yamaha252/Cricket/firmware/README.md

# Прошивка

Свой механизм поиска (шаг 1 из D-32) в `app/`: собирается под свою плату `cricket_tag` и под nRF54L15 DK, на железе не проверен. Поведение описано в [docs/concept.md](../docs/concept.md#режимы-работы), протокол рекламы и GATT — в [docs/protocol.md](../docs/protocol.md).

Прошивка своя, под MIT (D-32). Everytag (GPLv3) — только справочник: его код не копируется, форматы пакетов берутся из открытых описаний.

Порядок работ (D-32):

1. Свой механизм поиска на nRF54L15 DK: наборы рекламы Cricket Coded и Cricket 1M, режимы, драйверы, команда «пищи» из приложения.
2. Позже — наборы Apple Find My и Google Find Hub; координаты из сетей опрашивает приложение (D-33, [docs/app.md](../docs/app.md#краудсорсинговые-сети)).

План:

- Zephyr / nRF Connect SDK v3.4.2 (см. раздел «Версия SDK»), модуль Insight SiP ISP2454-LX (nRF54L15, 1,5 МБ RRAM, 256 КБ ОЗУ; D-29). Две цели сборки: своя плата `cricket_tag/nrf54l15/cpuapp` (описание в `boards/cricket/cricket_tag/`) и отладочная nRF54L15 DK `nrf54l15dk/nrf54l15/cpuapp`.
- Выводы модуля: карта в [hardware/cricket-tag/README.md](../hardware/cricket-tag/README.md#схема) (D-29). На NFC-выводах P1.02/P1.03 — I2C: на nRF54L их освобождает регистр NFCT.PADCONFIG (после сброса 1 — режим NFC), а Zephyr сбрасывает его только на nRF54H, поэтому это делает `board.c` платы. На P2 нет прерываний: CHRG_N читать опросом. Пищалка — PWM20 на P1.04; GRTC PWM (128 Гц) не годится.
- Свои наборы рекламы: Cricket Coded (Coded PHY S8, +8 dBm, подключаемый) и Cricket 1M для телефонов без Coded PHY.
- Наборы рекламы одновременно, через extended advertising: у каждого набора свой identity-адрес (`bt_id_create`, `CONFIG_BT_ID_MAX`, `CONFIG_BT_EXT_ADV_MAX_ADV_SET`), адрес Apple меняется через `bt_id_reset` при остановленном наборе. У Everytag одна реклама за раз и смена публичного адреса всего контроллера — так делать не нужно.
- Apple Find My (позже): формат OpenHaystack — шаблон рекламы 31 байт, адрес из первых 6 байт публичного ключа P-224 (старшие биты 11, статический случайный адрес), до N ключей со сменой по таймеру. Ключи генерирует приложение при привязке и записывает в маячок по своему GATT-сервису.
- Google Find Hub (позже): формат FHN с ключом, полученным приложением; сначала постоянный EID, сменный EID по спецификации FHN (AES, secp160r1, micro-ecc) — доработка, для неё нужны непрерывные часы (SHIP как System ON с GRTC).
- Режимы ON_DRONE, ESCALATE, ALARM, BEACON, STANDBY, LOW_BAT, SHIP.
- Признаки падения: MSP_STATUS (armed) по UART, удар по LIS2DH12, нарастание тревоги как запасной вариант.
- LIS2DH12 на I2C по адресу 0x19 (SA0 на VDD_IO), прерывание по удару на INT1 (ACC_INT1).
- Пищалка: ШИМ на BUZ_DIN, режим PAM8904E выводом BUZ_EN1 (0 — 1x, 1 — 3x; EN2 на VBAT, D-28). У CPT-1117-83 (D-27) громкость высокая широкой полосой 3–8 кГц: частоту или качание частоты подобрать замером.
- Без 5 В от полётника вывод UART_TX перевести во вход, чтобы не питать полётник через его защитные диоды, и выключить UART целиком: включённый приёмник UARTE держит HFCLK (сотни мкА), а UART_RX через 1 кОм висит на обесточенном полётнике.
- Режим 3x PAM8904E (BUZ_EN1 = 1) на полном аккумуляторе даёт размах до 25 В — ровно предел CPT-1117-83. Пока идёт заряд (VBAT до 4,24 В), использовать 1x или не пищать.
- Радио выключено, пока дрон armed: не мешать ELRS 2,4 ГГц.
- Чтение GPS с полётника по MSP, последние координаты в рекламе Cricket.
- Кнопка: выключение тревоги, привязка, режим хранения, загрузчик.
- Обновление прошивки по BLE (MCUboot + SMP) только в окне DFU: кнопка зажата 3 с с подачи питания (см. «Обновление прошивки»).
- Источник LFCLK: кварц 32,768 кГц внутри модуля (LFXO, нагрузочные ёмкости внутренние). Datasheet ISP2454 R7, разд. 2.5, рекомендует 19 пФ и предлагает дописать 19000 в binding `nordic,nrf54l-lfxo.yaml`. В SDK v3.4.2 этого мало: `soc/nordic/nrf54l/soc.c` проверяет `BUILD_ASSERT`, что значение не больше 18 000 фФ (предел внутренних конденсаторов nRF54L). Поэтому в плате стоит 18 пФ — ближайшее допустимое; уход частоты проверить на первых платах. HFXO 32 МГц: в datasheet значения нет, стоит 15 пФ, как у DK. DC/DC включён: токи в datasheet даны с ним.
- Сканирование в приложении на Pixel: режим PHY_LE_ALL_SUPPORTED, не только Coded. Подробности в [docs/app.md](../docs/app.md).

## Заготовка `app/`

Сборка (SDK v3.4.2, sysbuild, результат в `firmware/build/`, он в `.gitignore`):

```bash
firmware/build.sh
```

Аргументы: плата (по умолчанию `nrf54l15dk/nrf54l15/cpuapp`), аргументы `west build` и после `--` аргументы CMake, например `firmware/build.sh cricket_tag/nrf54l15/cpuapp -p always`. Скрипт передаёт `BOARD_ROOT=firmware`, чтобы находилась своя плата. Прошивка по SWD: `west flash -d firmware/build` внутри toolchain-окружения — sysbuild заливает и MCUboot, и подписанное приложение.

Проверено 2026-11-11: обе платы собираются с MCUboot без предупреждений в нашем коде. Предупреждения SDK: `Deprecated symbol NRF_PLATFORM_LUMOS` и `BOOT_MAX_IMG_SECTORS` из конфигурации MCUboot; без закрытого ключа — ещё об отладочном ключе подписи (см. «Обновление прошивки»). Объём — в разделе «Объём флеш-памяти»; DK с `msp-dk.overlay` тоже собирается.

### Плата `cricket_tag`

`boards/cricket/cricket_tag/` — описание платы по карте выводов из [README платы](../hardware/cricket-tag/README.md#схема):

| Узел | Выводы | Что в описании |
|---|---|---|
| MSP | UARTE30: TX P0.02, RX P0.00 | 115200; в состоянии sleep выводы отключены, чтобы не питать обесточенный полётник |
| LIS2DH12 | TWIM21: SDA P1.02, SCL P1.03; INT1 P1.11 | `st,lis2dh12` на 0x19, 400 кГц, подтяжки на плате |
| Пищалка | PWM20 канал 0 на P1.04; EN1 P2.05 | `buzzer-pwm`, `buz-en1-gpios` в `zephyr,user` |
| Вспышка | P2.02 (затвор 2N7002) | `flash-led`, `led0` |
| Кнопка | P1.05 на GND, подтяжка внутри | `user-button`, `sw0`, `mcuboot-button0` |
| VIN_SENSE | P0.03 | `vin-sense-gpios`: прерывание, пробуждение из System OFF |
| CHRG_N | P2.04, подтяжка внутри | `chrg-gpios`, опросом (на P2 нет прерываний) |
| VBAT | AIN3 (P1.07), делитель 1 МОм / 1 МОм | `io-channels`, усиление 1/4, выборка 40 мкс (максимум) из-за делителя 500 кОм с C3 100 нФ |

Лога по UART на плате нет: UARTE30 занят полётником. В отладочной сборке лог идёт по SWD через RTT (включается по умолчанию для этой платы в `app/Kconfig`); RTT держит ток высоким до передёргивания питания, ток мерить только в release-сборке (см. «Низкое потребление»).

На плате приложение берёт 5 В с VIN_SENSE (прерывание, после SHIP появление 5 В будит маячок), заряд — опросом CHRG_N с флагом в рекламе; пока идёт заряд, пищалка работает только в 1x. Долгое удержание кнопки при наличии 5 В в SHIP не переводит: 5 В разбудили бы маячок сразу.

| Файл | Что делает |
|---|---|
| `src/status.c` | состояние маячка и сборка 22 байт полезной нагрузки; ID — CRC32 от FICR DEVICEID |
| `src/adv.c` | наборы Cricket Coded (extended, Coded S8) и Cricket 1M (legacy, с именем в ответе на сканирование), оба подключаемые, +8 dBm через vendor-команду HCI; интервалы по режимам, перезапуск после соединения |
| `src/gatt.c` | сервис Cricket: состояние (read/notify), управление (FIND, SILENCE, DFU, FORGET, DEFAULTS), настройки |
| `src/config.c` | настройки Bluetooth из приложения: имя, мощность и интервалы наборов по режимам, RSSI на 1 м; хранятся в разделе настроек ([protocol.md](../docs/protocol.md#настройки)) |
| `src/buzzer.c` | ШИМ пищалки и вспышка светодиода по шаблонам; вывод EN1 PAM8904E (1x/3x) — если описан в `zephyr,user` |
| `src/battery.c` | VBAT через делитель (`zephyr,user`: `io-channels`, `vbat-full-ohms`, `vbat-output-ohms`); на DK не измеряется, LOW_BAT не срабатывает |
| `src/inputs.c` | кнопка: короткое, удержание 3 с, 8 с (решение по отпусканию); на DK кнопки 1–3 имитируют 5 В, armed и удар |
| `src/msp.c` | MSP v1 к полётнику по `msp-uart`: MSP_BOXIDS (какой бит флагов — ARM; пока disarmed, перечитывается раз в 10 с — полётник могли перенастроить), MSP_STATUS каждые 250 мс, MSP_RAW_GPS каждую секунду; только при 5 В, без них UART приостановлен (`CONFIG_CRICKET_MSP`) |
| `src/impact.c` | удар по LIS2DH12 (`accel0`): «любое движение» на INT1 с фильтром высоких частот, порог `CONFIG_CRICKET_IMPACT_MG` (8 g); датчик работает только при 5 В, иначе приостановлен (`CONFIG_CRICKET_IMPACT`) |
| `src/dfu.c` | обновление по BLE: подтверждение нового образа для MCUboot при старте, фильтр команд SMP вне окна DFU |
| `src/wdog.c` | сторожевой таймер WDT31: 30 с, кормится тиком режимов, останавливается перед System OFF |
| `src/pair.c` | привязка телефона: окно привязки 60 с, отказ в привязке вне окна, ключи в разделе настроек (ZMS), команда FORGET ([protocol.md](../docs/protocol.md#привязка-и-защита)) |
| `src/modes.c` | режимы ON_DRONE…SHIP по [concept.md](../docs/concept.md#режимы-работы), всё в системной очереди работ |

Время режимов (`modes.c`): ESCALATE 45 с с тихим чириканьем раз в 5 с, затем ALARM; ALARM — серия писков раз в 5 с, через 45 мин BEACON; BEACON — писк раз в минуту; удар считается, если был за 10 с до пропажи 5 В; аварийный конец полёта при 5 В (failsafe, дизарм в воздухе, перезагрузка полётника, 30 с без связи с пультом после полёта) — ESCALATE; 5 В, вернувшееся за 10 с после пропажи в полёте, тревогу не гасит; armed без связи — реклама с координатами каждые 2 с; предполётный писк через 5 с после 5 В; правила в [concept.md](../docs/concept.md#признаки-падения); данные MSP считаются свежими 5 с (MSP повторяет состояние armed раз в секунду); при появлении 5 В прошлое состояние armed и удар забываются, до ответа MSP дрон считается disarmed; LOW_BAT ниже 3,4 В, SHIP ниже 3,2 В — только без 5 В, и батарея не измеряется, пока пищит бипер (просадка под нагрузкой).

### MSP: настройка полётника

На полётнике UART, к которому припаян маячок, включить MSP на 115200: в Betaflight — вкладка Ports, колонка Configuration/MSP; в INAV — то же. Маячок спрашивает:

| Команда | Код | Что берёт |
|---|---|---|
| MSP_BOXIDS | 119 | номера битов режимов ARM (постоянный ID 0), BEEPER (13), FAILSAFE (27) в флагах |
| MSP_STATUS | 101 | флаги режимов: `uint32` со смещения 6, остальные байты после счётчика на смещении 15 → armed, BEEPER, FAILSAFE; за ними флаги запрета arm Betaflight: FAILSAFE (бит 1), RX_FAILSAFE (бит 2, нет связи), CRASH_DETECTED (бит 6) |
| MSP_RAW_GPS | 106 | fix, число спутников, широта и долгота (1e-7°), скорость (см/с, смещение 12); координаты берутся при fix ≥ 2 и не меньше 4 спутников |

Номера режимов и раскладка MSP_STATUS сверены с исходниками Betaflight 4.5 (`msp_box.c`, `msp.c`, `runtime_config.h`, `failsafe.c`) 2026-11-11. INAV в MSP_STATUS флаги запрета arm не отдаёт: потеря связи там не видна, остальное то же (не сверено с исходниками INAV).

Чтобы включать писк с пульта, в Betaflight на вкладке Modes назначить режим BEEPER на AUX-тумблер ([concept.md](../docs/concept.md#тумблер-beeper-на-пульте)).

Без ответов MSP маячок полагается на удар и нарастание тревоги (ESCALATE). На полётнике формат не проверен.

### Удар: порог

Вибрация моторов (для полёта без MSP): сумма дисперсий по осям за 1 с выше (0,3 g)², включается после 2 таких секунд, выключается после 3 спокойных. Опрос 50 Гц ниже частот моторов, но разброс остаётся; порог проверить на дроне.

Свободное падение: модуль ускорения ниже 0,4 g дольше 250 мс, опрос 50 Гц, пока есть 5 В (выходные регистры без фильтра, тяжесть видна). В режиме low-power 16 g шаг датчика ~190 мг, так что порог — около двух шагов; проверить на броске.

Порог 8 g по изменению ускорения (фильтр высоких частот убирает тяжесть), датчик 16 g, 400 Гц, режим low-power. Вибрации в полёте и жёсткая посадка не должны его превышать, удар при падении — должен; подобрать на дроне (`CONFIG_CRICKET_IMPACT_MG`). Не проверено: срабатывает ли событие «high» LIS2DH12 по модулю ускорения, то есть на удары в обе стороны по оси.

### Проверка на nRF54L15 DK

| Элемент DK | Роль |
|---|---|
| LED1 (P1.10, PWM20) | пищалка: светится в такт; пьезоизлучатель можно подключить к P1.10 |
| LED0 | вспышка |
| Button 0 | кнопка маячка |
| Button 1 | имитация 5 В: вкл/выкл |
| Button 2 | имитация armed по MSP: вкл/выкл (повторяется раз в секунду, как настоящий MSP) |
| Button 3 | имитация удара |
| VCOM (UART) | лог, 115200 |

Сценарии: при включении — STANDBY. Button 1 → ON_DRONE; Button 2 → armed, реклама выключается; Button 1 → 5 В пропало → ALARM. Без Button 2 и Button 3 пропажа 5 В даёт ESCALATE, а через 45 с — ALARM. Короткое нажатие Button 0 гасит тревогу. Рекламу видно в nRF Connect for Mobile: Manufacturer data `0xFFFF`, на Pixel — сканирование 1M и Coded одновременно ([app.md](../docs/app.md)). Команда FIND — запись `01 0A` в характеристику управления (пищать 10 с). Вне тревоги телефон сначала надо привязать: удержать Button 0 3 с, затем записать команду — nRF Connect предложит привязку. В ESCALATE, ALARM и BEACON FIND (до 60 с) принимается и без привязки.

MSP можно проверить на DK с настоящим полётником до прихода плат: `msp-dk.overlay` включает UART30 (TX маячка P0.00 → RX полётника, RX маячка P0.01 ← TX полётника, общая земля). Сначала в Board Configurator поставить VDD DK 3,3 В (по умолчанию 1,8 В, а логика полётника 3,3 В). Сборка:

```bash
firmware/build.sh nrf54l15dk/nrf54l15/cpuapp -p always -- -DEXTRA_DTC_OVERLAY_FILE=msp-dk.overlay
```

5 В по-прежнему имитирует Button 1: MSP опрашивается, только пока «5 В есть». Так проверяются тумблер BEEPER и failsafe: выключить пульт у armed полётника без пропеллеров, полётник уйдёт в failsafe и disarm-ится, маячок через 45 с чириканья перейдёт в ALARM.

Не проверено на железе: работают ли два подключаемых набора на одном адресе одновременно (стек Zephyr это допускает, каждый набор занимает свой объект соединения, `CONFIG_BT_MAX_CONN=2`); фактическая мощность +8 dBm (лог `TX power` при старте); выход из System OFF по Button 0.

### Сторожевой таймер

WDT31 с таймаутом 30 с перезагружает маячок, если встала системная очередь работ: его кормит тик режимов, который идёт не реже раза в 10 с во всех режимах. Таймер считает и во сне, пауза только когда отладчик остановил процессор. Перед System OFF (SHIP) он останавливается — на nRF54L у WDT есть STOP, — иначе будил бы маячок из хранения. После сброса по сторожевому таймеру в логе предупреждение `previous reset by the watchdog`; маячок стартует в STANDBY или ON_DRONE, как при подключении аккумулятора.

### Низкое потребление

Что сделано для тока в покое:

- Радио, пищалка и вспышка работают по событиям; процессор просыпается на тик режимов раз в 10 с (в ESCALATE и ALARM — раз в секунду).
- UART к полётнику и LIS2DH12 приостановлены без 5 В (`msp.c`, `impact.c`).
- ШИМ пищалки при скважности 0 останавливает периферию (драйвер nRF PWM), PAM8904E выключен низким DIN и EN1.
- Кнопка, VIN_SENSE и INT1 акселерометра ждут фронта через механизм SENSE порта (`sense-edge-mask` в описании платы и в overlay DK), а не через каналы GPIOTE.
- LFCLK от кварца модуля, DC/DC включён (описание платы).
- **Release-сборка** без лога, консоли, RTT и баннера: `app/release.conf`.

```bash
firmware/build.sh cricket_tag/nrf54l15/cpuapp -p always -- -DEXTRA_CONF_FILE=release.conf
```

Как мерить: Power Profiler Kit II в режиме источника вместо аккумулятора на площадках J2 (3,7–4,0 В), провода полётника не подключены, SWD отсоединён; после прошивки снять и снова подать питание. На DK — штатные выводы для измерения тока nRF (Current measurement, см. руководство DK), тоже release-сборка. Сравнить с оценкой [concept.md](../docs/concept.md#энергобюджет-оценка-уточнить-замером): STANDBY ~20–26 мкА, ALARM без пищалки ~65–93 мкА, SHIP ~4–5 мкА (из них модуль 0,6 мкА, остальное утечки TP4054, делители и LDO).

Не проверено: ток не измерялся — ни DK, ни платы ещё нет.

### Обновление прошивки

MCUboot (sysbuild, `app/sysbuild.conf`) с двумя слотами и обменом: новый образ пишется во второй слот, при перезагрузке MCUboot меняет слоты и запускает его в пробном режиме. Прошивка подтверждает образ сама, если поднялись Bluetooth и режимы (`dfu.c`); если новый образ упадёт раньше, после сброса MCUboot вернёт старый.

По воздуху обновление идёт через MCUmgr SMP (сервис SMP Bluetooth, группы image и os, MTU 498). Команды SMP принимаются только в **окне DFU**: кнопку зажать при подаче питания (подключение аккумулятора, сброс или пробуждение из SHIP) и держать 3 с — два коротких писка, в рекламе флаг 6. Окно длится 5 мин и продлевается на минуту каждой принятой командой. Вне окна SMP отвечает «доступ запрещён». Кроме того, SMP работает только по шифрованному соединению, то есть с привязанного телефона. Окно DFU, открытое кнопкой при подаче питания, заодно открывает окно привязки, чтобы обновить можно было и с нового телефона; с уже привязанного телефона окно DFU открывает команда `0x03`.

Как обновить:

1. Собрать: `firmware/build.sh cricket_tag/nrf54l15/cpuapp`. Пакет для обновления — `firmware/build/dfu_application.zip` (подписанное приложение `firmware/build/app/zephyr/zephyr.signed.bin`).
2. Открыть окно DFU на маячке.
3. В приложении nRF Connect Device Manager (Android, iOS) выбрать маячок `Cricket`, Image → Upload, пакет `dfu_application.zip`, режим Test and Confirm. Или с компьютера: `mcumgr --conntype ble --connstring peer_name=Cricket image upload zephyr.signed.bin`, затем `image test <хэш>` и `reset`.

**Ключ подписи — свой, ed25519** (2026-11-11). Закрытый ключ лежит вне репозитория: `~/.cricket/keys/mcuboot-ed25519.pem` (права 600) на компьютере владельца; другой путь задаёт переменная `CRICKET_MCUBOOT_KEY`. `build.sh` передаёт его в `SB_CONFIG_BOOT_SIGNATURE_KEY_FILE`; если файла нет, сборка подписывается открытым отладочным ключом SDK и пишет об этом. Открытая часть — в репозитории, `keys/mcuboot-ed25519.pub.pem`: по ней видно, какому ключу доверяют маячки.

- Публичный ключ зашит в MCUboot. Маячок, прошитый с ним по SWD, принимает по воздуху только образы, подписанные этим закрытым ключом. Сменить ключ на выпущенном маячке можно только по SWD.
- **Потеря закрытого ключа** — обновление по воздуху для всех выпущенных маячков пропадает, останется только SWD. Нужна резервная копия вне компьютера (менеджер паролей или зашифрованный носитель).
- Утечка ключа — любой сможет сделать образ, который маячок примет в окне DFU.
- Проверка образа: `imgtool.py verify -k ~/.cricket/keys/mcuboot-ed25519.pem firmware/build/app/zephyr/zephyr.signed.bin` (внутри toolchain, скрипт в `bootloader/mcuboot/scripts/` SDK). Проверено 2026-11-11: образ проходит с нашим ключом и не проходит с ключом SDK, в `autogen-pubkey.c` MCUboot — наш открытый ключ.

Не проверено на железе: загрузка образа, обмен слотов, откат, скорость передачи.

### Шлюз Bluetooth → MSP для Betaflight Configurator (план)

Цель: настраивать полётник с телефона или ноутбука через маячок, без USB и без отдельного Bluetooth-адаптера на свободном UART. Маячок уже подключён к UART полётника с MSP; шлюз пересылает байты между Bluetooth и этим UART.

**Что известно** (код Configurator, ветка `master`, коммит `9c8b310` от 2026-11-09, `src/js/protocols/devices.ts` и `WebBluetooth.ts`):
- Configurator знает Bluetooth-адаптеры по сервису; среди них «Nordic NRF» — Nordic UART Service (NUS), `6e400001-b5a3-f393-e0a9-e50e24dcca9e`. Подключение через Web Bluetooth (Chrome на компьютере и на Android), в нативных сборках — Capacitor и Tauri.
- **Характеристики Configurator берёт наоборот относительно Nordic:** пишет в `…0003` и ждёт уведомлений от `…0002`. У Nordic (`nus.c` в SDK) наоборот: `…0002` (RX) принимает запись, `…0003` (TX) шлёт уведомления. Значит, пример SDK в чистом виде с Configurator, скорее всего, не заработает: запись в характеристику без свойства write отклоняется. В своей реализации обе характеристики делаются write + notify: запись в любую уходит в UART, уведомления идут по той, на которую подписан телефон. Так работают и Configurator, и обычные NUS-терминалы (nRF Connect, nRF Toolbox).

**Готовое в nRF Connect SDK и почему не целиком:**
- Пример `samples/bluetooth/peripheral_uart` — мост NUS ↔ UART, и библиотека `CONFIG_BT_NUS`.
- Защита библиотеки: либо никакой, либо `BT_NUS_AUTHEN` (привязка с защитой от подмены, MITM). Привязка Just Works у маячка (нет экрана и клавиатуры) этот уровень не даёт, поэтому сервис описывается свой, с теми же UUID и требованием шифрования (~40 строк).
- Пример считает UART своим, а у нас по нему же идёт опрос MSP.
- Пример и библиотека под лицензией Nordic 5-Clause: библиотеку из SDK подключать можно, код примера в MIT-репозиторий не копируется.

**Как сделать** (~300–400 строк, +3–5 КБ флеш-памяти, 1–2 КБ ОЗУ):
- Сервис NUS с шифрованием (только привязанный телефон; первый раз — в окне привязки, Chrome вызовет системную привязку).
- Кольцевые буферы в обе стороны, передача в UART по прерываниям (сейчас `msp.c` шлёт байты с ожиданием); ответы полётника склеиваются в уведомления по размеру MTU.
- Пока телефон подписан, маячок сам полётник не опрашивает, но разбирает ответы, которые идут Configurator: так armed, failsafe и BEEPER остаются известны. Добавить разбор MSP_STATUS_EX (150): Configurator, вероятно, спрашивает его. Кадры MSP v2 (`$X`) и текст CLI пересылаются как есть, разбор их пропускает.
- Доступ только при 5 В и на земле; при взлёте соединение рвётся (D-37).

**Чего шлюз не даст:** прошивку полётника (Betaflight прошивается через USB DFU) и быстрое чтение blackbox (порт 115200, ~11 КБ/с: 16 МБ — около 25 мин).

**Порядок:**
1. На DK проверить то, что уже написано: MSP, failsafe, BEEPER (`msp-dk.overlay`).
2. Там же собрать `peripheral_uart` с overlay на UART к полётнику, 115200, и попробовать Configurator (профиль «Nordic NRF») из Chrome на компьютере и на Pixel 7 Pro. Ожидается отказ из-за перевёрнутых характеристик; если так — поменять в копии примера роли характеристик (локально, не в репозитории) и повторить. Проверить привязку, таймауты Configurator и скорость.
3. Шлюз в своей прошивке, проверка на DK, затем на плате.

### Не сделано

- Шлюз Bluetooth → MSP для Betaflight Configurator — план выше.
- Замер тока и подбор интервалов рекламы и мощности по умолчанию по нему (менять их можно уже из приложения, характеристика «Настройки»).
- Обратная связь при удержании кнопки (писк на 3 и 8 с).
- Наборы Apple и Google (D-32, D-33).

## Объём флеш-памяти

Своя прошивка, проверено 2026-11-11 (SDK v3.4.2, MCUboot с двумя слотами, OTA через SMP, MSP и LIS2DH12, привязка с ключами в ZMS, сторожевой таймер, настройки Bluetooth, тревога по failsafe и тумблер BEEPER, D-36):

| Часть | `cricket_tag` | DK | Доступно |
|---|---|---|---|
| MCUboot | 38,4 КБ | 39,5 КБ | 62 КБ |
| Приложение (слот), отладка | 249,9 КБ | 244,4 КБ | 695,9 КБ (712 560 байт) |
| Приложение (слот), release | 214,2 КБ | 210,9 КБ | 695,9 КБ |
| ОЗУ приложения, отладка | 58 КБ | — | 256 КБ |

Ещё 36 КБ RRAM — раздел настроек `storage`: там ключи привязки и настройки Bluetooth. Запас большой.

Для сравнения, Everytag. Проверено 2026-11-10 (D-29): Everytag (`main`, `prj-smpsvr-lowpower.conf`, MCUboot с двумя слотами, OTA через mcumgr) собирается на **SDK v2.8.0** под `nrf54l15dk/nrf54l15/cpuapp`. Overlay `nrf54l15dk.overlay` из Everytag нужно передать явно (`-DEverytag_DTC_OVERLAY_FILE=…/nrf54l15dk.overlay`): по полному имени платы он не подхватывается, и сборка падает на `watchdog.c` (не включён `wdt31`).

| Часть | Занято | Доступно | % |
|---|---|---|---|
| MCUboot | 36,0 КБ | 48 КБ | 73 % |
| Приложение (слот) | 201,0 КБ | 674 КБ | 30 % |
| ОЗУ приложения | 53,9 КБ | 188 КБ | 29 % |

Если запаса не хватит:

- убрать из mcumgr статистику и taskstat (`CONFIG_STATS`, `CONFIG_MCUMGR_GRP_OS_TASKSTAT`, `CONFIG_MCUMGR_GRP_STAT`);
- уменьшить раздел настроек NVS;
- перейти на MCUboot с одним слотом и обновлением по последовательному каналу (теряется OTA по BLE).

## Порт Everytag на SDK 3.4.2 (справочно)

Проверено 2026-11-09: Everytag собирается на SDK 3.4.2 после правки трёх строк — `bt_hci_cmd_create(...)` → `bt_hci_cmd_alloc(K_FOREVER)` в `src/main.c`, `BT_LE_ADV_OPT_CONNECTABLE` → `BT_LE_ADV_OPT_CONN` и `&auth_uuid` → `&auth_uuid.uuid` в `src/settings.c`; из конфигурации убран `CONFIG_RAM_POWER_ADJUST_ON_HEAP_RESIZE`. Под `nrf54l15dk/nrf54l10/cpuapp` с MCUboot: приложение 186 КБ из 444 КБ, MCUboot 40 КБ из 62 КБ, ОЗУ 56 КБ из 192 КБ. Работа на железе не проверена.

## Версия SDK

Прошивка ведётся на nRF Connect SDK **v3.4.2** (D-32), последнем выпуске на 2026-11-11. Раньше выбирался v2.8.0 только потому, что Everytag не собирается на 3.x (D-18); своя прошивка от этого не зависит. v2.8.0 остаётся установленным, но не используется.

```bash
nrfutil sdk-manager toolchain launch --ncs-version v3.4.2 -- west build -b nrf54l15dk/nrf54l15/cpuapp --sysbuild firmware/app -d firmware/build
```

Примеры кода для Bluetooth из интернета часто написаны под старый API: в 3.x, например, `BT_LE_ADV_OPT_CONNECTABLE` заменён на `BT_LE_ADV_OPT_CONN`, а `bt_hci_cmd_create` на `bt_hci_cmd_alloc`.

## Everytag как справочник

Что полезно посмотреть в [Everytag](https://github.com/vasimv/Everytag), не копируя код:

- после работы через J-Link RTT nRF держит ток в миллиамперах до снятия питания, программный сброс не помогает — замерять ток только после передёргивания питания;
- overlay для nRF54L15 DK включает `wdt31` и канал АЦП на VDD;
- настройки и ключи — в отдельном разделе NVS, переживают OTA; при первой прошивке стирать флеш целиком;
- приём настроек по BLE короткими окнами (2 с в минуту), чтобы не тратить ток на подключаемую рекламу.
