yamaha252/Cricket/hardware/cricket-tag/README.md

# cricket-tag

KiCad-проект маячка. Готовы библиотека проекта и схема ревизии A на модуле ISP2454-LX (D-29; ERC: 0 ошибок, 0 предупреждений). Плата 17 × 32 мм разведена полностью, убрана (D-40) и прошла ревью схемы и разводки (D-41): DRC со сверкой со схемой — 0 нарушений, 0 неподключённых, вся земля связна. Как она разведена — раздел «Разводка», картинки текущей платы — `render/`: [схема](render/schematic.png), [верх](render/3d-top.png), [низ](render/3d-bottom.png), [медь](render/copper-top-bottom.png). Картинки платы — `kicad-cli pcb render --side top|bottom` и `kicad-cli pcb export svg` слоёв F.Cu и B.Cu. Картинку схемы после правок пересобирают: `kicad-cli sch export pdf` с `--exclude-drawing-sheet`, затем `pdftoppm -png -r 130 -singlefile`. Минимумы DRC под JLCPCB 2 слоя (дорожка 0,1 мм, зазор 0,127 мм, via от 0,45/0,3 мм с кольцом 0,1 мм, медь до кромки 0,2 мм; классы цепей — в разделе «Разводка»), стек 0,6 мм FR4, ENIG.

## Параметры платы, ревизия A

- 17 × 32 мм (см. «Размер платы» и «Разводка», D-29), 2 слоя, 0,6 мм.
- Все компоненты сверху, плата собирается заводом целиком. Снизу только медные площадки под провода и SWD (D-26): [docs/manufacturing.md](../../docs/manufacturing.md).
- Модуль Insight SiP ISP2454-LX (nRF54L15, D-29) в углу платы на дальнем конце от хвоста, антенной половиной к торцу: в 1 мм от торцевой кромки и в 1,3 мм от боковой (datasheet: 1 мм; +0,3 мм под дорожки VDD и SWD). У торца полоса 14 × 5 мм без меди на обоих слоях. Подробности в [docs/components.md](../../docs/components.md#требования-к-встроенной-антенне).
- Аккумулятор снизу, до 15 мм длиной вместе с платой защиты, провода паяются к J2.

## Порядок работы над схемой

1. ~~Символ и футпринт модуля~~ — готово: ISP2454-LX (D-29), см. раздел «Библиотека».
2. ~~Вход 5 В, VIN_SENSE, TP4054, площадки аккумулятора, делитель VBAT, LDO~~ — готово, см. раздел «Схема». Площадки полётника J1 нарисованы здесь же, резисторы UART — на шаге 6.
3. ~~Модуль, площадки SWD~~ — готово, карта выводов ниже (D-29). Кварц и развязка модуля с D-29 внутри ISP2454-LX. TC2030-NL заменён четырьмя площадками J3 (D-26).
4. ~~PAM8904E и излучатель~~ — готово, излучатель CPT-1117-83 (D-27), см. «Размер платы».
5. ~~Светодиод с ключом от VBAT, кнопка, LIS2DH12~~ — готово, см. «Схема».
6. ~~Резисторы 1 кОм в UART между площадками полётника и модулем~~ — готово.
7. ~~Поле `LCSC Part` в каждом символе~~ — заполнено у всех деталей в BOM: 20 уникальных позиций (после D-29 ушли кварц и конденсаторы 18 пФ). Без него только площадки J1–J3 (`in_bom no`).
8. ~~ERC до нуля ошибок~~ — 0 ошибок, 0 предупреждений.

Плата с ISP2454-LX разведена (см. «Разводка»). Выходные файлы делает `make_fab.sh` (в `fab/`), по ним 2026-11-10 получены расчёты JLCPCB (D-30) и NextPCB (D-31), см. [docs/cost.md](../../docs/cost.md). После уборки меди D-40 (2026-11-12) gerber изменились, BOM и CPL прежние: перед оплатой любого из расчётов загрузить новый `cricket-tag-gerbers.zip`. Завод для первого заказа не выбран, варианты сравниваются ([docs/manufacturing.md](../../docs/manufacturing.md#варианты-заводов)). Медь местами ближе 0,4 мм к краю, поэтому панель только с фрезеровкой и mouse bites, не V-cut; разделяет завод (D-31).

Компоненты: [docs/components.md](../../docs/components.md). Заметки по схеме: [docs/concept.md](../../docs/concept.md#заметки-для-схемы).

## Схема

`cricket-tag.kicad_sch` строит скрипт `gen_schematic.py` по шагам из списка выше. Каждый вывод подключён коротким проводом к метке цепи или к символу питания. Источник схемы — скрипт: ручные правки в KiCad пропадут при следующем запуске. Когда схема будет готова и её начнут править в KiCad, файл схемы станет основным, а скрипт — историей.

```bash
python3 hardware/cricket-tag/gen_schematic.py
kicad-cli sch erc hardware/cricket-tag/cricket-tag.kicad_sch -o /tmp/erc.rpt
```

Если в KiCad не настроены глобальные таблицы библиотек (их создаёт первый запуск KiCad), ERC сообщает «library not included». Тогда ERC запускают с переменной `KICAD_CONFIG_HOME`: она указывает на каталог `10.0/` с копиями `sym-lib-table` и `fp-lib-table` из `/Applications/KiCad/KiCad.app/Contents/SharedSupport/template/`.

Узел питания (шаг 2):

| Цепь | Что на ней |
|---|---|
| +5V | J1.1 (полётник), анод D1 B5819W, верх делителя VIN_SENSE |
| VCHG | катод D1, C1 10 мкФ, TP4054 VCC |
| VBAT | TP4054 BAT, C2 1 мкФ, J2.1 (аккумулятор), делитель VBAT, вход и EN LDO, C4 1 мкФ |
| +3V3 | выход TPS7A0233, C5 1 мкФ |
| VIN_SENSE | R1 1 МОм / R2 1,5 МОм (D-23) → GPIO модуля |
| VBAT_SENSE | R4 / R5 по 1 МОм, C3 100 нФ → АЦП модуля |
| CHRG_N | открытый сток TP4054 → GPIO с внутренней подтяжкой |
| PROG | R3 22 кОм: ток заряда ≈ 45 мА |

Модуль (шаг 3, D-29): U1 ISP2454-LX — кварцы 32 МГц и 32,768 кГц, DC/DC и развязка VDD внутри модуля, поэтому C6–C9 и Y1 из прежней схемы нет (позиционные обозначения не перенумерованы). Площадки SWD J3: 1 VDD, 2 SWDIO, 3 SWCLK, 4 GND (только медь снизу, `in_bom no`, D-26). OUT_MOD соединён с OUT_ANT; ~RESET (подтяжка внутри) и неиспользуемые GPIO помечены «не подключено».

Карта выводов модуля (D-29):

| Площадка | Порт | Цепь | Примечание |
|---|---|---|---|
| 32 | P0.02 | UART_TX | UARTE30 → RX полётника через 1 кОм (шаг 6) |
| 29 | P0.00 | UART_RX | UARTE30 ← TX полётника через 1 кОм. **Внутренняя** площадка: переходное под модулем, закрытое маской |
| 34 | P0.03 | VIN_SENSE | есть ли 5 В (цифровой вход, D-23), пробуждение из System OFF |
| 36 | P1.07/AIN3 | VBAT_SENSE | АЦП |
| 38 | P1.05 | BUTTON | кнопка на GND, внутренняя подтяжка, пробуждение |
| 40 | P1.04 | BUZ_DIN | PWM20, 3–8 кГц на PAM8904E |
| 42 | P2.05 | BUZ_EN1 | режим PAM8904E |
| 44 | P2.04 | CHRG_N | внутренняя подтяжка; читается опросом (на P2 нет прерываний) |
| 48 | P1.11 | ACC_INT1 | прерывание LIS2DH12, пробуждение. Проведён заранее: переходное справа от модуля, нижний слой под модулем, переходное у U5, сверху к INT1 |
| 2 | P1.02/NFC1 | I2C_SDA | NFC-вывод в режиме GPIO |
| 4 | P1.03/NFC2 | I2C_SCL | NFC-вывод в режиме GPIO, «тактовый» (SCL можно только на такой) |
| 46 | P2.02 | LED | затвор 2N7002; по каналу под модулем к R9 и Q1 |
| 6 | P2.01 | — | свободен (сбоку модуля; LED отсюда пересекал I2C) |
| 26, 28, 30 | VDD, SWDIO, SWDCLK | +3V3, SWDIO, SWDCLK | вдоль левой кромки, дальше на J3 |

Между наружными площадками модуля 0,25 мм: дорожка между ними не проходит, сигналы — только с наружного ряда, кроме UART_RX. Порты nRF54L15 (datasheet, Pin assignments): на P2 нет прерываний и пробуждения из System OFF; АЦП, PWM20–22, UARTE20/21 и TWIM20/21 — на P1; UARTE30/TWIM30 — на P0; SCL — только на «тактовом» выводе. На наружном ряду P0 — 2 вывода, P1 — 6, а сигналов, которым нужен P0 или P1, девять: поэтому UART_RX с внутренней площадки. GRTC PWM на P0.03 для пищалки не годится — фиксированные 128 Гц. NFC-выводы в прошивке перевести в GPIO (на nRF54L — отключить NFCT, `CONFIG_NFCT_PINS_AS_GPIOS`).

GND модуля: угловые 1, 7, 25, 31 — каждая на своё переходное; внутренние 8 и 21, 23, 24 — дорожками к угловым 7 и 25; центральные 12, 14, 16, 18 не подключены: на двух слоях их не вывести, производитель для неполного набора выводов рекомендует только наружные площадки (datasheet, разд. 4.2).

Пищалка (шаг 4): U4 PAM8904E питается от VBAT, C10 2,2 мкФ на входе. Летающие конденсаторы C11 (CP1–CN1) и C12 (CP2–CN2) по 1 мкФ 25 В, на VOUT C13 и C14 по 1 мкФ 25 В. Выходы VO1 и VO2 дифференциально подключены к BZ1 CPT-1117-83 (D-27). EN2 постоянно на VBAT (D-28), режим задаёт EN1 с модуля: 0 — 1x, 1 — 3x; режима 2x нет. DIN = 0 выключает драйвер (ток 0,008 мкА). Режим 3x допустим только при VIN ≤ 4,5 В, у нас VBAT ≤ 4,2 В. Центральная площадка PAM8904E (13) — на GND.

Светодиод, кнопка, акселерометр (шаг 5): белый D2 KT-0603W от VBAT через R8 220 Ом (≈6 мА при 4,2 В), ключ Q1 2N7002 на GPIO LED, R9 10 кОм держит затвор на земле, пока GPIO не настроен. Кнопка SW1 TS-1088 замыкает BUTTON на GND, подтяжка внутри nRF. U5 LIS2DH12 по I2C с подтяжками R10, R11 10 кОм к +3V3, развязка C15 100 нФ и C16 1 мкФ. CS на VDD_IO — режим I2C. SA0 тоже на VDD_IO: адрес 0x19 и нет тока через внутреннюю подтяжку SA0, которую иначе пришлось бы отключать в прошивке. Вывод 5 (Res) на GND, INT1 → ACC_INT1, INT2 не подключён. В KiCad нет символа LIS2DH12, взят LIS2DE12 из `Sensor_Motion` — та же разводка LGA-12 2 × 2 мм.

UART (шаг 6): R6 1 кОм между FC_TX и UART_RX, R7 1 кОм между UART_TX и FC_RX.

ERC: 0 ошибок, 0 предупреждений. Одно замечание исключено намеренно — `pin_to_pin` между SA0 LIS2DH12 (двунаправленный вывод) и выходом LDO на +3V3. Исключение с пояснением прописывает в `cricket-tag.kicad_pro` сам `gen_schematic.py`, ключ привязан к положению вывода: при переносе U5 он пересчитывается.

### Размер платы

Излучатель — CPT-1117-83 (D-27), посадочное место с лепестками 15,5 × 9 мм. В D-25 его меняли на CPT-9019A (10 × 9 мм), пока плата была 13–14 мм шириной; после отказа от разъёмов (D-26) площади хватило, и он вернулся ценой 2 мм ширины.

Расстановка (`floorplan/floorplan.py`) ставит все детали ревизии A, включая шаги 5–6, по их курятникам на пробную плату, DRC ищет перекрытия. Разводка добавила к `w16b` 1 мм ширины и 2,8 мм длины (D-28).

| Вариант | Размер | Картинка | Что |
|---|---|---|---|
| `w16b` | 16 × 29,2 мм | `floorplan/floorplan-w16b-cpt1117.png` | модуль с антенной впереди, рядом акселерометр, кнопка, светодиод; под модулем кварц, затем CPT-1117-83 лепестками вдоль платы, справа от него драйвер и питание. Провода и SWD снизу (D-26, D-27) |
| `w17b` | 17 × 30,2 мм | — | w16b, раздвинутый на 1 мм в ширину и длину под разводку |
| `w17c` | 17 × 31 мм | — | расстановка по выводам: кварц под XL1/XL2, делители и UART под нижним рядом модуля, конденсаторы драйвера у его выводов, светодиод у ключа |
| `isp_c` — **текущий** | **17 × 32 мм** | — | ISP2454-LX (D-29): расстановка по выводам модуля, светодиод с ключом в углу у торца, акселерометр справа от модуля, драйвер с конденсаторами у выводов, кнопка в хвосте; канал 1,8 мм между модулем и рядом резисторов; по ней разведена плата |
| `w17d` | 17 × 32 мм | — | ANNA-B402: w17c с зоной под модулем выше на 1 мм; по ней была разведена плата D-28 |
| `w14s` | 14 × 29,3 мм | `floorplan/floorplan-w14s.png` | то же с CPT-9019A, драйвер сбоку, питание в хвосте (D-26) |
| `w14` | 14 × 35,9 мм | `floorplan/floorplan-w14.png` | то же с разъёмами JST SH в хвосте, до D-26 |
| `w18s` | 18 × 22,8 мм | `floorplan/floorplan-w18s.png` | излучатель рядом с модулем. Та же площадь, но металл излучателя в ~5 мм от антенны и аккумулятор не длиннее 12 мм; не выбран |
| `isp_a16` | 16 × 29,4 мм | `floorplan/floorplan-isp2454.png` (в середине; слева `w16b`) | кандидат: ISP2454-LX (nRF54L15) вместо ANNA-B402, плотно, как `w16b`. Без кварца и развязки модуля (внутри). Зона без меди у торца 14 × 5 мм |
| `isp_a` | 17 × 29,2 мм | — | то же на 17 мм ширины |
| `isp_b` | 17 × 30,1 мм, торец 10 мм | `floorplan/floorplan-isp2454.png` (справа) | `isp_a` с узким торцом у антенны (10 × 5 мм) по datasheet ISP2454: минус 35 мм² платы |

- 22 × 13 мм не получается: сумма курятников около 420 мм² с разъёмами и ~330 мм² без них, а у такой платы 286 мм². Крупнее всего модуль с полосой без меди у торца (~105 мм²) и излучатель (102 мм²).
- Длину набирают ряды деталей вдоль платы (`isp_c`): модуль с отступом от торца 9 мм, канал и ряд резисторов под ним ~5 мм, излучатель с лепестками 16 мм, хвост с кнопкой 2 мм. Питание и драйвер стоят в колонке справа от излучателя и длины не добавляют.
- Аккумулятор лежит снизу и не должен заходить под антенну и модуль: металл оболочки расстраивает антенну. На плате 32 мм перед ним стоят площадки проводов, поэтому аккумулятор не длиннее 15 мм вместе с платой защиты: 401012 (~40 мА·ч) или 401015 (~50 мА·ч).
- Акселерометр по длине ничего не занимает: он стоит в полосе рядом с модулем, которая есть в любом случае.

Площадки J1 (полётник: 1 — 5 В, 2 — GND, 3 — TX полётника, 4 — RX полётника) и J2 (аккумулятор: 1 — плюс, 2 — минус) — только медь снизу, `in_bom no` (D-26). Цепи подписаны на нижней шелкографии: RX, TX, G, 5V у J1 (TX и RX — выводы полётника), «+» и «−» у J2, V (3,3 В), IO, CK, G у J3.

## Разводка

Плату строит и разводит `route.sh` (D-28). Он перезаписывает `cricket-tag.kicad_pcb`, ручные правки платы в KiCad при этом пропадут.

```bash
FREEROUTING=/path/to/freerouting-2.5.0.jar sh hardware/cricket-tag/route.sh
```

Шаги:

1. `gen_pcb.py` — детали из списка соединений схемы по расстановке `floorplan/floorplan.py` (вариант `isp_c`, D-29; до этого `w17d`), контур, подписи площадок снизу. Закреплённые заранее: вывод из-под модуля (`module_escape`, см. ниже) и обвязка PAM8904E (`driver_ground`, `driver_routes`, см. ниже).
2. `export_dsn.py` — Specctra DSN. С D-29 без `--planes`: GND разводится как обычная цепь. С `--planes` Freerouting считал нижний слой сплошной землёй, ставил к каждой площадке GND переходное и сам же резал этот слой дорожками — нижняя земля под модулем оказывалась отрезанной от остальной, а DRC показывал это только как «зона — зона».
3. Freerouting 2.5 без интерфейса, 150 проходов. Нужна Java 25+: стоит OpenJDK из Homebrew (`/opt/homebrew/opt/openjdk/bin/java`), системная Java 21 не подходит.
4. `import_ses.py` — разводка обратно в плату, заливки GND на обеих сторонах; `cleanup.py` — висящие обрывки.
5. Доводка по отчёту DRC, до четырёх кругов: `autofix.py` разбирает отчёт, `maze.py` (A* по сетке 0,05 мм на двух слоях) прокладывает оставшиеся пары площадок, а цепь, которая парой не легла, снимает (`ripup.py`) и прокладывает заново целиком; одиночные GND отводит на переходное `fanout.py`. `connect.py repair` сращивает обрывы Freerouting.
6. `widen.py` — сужения Freerouting у площадок до 0,1 мм; `stitch.py` — ~130 переходных GND сшивают заливки; `cleanup.py --gnd-vias` убирает те, что остались без второй стороны.
7. `tidy.py` — уборка (D-40): `gnd` снимает дорожки GND, лежащие внутри заливки, `dust` — пыль из отрезков внутри площадок, `merge` склеивает микросегменты и спрямляет лесенки до 0/45/90°, `widen` расширяет тонкие дорожки до 0,15 мм, где есть зазор, `vias` ставит второе переходное островкам заливки, которые держатся на одном (D-41).
8. DRC.

Freerouting от запуска к запуску даёт разное (порядок деталей в DSN зависит от их UUID), поэтому доводка выбирается по DRC, а не списком. В одном проходе `route.sh` обычно остаётся 1–3 замечания, каждый раз разных; автоматически они до нуля не сходятся.

Плата в репозитории (D-29, ISP2454-LX) — лучший из ~25 проходов `route.sh`, в котором остались неразведёнными две связи драйвера, BUZ_CP2 (U4.11 → C12.1) и BUZ_P (U4.7 → BZ1.1); их довёл `finish_driver.py` (ниже), затем `stitch.py` и `cleanup.py --gnd-vias`. Итог: DRC со сверкой со схемой — 0 нарушений, 0 неподключённых, все 35 площадок GND в одной земле.

Уборка D-40 (2026-11-12) сделана на этой же плате, без повторной трассировки: `tidy.py` снял 119 из 126 незакреплённых дорожек GND, отрезков стало 329 вместо 657. DRC после неё — 0 нарушений и 0 предупреждений при `--severity-all`.

Ревью D-41 добавило два переходных GND: второе в островок земли акселерометра и C10 и второе внутри J2.2 — минус батареи снизу зажат дорожками и раньше выходил на землю через одно отверстие в центральной площадке драйвера.

Площадки под ручную пайку J1 и J2 (D-40): чужая медь не ближе 0,3 мм. Заливку держат зоны без заливки `wire-pads-J1`, `wire-pads-J2` на нижнем слое (`gen_pcb.wire_pad_keepouts`), дорожки и переходные — правило `wire_pad_clearance` в `cricket-tag.kicad_dru`; `maze.py`, `stitch.py` и `tidy.py` учитывают тот же зазор (`gen_pcb.WIRE_PAD_GAP`). Между площадками 0,8 мм: дорожка 0,15 мм проходит только по середине. `export_dsn.py` этот зазор Freerouting не передаёт, после `route.sh` его нарушения покажет DRC, править их вручную.

Обвязка драйвера (`gen_pcb.py`, `DRIVER_TRACKS`, `DRIVER_VIAS`) закреплена заранее, потому что Freerouting её не находит. По кругу выводы PAM8904E идут 12 VBAT, 11 CP2, 10 VOUT, 9 CP1, 8 CN2, 7 OUTP: CP2 к C12 и CP1 к C11 в один слой не развести, а снизу под драйвером лежат площадки батареи J2, так что переходные встают только вокруг них:

- CP2 с вывода 11 идёт дорожкой 0,12 мм по диагонали между углом C10.2 и выводом 10 (щель 0,41 мм) к переходному между C10 и C13, по низу — к переходному над C12;
- C13 и C14 ради этого переходного сдвинуты на 0,15 мм вправо (`floorplan.py`, `isp_c`);
- VOUT идёт по диагонали к C13 и C14;
- CP1 уходит переходным над правым верхним углом J2.1 (место одно: между дорожкой VOUT, площадкой C12.1, переходным CP2 и зазором 0,3 мм до J2.1) и по низу справа от J2 к переходному у C11;
- переходное центральной площадки (GND) стоит у её левого края и снизу соединено дорожкой с J2.2: между площадками батареи меди нет (D-40);
- VBAT вывода 12 через переходное у вывода 1 выходит прямо на J2.1; прежняя связь J2.1 с верхним VBAT по низу через x = 114 мм стала лишней и снята, потому что пересекала CP2;
- OUTP идёт к переходному справа от C12, дальше к излучателю её разводит Freerouting или `maze.py`.

`finish_driver.py` ставит эту обвязку на уже разведённую плату, не трогая остальное:

1. Сдвигает C13 и C14 вместе с концами их дорожек.
2. Снимает старую разводку цепей обвязки и пересекавшие её незакреплённые дорожки.
3. Ведёт OUTP от переходного к BZ1.1 через `maze.py`. Дорожки GND лабиринт может пересечь за штраф (`SOFT_COST`), а те, что пересёк, снимаются: землю держат заливки.
4. Снимает висящие обрывки, в том числе два лишних переходных SWDIO и SWDCLK у левой кромки.

После него нужны `stitch.py` и `cleanup.py --gnd-vias`: заливка в одном кармане над J1 (R2.2) теряла связь, пока не встало сшивающее переходное. `maze.py` с D-29 спрямляет путь по прямой видимости, без ступенек сетки.

Вывод из-под модуля (`gen_pcb.py`, `ESCAPE_TRACKS`) закреплён заранее: VDD, SWDIO, SWDCLK по полосе 1,3 мм у левой кромки на переходные; UART_RX с внутренней площадки 29 на переходное под модулем; ACC_INT1 с площадки 48 через два переходных и нижний слой под модулем к INT1 акселерометра; угловые GND 25, 7, 31 на свои переходные; внутренние GND 8 и 21–24 к угловым; OUT_MOD ↔ OUT_ANT.

Ход перебора D-29 и что не сработало: закреплённая разводка драйвера, скопированная со старой платы (ломает соседние цепи и требует переноса J2; сработала обвязка, нарисованная заново под J2, см. выше), смена порядка в `maze.py`, `stitch.py`-подобная сшивка островков. Повторный `route.sh` даёт каждый раз другое, обычно 3–10 неразведённых. С закреплённой обвязкой драйвера пять проверочных проходов с нуля (2026-11-10) дали 4–8 неподключённых площадок, обвязка и OUTP легли во всех; оставались VBAT (питание R8, U2, R4), SWDIO/SWDCLK к J3, I2C — их доводят вручную или `maze.py`.

Повторно запускать `route.sh` стоит только при изменении схемы или расстановки: он перезапишет плату, и доводку придётся проверить заново. Мелкие правки удобнее делать прямо в KiCad.

Правила (D-28, JLCPCB, 2 слоя): сигналы 0,15 мм с зазором 0,13 мм, питание 0,25 мм, переходные 0,5/0,3 и 0,6/0,3 мм, зазор отверстие — медь 0,2 мм, отверстие — отверстие 0,25 мм, медь до края 0,2 мм.

## Библиотека

Библиотека `cricket` подключена к проекту через `sym-lib-table` и `fp-lib-table` с путём `${KIPRJMOD}/lib/`. Пользовательские символы, футпринты и 3D-модели кладутся туда же.

| Элемент | Что это |
|---|---|
| `cricket:ISP2454-LX` | символ модуля (D-29). Выводы названы по портам nRF54L15 (`P1.04/AIN0`), номер вывода — номер площадки модуля. Справа все GPIO по портам, слева питание, ~RESET, SWD, OUT_MOD/OUT_ANT, внизу 12 GND отдельными выводами (центральные 12–18 на схеме «не подключено»), механические 49–62 скрыты. Поле `LCSC Part` = C44975104 |
| `cricket:ISP2454-LX_CornerAntenna`, `cricket:ISP2454-LX_NarrowEnd` | футпринты модуля: площадки по библиотеке Eagle производителя, зона без меди и курятник до кромки по datasheet разд. 4.3 — в углу платы (боковая кромка в 1,3 мм) и для торца 10 мм |
| `cricket:ANNA-B402` (до D-29) | символ модуля. Выводы названы по портам nRF52833 (`P0.20`), номер вывода — номер площадки модуля. Справа все GPIO, слева питание, SWD, кварц, антенна и USB, внизу GND (11 выводов в одной точке). Поле `LCSC Part` = C6124130 |
| `cricket:TP4054`, `cricket:TPS7A0233`, `cricket:PAM8904E`, `cricket:VBAT` | зарядка, LDO, драйвер пищалки и символ питания VBAT; их генерирует `lib/gen_symbols.py` |
| `cricket:Diodes_W-QFN2020-12_2x2mm_P0.4mm_EP1.0x1.0mm`, `cricket:SameSky_CPT-9019A-SMT`, `cricket:SameSky_CPT-1117-83-SMT` | футпринты PAM8904E и излучателей (стоит CPT-1117-83, CPT-9019A — запасной, D-27) по рекомендованным рисункам площадок производителей; их генерирует `lib/gen_footprints.py` |
| `cricket:WirePads_1x04_P2.0mm`, `cricket:WirePads_1x02_P2.0mm`, `cricket:SWD_Pads_1x04_P2.54mm` | площадки под провода (1,2 × 2,0 мм, шаг 2 мм) и SWD (круглые 1,2 мм, шаг 2,54 мм) для нижней стороны: без пасты, исключены из BOM и CPL (D-26); тоже из `lib/gen_footprints.py` |
| `cricket:ANNA-B402_CornerAntenna` (до D-29) | футпринт: 56 площадок по рис. 5 datasheet, противовес на выводе 1 (медь под маской), зона запрета дорожек, via и заливки на F.Cu и B.Cu по рис. 33–34 руководства u-blox. Положение кромок, как у u-blox, отмечено на Cmts.User |

Символ и футпринты ISP2454-LX генерирует `lib/gen_isp2454.py`, там же источники размеров. Правки нужно вносить в скрипт: ручные правки в редакторе KiCad пропадут при следующем запуске. Дорожка или via в антенной зоне дают ошибку DRC `items_not_allowed`.

Сверка с datasheet isp_ble_DS2454 R7 (2026-11-10): назначение всех 62 площадок и их положение совпадают с таблицей раздела 3 и чертежом раздела 4.1. Размеры площадок взяты из библиотеки Eagle производителя и отличаются от чертежа R7 не больше чем на 0,05 мм: в футпринте сигнальные 0,4 × 0,4 мм и угловые 0,8 × 0,8 мм, на чертеже наружные 0,4 × 0,35 мм, угловые 0,75 × 0,75 и 0,8 × 0,75 мм, центры угловых и нижних механических смещены на 0,025 мм. Допуск чертежа ±0,03 мм, зазор 0,25 мм между площадками сохраняется, плата не менялась.

На схеме с ISP2454-LX:

- OUT_MOD (22) соединить с OUT_ANT (20);
- ~RESET (13) и свободные GPIO — «не подключено»;
- механические площадки 49–62 остаются без цепей, но паяются (datasheet, разд. 3).

Символ и футпринт ANNA-B402 (до D-29) генерирует `lib/gen_anna_b402.py`; они оставлены в библиотеке для старых вариантов расстановки и на плате не используются.
