yamaha252/Cricket/app/README.md

# Приложение Cricket

Flutter, Android первым (D-38), iOS из того же кода (D-39). Функции и ограничения — в [docs/app.md](../docs/app.md), протокол — в [docs/protocol.md](../docs/protocol.md).

Оформление пока черновое: сначала функции.

## Сборка

```bash
cd app
flutter pub get
flutter test
flutter build apk --debug
```

Нужны Flutter 3.44+, Android SDK 36 и JDK 17+. Минимальный Android — 8.0 (API 26: `ScanSettings.setPhy`). Запуск на телефоне: `flutter run` с подключённым по USB телефоном.

### iOS

```bash
cd app
flutter run -d <симулятор или iPhone>
flutter build ios --release --no-codesign
```

Нужен Xcode (проверено с 27.2); плагины подключаются через Swift Package Manager, CocoaPods не нужен. Минимальная iOS — 15.0. Для установки на iPhone в Xcode нужно выбрать команду подписи (Runner → Signing & Capabilities); в репозитории её нет.

`flutter build ios --simulator` с Flutter 3.44.6 и Xcode 27 падает: `lipo -verify_arch` в Xcode 27 не принимает две архитектуры, а Flutter передаёт `arm64 x86_64`. `flutter run -d <симулятор>` собирает одну архитектуру и работает. В симуляторе нет Bluetooth: приложение показывает «Bluetooth недоступен», карта работает.

## Что сделано

| Функция (docs/app.md) | Состояние |
|---|---|
| 1. Сканер Coded + 1M | есть: `PHY_LE_ALL_SUPPORTED`, legacy выключен, фильтр по Company ID `0xFFFF` и версии 2; видно, на каком PHY пришли пакеты |
| 2. Тепло-холодно | есть: RSSI со сглаживанием, оценка расстояния, тренд «теплее/холоднее», звук как у металлоискателя, экран не гаснет |
| 3. Карта и пеленг | есть: запись пар «GPS + RSSI», область вероятного положения (перебор по сетке, взвешенный МНК) |
| 4. Команда «пищи» | есть: FIND 10/30/60 с, стоп |
| 5. Координаты GPS полётника | есть: маркер на карте с возрастом координат |
| 6. Привязка, настройки, DFU | привязка, настройки (TLV), SILENCE, окно DFU, FORGET, DEFAULTS — есть; само обновление прошивки — нет (план: `mcumgr_flutter`) |
| 7. Find My / Find Hub | нет (D-33, позже) |
| 8. Чужой потерянный маячок | есть: чтение контакта владельца, FIND |

Своими маячки становятся после привязки (или вручную); список хранится в телефоне.

## Офлайн

Без сети работает всё: Bluetooth, GPS (на Android через `LocationManager`, без Play-сервисов; на iOS Core Location работает без сети сам), пеленг, карта из памяти.

- **OpenTopoMap** — подложка по умолчанию: горизонтали, отмывка рельефа, лес, тропы. Просмотренные тайлы сохраняются; на вкладке «Офлайн-карты» видимая область скачивается для масштабов на выбор (до 30 000 тайлов за раз).
- **OpenStreetMap** — только кэш просмотренного: массовая загрузка запрещена правилами tile.openstreetmap.org.
- **MBTiles** — любая растровая карта (спутник, топо), подготовленная на компьютере (например, в MOBAC или QGIS), добавляется файлом.

Тайлы лежат в `tiles/<источник>/z/x/y.png` в каталоге поддержки приложения (`files/` на Android, `Library/Application Support/` на iOS).

## Устройство

- `android/app/src/main/kotlin/dev/cricket/cricket/CricketBle.kt` — свой BLE-слой: сканирование, GATT (одна операция за раз), привязка, разрешения, писк `ToneGenerator`, экран без сна. Сторонних BLE-плагинов нет: у `flutter_blue_plus` 2.x платная лицензия для коммерции.
- `ios/Runner/CricketBle.swift` — тот же слой на CoreBluetooth с теми же каналами (D-39): только 1M, вместо адреса UUID периферии, привязка чтением зашифрованной характеристики настроек, писк через `AVAudioEngine`.
- `lib/ble/ble.dart` — Dart-обёртка каналов `cricket/ble`, `cricket/scan`, `cricket/conn`.
- `lib/protocol/cricket.dart` — реклама v2, UUID, команды, настройки TLV с проверкой как в прошивке.
- `lib/state/` — список маячков, GPS, пеленг.
- `lib/map/tiles.dart` — источники тайлов, кэш, загрузка областей, MBTiles.
- `lib/ui/` — экраны.

## Проверено

- Юнит-тесты: разбор рекламы, настройки TLV, пеленг на синтетическом обходе (ошибка < 25 м), тайловая математика.
- Эмулятор Pixel 7 Pro (API 35): запуск, сканирование стартует, карта OpenTopoMap грузится и показывается без сети из кэша, загрузка области.
- Симулятор iPhone 17 Pro (iOS 26.4): сборка, запуск, «Bluetooth недоступен» (в симуляторе его нет), тайлы OpenTopoMap скачиваются и сохраняются. Релизная сборка под iPhone без подписи собирается.
- С настоящим маячком и на Pixel 7 Pro / iPhone **не проверено**: приём Coded, GATT, привязка.

## Не сделано

- Фоновое сканирование (foreground service): сейчас скан останавливается в фоне, если не идёт запись пеленга, и Android может его прервать.
- Обновление прошивки по BLE (MCUmgr SMP).
- Сети Apple Find My и Google Find Hub (D-33).
- iOS: фоновое сканирование, подпись и проверка на настоящем iPhone.
- Подпись релизной сборки, иконка, оформление.
