yamaha252/Cricket/hardware/cricket-seeker/README.md

# cricket-seeker

Приёмник для поискового дрона. Не начат. Состав и варианты радиомодулей — в `docs/components.md`, метод пеленга — в `docs/concept.md`.
