yamaha252/Cricket/docs/concept.md

# Концепция Cricket

Требования: [requirements.md](requirements.md). Почему выбрано именно так: [decisions.md](decisions.md). Компоненты: [components.md](components.md).

## Архитектура cricket-tag

```
 Провода полётника (площадки J1)                 Провода аккумулятора (площадки J2)
 5V  GND  TX  RX                                  Li-Po 1S с PCM
  │         │   │                                      │ VBAT
  │         │   └─ 1 кОм ─► GPIO UART RX               │
  │         └───── 1 кОм ◄─ GPIO UART TX               │
  ├─► делитель ─► GPIO VIN_SENSE (есть ли 5 В)         │
  └─► Шоттки ─► TP4054 ── заряд 45 мА ──────────────────┤
                  └─ CHRG ─► GPIO                       │
                                                        ├─► TPS7A0233 ─► 3,3 В ─► ISP2454-LX (nRF54L15), LIS2DH12
                                                        ├─► PAM8904E ─► пьезо CPT-1117-83 11×9  
                                                        ├─► белый LED + резистор ─► N-MOSFET ◄─ GPIO
                                                        └─► делитель ─► АЦП (напряжение батареи)

 ISP2454-LX: кварцы внутри, GPIO ─► PAM8904E (DIN, EN1; EN2 на VBAT), LIS2DH12 по I2C + INT ─► GPIO, кнопка ─► GPIO,
           SWD ─► четыре площадки J3 снизу
```

### Форма и размещение

- Плата 17 × 32 мм после разводки (D-29), 2 слоя, все компоненты сверху. Снизу только медные площадки под провода и SWD (D-26). Аккумулятор до 15 мм длиной (401012 или 401015) лежит снизу за площадками и не заходит под модуль.
- ISP2454-LX (D-29) в углу платы на дальнем конце от хвоста, антенной половиной к торцу: в 1 мм от торцевой кромки и в 1,3 мм от боковой (+0,3 мм к datasheet под дорожки VDD и SWD), у торца полоса 14 × 5 мм без меди. OUT_MOD соединён с OUT_ANT. См. [components.md](components.md#требования-к-встроенной-антенне).
- Монтаж универсальный. Конец с антенной должен выступать за карбон рамы и не лежать на полётнике.
- Маячок крепится к раме надёжнее аккумулятора (стяжка или термоусадка, не только липучка): оторвавшийся маячок пищит отдельно от дрона. Программно это не отличить от падения с отлетевшим аккумулятором; помогают только последние координаты с GPS в рекламе — они от дрона.

### Заметки для схемы

Выявлены при проработке, учесть при рисовании схемы:

- **Белый светодиод** KT-0603W питается от VBAT через 2N7002 и резистор. Его прямое напряжение 2,6–3,1 В, от 3,3 В LDO запаса по току почти нет.
- **Присутствие 5 В** определяется отдельным делителем на GPIO. Вывод CHRG у TP4054 не отличает «заряд окончен» от «нет питания».
- **Напряжение батареи** измеряется делителем 1 МОм / 1 МОм с конденсатором 100 нФ: ток ~2 мкА, на АЦП не больше 2,1 В. Эти 2 мкА — почти половина тока в режиме SHIP; при разводке оставить место под отключаемый делитель (ключ со стороны VBAT), если замер покажет, что ток SHIP важен.
- **UART к полётнику**: последовательные резисторы около 1 кОм на TX и RX для защиты. Уровни совпадают: и полётник, и модуль работают от 3,3 В. Без 5 В от полётника вывод TX маячка переводится в высокоимпедансное состояние, чтобы не запитывать полётник через его защитные диоды.
- **PAM8904E** питается напрямую от VBAT (1,5–5,5 В), управляется GPIO, режим 3x, дифференциальное включение. В выключенном состоянии ток меньше 1 мкА. Размах на излучателе зависит от заряда: около 19 В при 3,7 В и до 25 В при 4,2 В (по datasheet в режиме 3x под нагрузкой выход ниже идеальных 3 × VIN).
- **LDO 3,3 В** (решение D-14). При разряде аккумулятора ниже ~3,4 В выход LDO следует за батареей, модуль работает до 1,7 В.
- **Утечка TP4054** из аккумулятора без 5 В — 1–2 мкА по datasheet, входит в ток сна. Ток заряда 45 мА (PROG 22 кОм), не больше 1C для аккумулятора 40–60 мА·ч.
- **Тактирование:** оба кварца, 32 МГц и 32,768 кГц, внутри ISP2454-LX (D-29; внешний кварц D-16 больше не нужен).
- **Порты nRF54L15:** на P2 нет прерываний и пробуждения, АЦП и PWM только на P1, SCL I2C только на «тактовом» выводе. Карта выводов — в README платы.
- **Вход 5 В**: Шоттки и конденсатор 10 мкФ, при необходимости TVS-диод от выбросов BEC.

## Режимы работы

```
          5 В есть                        5 В пропало
 ┌──────────────────┐   ───────────────►  решение по признакам падения
 │ ON_DRONE         │                          │
 │ заряд, радио     │     armed, failsafe или удар ───────────────► ALARM
 │ почти молчит     │     disarmed по MSP и удара не было ────────► STANDBY
 └──────────────────┘     нет данных ни от MSP, ни от удара ──────► ESCALATE
          │
          │ 5 В есть, но полёт кончился аварийно (failsafe, дизарм в воздухе,
          │ нет связи с пультом после полёта) ──────────────────► ESCALATE
```

| Режим | Когда | Что делает |
|---|---|---|
| ON_DRONE | есть 5 В | Заряд. Читает статус и GPS полётника по MSP, если UART настроен. В полёте (armed по MSP, без MSP — вибрация моторов) радио выключено, подключённые телефоны отключаются: не мешает приёмнику ELRS на 2,4 ГГц; armed без связи с пультом — реклама с координатами каждые 2 с. На земле редкая реклама для связи с приложением |
| ESCALATE | 5 В пропало, признаков нет; или полёт кончился аварийно, а 5 В осталось | 30–60 с тихие короткие сигналы, затем ALARM. Успеваешь заменить аккумулятор или погасить ложную тревогу |
| ALARM | падение | Все рекламы часто, громкий бипер и вспышки. Через 30–60 мин переход в BEACON |
| BEACON | долго после падения | Рекламы реже, бипер редко или по команде из приложения |
| STANDBY | замена аккумулятора или хранение | Тихо. Только редкая реклама Find My и Find Hub: дрон можно найти, если его украли или забыли |
| LOW_BAT | батарея ниже ~3,4 В | Бипер выключен, только редкая реклама |
| SHIP | долгое нажатие кнопки, или батарея ниже ~3,2 В | Глубокий сон около 4–5 мкА: на 60 мА·ч больше года. Пробуждение по появлению 5 В или кнопкой |

Выход из ALARM, BEACON и ESCALATE: короткое нажатие кнопки, команда из приложения, возврат 5 В; если 5 В есть — ещё arm дрона или выключение тумблера BEEPER на пульте. Кнопка и команда переводят в STANDBY, а при 5 В — в ON_DRONE: дрон остаётся под питанием, и следующий полёт должен отслеживаться как обычно.

### Признаки падения

1. **Статус armed по MSP.** Маячок опрашивает полётник по UART (MSP_STATUS). Требует, чтобы порт был включён на MSP в Betaflight или INAV.
2. **Удар по акселерометру.** LIS2DH12 в режиме низкого потребления с прерыванием по порогу ускорения. Удар выше порога за несколько секунд до пропажи 5 В означает падение.
3. **Нарастание громкости.** Запасной вариант, если нет ни MSP, ни удара.

Пропажи 5 В может и не быть: после failsafe (посадка, сброс или GPS Rescue), дизарма в воздухе или падения с неотлетевшим аккумулятором дрон лежит под питанием, а полётник его уже disarm-ил. Тогда маячок поднимает тревогу (ESCALATE), не дожидаясь, пока сядет аккумулятор дрона (D-35):

4. **Failsafe по MSP.** Режим FAILSAFE в флагах MSP_STATUS или флаги запрета arm FAILSAFE и CRASH_DETECTED у Betaflight (держатся, пока связь не вернулась). Был в полёте или есть в момент дизарма — тревога. Пропало 5 В после такого полёта — ALARM.
5. **Дизарм в воздухе.** В пределах ~1,5 с до и 5 с после дизарма: свободное падение по акселерометру (|a| < 0,4 g дольше 250 мс), удар выше порога (или за 10 с до дизарма), либо скорость по GPS больше 5 м/с в момент дизарма.
6. **Нет связи с пультом после полёта.** Дрон после полёта disarmed, а у Betaflight флаг RXLOSS дольше 30 с. Если пилот выключает пульт раньше, чем отключает аккумулятор, через 30 с начнётся тихое чириканье — гасится кнопкой.

7. **Полётник перезагрузился в воздухе.** MSP молчит дольше 2 с у armed дрона, а потом отвечает disarmed — тревога.
8. **5 В пропало в полёте и вернулось** (просадка питания, аккумулятор дёрнулся на разъёме). Если 5 В вернулось в течение 10 с, тревога не гаснет и память о полёте не стирается. Если полётник снова отвечает armed (или без MSP снова вибрация), значит, он не перезагружался и летит дальше — маячок возвращается в ON_DRONE.

Каждый полёт даёт не больше одной такой тревоги. Свободное падение у armed дрона (нырки) само по себе тревогой не считается.

**Без MSP** маячок определяет полёт по вибрации моторов: разброс ускорения за секунду выше 0,3 g. Это глушит радио в полёте и считается как armed при пропаже 5 В. Остальные правила (failsafe, BEEPER, связь) без MSP не работают.

### Предполётная проверка

Через 5 с после появления 5 В маячок тихо пищит (D-36):

| Сигнал | Значение |
|---|---|
| один короткий | всё в порядке |
| три длинных | аккумулятор маячка ниже 3,7 В: на долгую тревогу не хватит, а за полёт от полётника он почти не зарядится (45 мА, ~4 мА·ч за 5 мин) |
| два длинных | полётник не отвечает по MSP: не тот UART или MSP не включён |

При обеих проблемах звучат оба сигнала по очереди. Напряжение берётся последнее, измеренное без 5 В (под зарядом оно завышено). Выключается настройкой `0x06` из приложения ([protocol.md](protocol.md#настройки)).

### Тумблер BEEPER на пульте

Режим BEEPER в Betaflight (вкладка Modes) назначается на AUX-тумблер. Пока тумблер включён и дрон disarmed, маячок пищит громко и мигает, как по команде FIND. Связь пульта бьёт дальше Bluetooth, так что писк включается издалека. Выключение тумблера гасит и писк, и тревогу, поднятую при 5 В. Работает, пока полётник под питанием и связь с пультом есть.

### Кнопка

| Действие | Функция |
|---|---|
| Короткое нажатие | выключить тревогу; в остальных режимах тестовый писк и вспышка |
| Удержание 3 с | окно привязки нового телефона на 60 с ([protocol.md](protocol.md#привязка-и-защита)) |
| Удержание 8 с | режим хранения SHIP |
| Удержание 3 с с подачи питания | окно обновления прошивки по BLE на 5 мин (MCUboot + SMP) |

Раскладка предварительная, уточняется при написании прошивки.

## Радио

Наборы рекламы в режимах ALARM и BEACON (Zephyr поддерживает несколько advertising sets):

| Набор | PHY | Назначение |
|---|---|---|
| Apple Find My | legacy 1M | краудсорсинг через iPhone |
| Google Find Hub | legacy 1M | краудсорсинг через Android |
| Cricket Coded | extended, Coded PHY S8, +8 dBm, подключаемый | дальний поиск своим приложением, команда «пищи», телеметрия |
| Cricket 1M | legacy 1M, подключаемый | для телефонов без приёма Coded PHY |

Полезная нагрузка Cricket: идентификатор, калибровочная мощность на 1 м, напряжение батареи, режим, счётчик, последние координаты GPS с полётника (если были).

Прошивка своя (D-32), Everytag — только справочник. Первыми делаются наборы Cricket; Apple и Google добавляются позже. Пакеты Apple в формате OpenHaystack, ключи генерирует приложение при привязке и меняет маячок по таймеру. Google: формат Find Hub Network, сначала постоянный EID, сменный — доработка. Координаты из обеих сетей опрашивает своё приложение (D-33, [app.md](app.md#краудсорсинговые-сети)). Интервалы подбираются по замеру тока.

Мощность ISP2454-LX +8 dBm, чувствительность Coded 125 кбит/с −104 дБм, бюджет линии около 112 дБ без учёта антенн.

Ожидаемая дальность при прямой видимости (решение D-17): 150–250 м на 1M и 300–500 м на Coded PHY. Основание — примеры u-blox для маленьких плат: встроенная антенна излучает тем хуже, чем меньше плата. Nordic в поле получал удвоение дальности на Coded PHY по сравнению с 1M. В лесу и траве заметно меньше. Insight SiP для ISP2454 указывает 60 м в открытом поле на 1M при высоте 1 м (datasheet, разд. 2.6) — заметно ниже этого ориентира. Уточняется замером на первых платах.

## Энергобюджет (оценка, уточнить замером)

Расчёт по токам nRF54L15 из datasheet (D-29): TX +8 dBm 9,1 мА, TX 0 dBm 3,7 мА, System ON с ОЗУ и LFXO 1,5 мкА. Coded-реклама на +8 dBm — самая дорогая часть.

| Режим | Потребитель | Средний ток |
|---|---|---|
| ALARM | Apple, Google, Cricket 1M каждые 2 с | ~15–27 мкА |
| | Cricket Coded каждую 1 с, +8 dBm | ~43–55 мкА |
| | сон модуля 1,5 мкА, утечка TP4054 1–2 мкА, делитель VBAT ~2 мкА, акселерометр, LDO | ~7–11 мкА |
| | **итого радио** | **~65–93 мкА** |
| | бипер 100 мс каждые 5 с, ~15 мА | +~300 мкА |
| BEACON | те же наборы, Cricket Coded каждые 2 с | ~45–65 мкА |
| STANDBY | Apple и Google каждые 5 с, Cricket Coded каждые 5 с | ~20–26 мкА |
| SHIP | System OFF 0,6 мкА, утечка TP4054 1–2 мкА, делитель VBAT ~2 мкА, LDO, акселерометр выключен | ~4–5 мкА |

| Аккумулятор | BEACON без бипера | STANDBY |
|---|---|---|
| 401012, ~40 мА·ч | ~3,5–5 недель | ~9–12 недель |
| 401015, ~50 мА·ч | ~4,5–6,5 недели | ~11–15 недель |

Интервалы и мощность — основные рычаги: Coded каждые 2 с вместо 1 с снижает ток почти вдвое. Громкий бипер работает первые десятки минут, потом редко или по команде.

## cricket-seeker (следующий этап)

- Радио с внешней направленной антенной: Ebyte E73-2G4M08S1CX (nRF52840, IPEX, есть на LCSC), Fanstel BT840X (усилитель +20 dBm и LNA) или тот же ISP2454-LX с внешней антенной через OUT_MOD и U.FL.
- Антенна: патч 2,4 ГГц 25×25 мм 5–6 dBi или PCB-Yagi.
- Связь с полётником по UART: MSP или MAVLink. Получает координаты и курс, отдаёт в OSD уровень сигнала и пеленг.
- Пеленг вращением: дрон зависает и делает оборот по рысканью, максимум сигнала даёт направление. Два-три пеленга дают пересечение.

## Резерв по дальности

Если BLE-дальности не хватит, вторая ревизия может быть двухрадийной: ISP2454-LX плюс LoRa 868 МГц (LLCC68 или SX1262, +0,5–0,8 г). Find My и Find Hub это не заменяет.
