yamaha252/Cricket/docs/requirements.md

# Требования к cricket-tag

Зафиксировано 2026-11-09 по итогам обсуждения с владельцем проекта. Источник мотивации: дрон с пищалкой Flywoo Finder V1.0 был потерян, пищалки не хватило, чтобы его найти.

## Назначение

Маячок на дрон, который после падения помогает найти дрон:

1. своим приложением на телефоне: уровень сигнала, «тепло-холодно», карта, команда «пищи»;
2. через краудсорсинговые сети Apple Find My и Google Find Hub, если рядом проходит чужой телефон;
3. звуком и светом на последних метрах.

## Целевые дроны и монтаж

| Требование | Значение |
|---|---|
| Самый маленький целевой дрон | BetaFPV Pavo Pico II: рама 80 мм, полётник 25,5×25,5 мм, масса без аккумулятора 39–54 г |
| Не целевые | тинивупы 65–75 мм: на них маячок не имеет смысла по массе |
| Монтаж | универсальный: стяжка, двусторонний скотч, термоусадка. Типичное место под полётным контроллером |
| Ограничение монтажа | конец платы с антенной должен выступать за карбон и не лежать на меди полётника, иначе дальность BLE падает в разы |

## Масса и размер

| Требование | Значение |
|---|---|
| Ориентир | Flywoo Finder V1.0: 21×11×9,5 мм, 2,7 г |
| Цель для cricket-tag | около 22×13 мм (после разводки 17 × 32 мм, D-26…D-28), высота с аккумулятором 7–8 мм, 2,7–3,5 г вместе с аккумулятором и кабелем |
| Приоритет | масса и размер важнее остального, затем энергопотребление, затем дальность |

## Изготовление

- Плата заказывается на заводе (JLCPCB) **полностью собранной**. Ручной пайки на плате нет.
- Руками допускается только: припаять провода аккумулятора и полётника к площадкам, залить прошивку, надеть термоусадку. Сначала требовались разъёмы; владелец разрешил пайку ради размера (D-26).
- Каждый компонент на плате должен ставиться заводом: со склада LCSC или через JLCPCB Global Sourcing. Подробности в [manufacturing.md](manufacturing.md).

## Подключение к полётнику

- Четыре провода: 5 В, GND, TX, RX. Паяются к площадкам на нижней стороне платы (D-26). Сначала требовался разъём JST SH 1,0 мм на 4 контакта, как у портов GPS/UART полётников Betaflight и INAV.
- Со стороны полётника провода паяются к его площадкам или заканчиваются JST SH под его порт.
- Питание и зарядка от 5 В полётника (BEC).

## Звук и свет

| Требование | Значение |
|---|---|
| Громкость | сопоставимо с Flywoo Finder V1.0 (заявлено 100 дБ, вероятно на 10 см). В первой версии допустимо немного тише, если есть ограничения |
| Для сравнения | VIFLY Finder Mini 90 дБ на 20 см, VIFLY Finder 2 106 дБ на 20 см, обычный FPV-буззер 89 дБ на 20 см (замеры Oscar Liang) |
| Свет | яркий белый светодиод, как у готовых пищалок |
| Длительность | бипер часами после падения, BLE 2–4 недели в зависимости от аккумулятора и интервалов. Готовые пищалки работают от 30 секунд до нескольких часов |

## Поведение

- Автовключение тревоги при пропаже питания от полётника, как у готовых маячков.
- Замена аккумулятора дрона и хранение дрона без аккумулятора **не должны** вызывать громкую тревогу.
- Кнопка обязательна: выключить тревогу, привязать к приложению, режим хранения, тестовый писк, вход в загрузчик.
- Тревогу можно выключить кнопкой, из приложения или повторной подачей питания.

## Телефоны и приложение

- У владельца Android. Устройство должно работать и с Android, и с iPhone без лишней мороки.
- Поддержка обеих сетей: Apple Find My и Google Find Hub.
- Своё приложение под Android для точного поиска. Описание в [app.md](app.md).

## Не требуется в первой версии

- Сертификация FCC/CE.
- Поисковый дрон cricket-seeker: отдельный этап.
- LoRa: только если BLE-дальности не хватит.
