yamaha252/Cricket/docs/decisions.md

# Журнал решений

Новые решения добавляются сверху. Отменённое решение не удаляется, а помечается ссылкой на то, что его заменило.

## 2026-11-12

### D-41. Ревью схемы и разводки: схема без правок, два переходных GND

Полное ревью после уборки D-40.

**Схема** сверена с datasheet, правок нет:

- PAM8904E (Diodes DS41667 Rev. 4-2): распиновка W-QFN2020-12 совпадает; при EN2 = 1 вывод EN1 выбирает 1x и 3x, выключение — DIN = 0 через 42 мс, ток до 1 мкА (подтверждает D-28); CIN 2,2 мкФ, летающие 1 мкФ между CP1–CN1 и CP2–CN2, COUT 2,2 мкФ (у нас 2 × 1 мкФ); в режиме 3x вход не выше 4,5 В и выход не выше 13,5 В — 4,2 В × 3 = 12,6 В проходит. В datasheet «плюсовым» выходом назван VO2, а у нас он BUZ_N: для пьезоизлучателя полярность не важна.
- ISP2454-LX (isp_ble_DS2454 R7, разд. 3 и 4.3): все используемые площадки совпадают; OUT_ANT с OUT_MOD соединены, как требует datasheet; механические 49–62 стоят на изолированных площадках; требования соединять все VSS нет (12, 14, 16, 18 не подключены). Зона антенны — без металла, дорожек и деталей; боковой отступ у нас 1,3 мм вместо 1,0 мм (D-29), зона 14,3 × 5 мм.
- nRF54L15 (Nordic, Pin assignments): SCL обязан быть на «тактовом» выводе — P1.03 такой; на P2 нет прерываний и пробуждения — там только LED, EN1 и CHRG_N; периферия не может смешивать выводы разных портов — I2C целиком на P1, UART целиком на P0 (UARTE30); AIN3 = P1.07.
- TP4054, TPS7A0233, LIS2DH12, 2N7002, B5819W — распиновка по списку цепей совпадает; делители VIN_SENSE (3,0 В при 5 В) и VBAT_SENSE, ток заряда 45 мА, подтяжки I2C — в норме.

Что схема сознательно не закрывает (не ошибки, цена — масса и место): нет защиты от переполюсовки батареи при пайке, нет TVS на проводах полётника (только 1 кОм в UART), нет вывода сброса на SWD.

**Разводка**, исправлено:

- **Минус батареи держался на одном отверстии.** J2.2 снизу зажат дорожками VBAT, BUZ_DIN и площадкой J2.1, и весь ток батареи шёл через единственное переходное 0,3 мм в центральной площадке PAM8904E и дальше дорожками 0,25 мм (так было и до D-40). Добавлено второе переходное внутри J2.2 на верхнюю заливку под U4.3–U4.4 (`gen_pcb.driver_ground`).
- **Островки верхней земли на одном переходном.** Островок с GND акселерометра, C15 и входного конденсатора драйвера C10 получил второе переходное (`tidy.py vias`). Остальным семи одиночным островкам (R2.2; C3.2 с R5.2; C2.2; угловые GND модуля 1, 25, 31 и 21–23) второе не поставить: под ними нет нижней заливки или нет места. Ток там — микроамперы делителей и земля модуля, у которого свои угловые площадки.

Замечания без правок: C4 и C5 стоят в 3–4,5 мм от U3 (TPS7A02 это допускает, но ближе лучше — при следующей перестановке); VDD модуля идёт от LDO дорожкой 24 мм, развязка внутри модуля; дорожки VCHG 0,112–0,15 мм при токе 45 мА.

Gerber изменились ещё раз (два отверстия), BOM и CPL прежние.

### D-40. Уборка разводки: зазор 0,3 мм у площадок под пайку, лишние дорожки GND сняты

Специалист, посмотрев медь, отметил «джунгли в мелочах» и непонятные площадки снизу. Разбор по данным платы показал три вещи; электрических ошибок среди них не было (DRC и до правок давал 0), но плата поправлена.

- **Площадки под ручную пайку (J1 — полётник, J2 — батарея).** Между площадками батареи J2.1 (VBAT) и J2.2 (GND) лежала полоска заливки GND с переходным центральной площадки PAM8904E, в 0,2–0,25 мм от VBAT; чужие дорожки и переходные (BUZ_CP1, BUZ_DIN, VBAT, SWDCLK, FC_TX) подходили к площадкам на 0,13–0,25 мм. Под маской это законно, но перемычка припоя или прожжённая маска при пайке провода батареи замыкает батарею. Теперь: заливки между площадками и ближе 0,3 мм нет (зоны без заливки `wire-pads-J1/J2`, `gen_pcb.wire_pad_keepouts`), чужая медь не ближе 0,3 мм — правило `wire_pad_clearance` в `cricket-tag.kicad_dru`, его проверяет DRC. 0,3 мм, а не больше, потому что между площадками 0,8 мм и дорожка 0,15 мм по середине проходит с 0,325 мм (так идут SWDCLK и BUTTON между площадками J1). Переходное центральной площадки U4 сдвинуто к её краю, к J2.2; обвязка драйвера (`DRIVER_TRACKS`) перерисована под новый зазор; переходные FC_RX и GND стоят внутри своих площадок. Площадки SWD (J3) правило не покрывает: к ним +3V3 и сшивающие переходные подходят на 0,15–0,17 мм, паять туда провода надо аккуратно.
- **Дорожки GND поверх заливки.** С D-29 земля разводится Freerouting как обычная цепь, а заливка ложится сверху. 119 из 126 незакреплённых дорожек GND оказались внутри сплошной земли: зигзаги поперёк площадок, обрезанные термобарьеры, щели. Их снимает `tidy.py gnd`: дорожка лишняя, если после её снятия и перезаливки плата остаётся связной.
- **Пыль и лесенки.** Freerouting подводит дорожку к площадке гребёнкой из отрезков по 0,003 мм, `maze.py` до D-29 оставлял ступеньки сетки 0,05 мм, BUZ_P шла под произвольными углами. `tidy.py dust` и `tidy.py merge` это убирают, `tidy.py widen` расширяет дорожки 0,112 мм до 0,15 мм там, где есть зазор. Отрезков дорожек стало 329 вместо 657, короче 0,1 мм — 18 вместо 198.

Что осталось и почему: дорожки 0,112 мм LED_K и VCHG и 0,12 мм BUZ_CP2 (расширить некуда, минимум завода 0,1 мм); закреплённые отрезки вывода из-под модуля под произвольным углом (нарисованы так намеренно, D-29); островки заливки сверху 0,10 и 0,14 мм² между выводами U4.

Расстановка, схема, BOM и CPL не менялись, изменилась только медь. Расчёты заводов (D-30, D-31, SCSPCBA) сделаны по прежним gerber: перед оплатой заказа нужно загрузить новый `cricket-tag-gerbers.zip`. `route.sh` с нуля после этих правок не запускался.

### D-39. iOS: свой BLE-слой на Swift с теми же каналами, только 1M

Под iOS BLE-слой написан на Swift поверх CoreBluetooth (`app/ios/Runner/CricketBle.swift`). Он отдаёт Dart те же каналы, методы и события, что и Kotlin-слой (D-38), поэтому экраны, протокол, пеленг и карта общие без веток по платформе. Отличия iOS, которые приходится принимать:

- **Только 1M:** iPhone не принимает Coded PHY (app.md), каждый пакет помечается как 1M, баннер сканера пишет «iPhone принимает только 1M».
- **Нет MAC-адреса:** вместо адреса используется идентификатор `CBPeripheral` (UUID), он постоянен только на этом телефоне. Подключение возможно только к маячку, которого сканер уже видел.
- **Нет явной привязки:** iOS начинает привязку сама, когда защищённая характеристика отвечает «недостаточное шифрование». Поэтому «привязать» на iOS — это чтение характеристики настроек (`READ_ENCRYPT` в прошивке) на открытом соединении. Узнать, привязан ли маячок, приложение не может, и чтение делается каждый раз: при существующей привязке оно просто проходит.
- **Bluetooth не включить из приложения:** кнопка открывает настройки приложения.
- Писк «тепло-холодно» — синус 2 кГц через `AVAudioEngine`, смешивается с другим звуком и слышен в беззвучном режиме.
- **Ошибки CoreBluetooth вне ATT** (маячок стёр привязку, а iOS ключи помнит; шифрование не установилось) передаются в Dart как статус `0x200` + код `CBError` и показываются текстом. Стереть привязку из приложения iOS не даёт: пользователю пишется «Забыть это устройство» в настройках Bluetooth.
- Минимальная iOS — 15.0 (`CBManager.authorization` требует 13.1).

Проверено только в симуляторе, где Bluetooth нет: сборка, запуск, состояние «Bluetooth недоступен», загрузка и кэш тайлов. Сканирование, GATT и привязка на iPhone с настоящим маячком не проверены.

### D-38. Приложение на Flutter, свой BLE-слой на Kotlin, офлайн-карты OpenTopoMap

Приложение пишется на Flutter (Dart): Android первым, iOS потом из того же кода — экраны, протокол, пеленгация и карта общие. Нативный код только там, где без него нельзя.

- **BLE — свой слой на Kotlin** (`app/android/.../CricketBle.kt`) через platform channel, без сторонних BLE-плагинов. `flutter_blue_plus` с версии 2 под своей лицензией, коммерческое использование платное. Свой слой заодно гарантирует сканирование `PHY_LE_ALL_SUPPORTED` с выключенным legacy (обход ошибки Pixel, D-17/app.md) и отдаёт PHY каждого пакета: приложение показывает, принимается ли Coded на деле. Разрешения запрашивает он же (`permission_handler` требовал Android SDK 37, который AGP 9.0 не находит).
- **Карты** — `flutter_map` (BSD) с подложкой **OpenTopoMap**: горизонтали, отмывка рельефа, лес, тропы — для поиска в поле информативнее обычной OSM. Тайлы берутся из памяти, сеть только догружает и сохраняет. Область скачивается заранее (до 30 000 тайлов за раз, 2 потока). У OpenStreetMap массовая загрузка запрещена правилами tile.openstreetmap.org, поэтому OSM офлайн — только просмотренные места. Любую растровую карту (спутник, топо) можно добавить файлом MBTiles. Векторные карты не взяты: стиль с рельефом пришлось бы собирать самим.
- **Без сети работает всё:** сканер, «тепло-холодно», пеленг (GPS телефона без Play-сервисов, `forceLocationManager`), команды, настройки, карта из памяти.
- Пеленг: перебор по сетке, взвешенный МНК модели затухания, RSSI на 1 м подбирается в каждой клетке с априорной оценкой из рекламы (±10 дБ).

Не сделано в первой версии: фоновое сканирование (foreground service), обновление прошивки (`mcumgr_flutter`), сети Apple и Google, iOS-часть BLE-слоя (сделана позже, D-39).

## 2026-11-11

### D-37. В полёте маячок разрывает соединения с телефонами

Выключение рекламы в полёте (D-32) не трогало уже установленные соединения: телефон, подключённый на столе, держал бы связь рядом с приёмником ELRS весь полёт. Теперь при переходе в полёт (armed по MSP или вибрация без MSP) маячок отключает все соединения. Исключение то же, что для рекламы: armed без связи с пультом (D-36) — радио включено. Найдено при обсуждении шлюза Bluetooth → MSP для Betaflight Configurator (Nordic UART Service есть в списке адаптеров Configurator); шлюз — в плане, после проверки на DK ([firmware/README.md](../firmware/README.md#шлюз-bluetooth--msp-для-betaflight-configurator-план)).

### D-36. Перезагрузка полётника, улёт, предполётная проверка, полёт без MSP, возраст координат, контакт владельца

Дополняет D-35 ситуациями, в которых маячок терял дрон молча или не мог предупредить заранее. Подробности в [concept.md](concept.md#признаки-падения) и [protocol.md](protocol.md).
- **Перезагрузка полётника в воздухе:** MSP молчит дольше 2 с у armed дрона и возвращается disarmed — тревога. 5 В, вернувшееся в течение 10 с после пропажи в полёте, не гасит тревогу и не стирает память о полёте; armed по MSP (или вибрация без MSP) возвращает в ON_DRONE.
- **Улёт:** armed без связи с пультом (failsafe или RXLOSS) — радио включается, координаты в рекламе обновляются каждые 2 с. Приёмнику ELRS в этот момент нечего ловить.
- **Предполётная проверка:** через 5 с после появления 5 В тихий писк: всё в порядке, низкий заряд маячка (< 3,7 В) или нет ответа MSP. Отключается из приложения.
- **Полёт без MSP:** вибрация моторов по акселерометру заменяет armed — для выключения радио в полёте и решения при пропаже 5 В. Порог 0,3 g не проверен.
- **Возраст координат:** 2 байта в рекламе (протокол версии 2, данных 24 байта, legacy-реклама занята на 29 из 31 байта).
- **Контакт владельца** (до 64 байт): характеристика открыта всем, пока маячок потерян (ESCALATE, ALARM, BEACON), иначе только привязанному телефону. Задаётся из приложения, хранится отдельно от настроек и не сбрасывается командой DEFAULTS (решение владельца 2026-11-11: контакт полезен).

Не делается: маячок, оторвавшийся от дрона, программно не отличить — требование к креплению в concept.md; вода и черепаха не рассматриваются.

### D-35. Тревога при аварийном конце полёта без пропажи 5 В; писк с тумблера BEEPER

После failsafe (посадка, сброс, GPS Rescue), дизарма в воздухе или падения, при котором аккумулятор не отлетел, дрон лежит под питанием и disarmed. Раньше маячок молчал, а когда аккумулятор дрона садился, принимал это за штатное отключение и уходил в STANDBY. Теперь при 5 В маячок поднимает тревогу (ESCALATE → ALARM), если:
- в полёте или в момент дизарма был failsafe (режим FAILSAFE в MSP_STATUS, флаги запрета arm FAILSAFE и CRASH_DETECTED у Betaflight);
- дрон disarm-ен в воздухе: свободное падение или удар рядом с дизармом, скорость по GPS больше 5 м/с;
- после полёта дрон disarmed без связи с пультом дольше 30 с.

Пропажа 5 В после полёта с failsafe — сразу ALARM. Режим BEEPER, назначенный в Betaflight на тумблер, включает громкий писк маячка (пока тумблер включён и дрон disarmed), выключение тумблера гасит тревогу. Всё по MSP, без новых проводов: вывод бипера полётника не подключается (rev A без пятой площадки, и маячок пищал бы на каждый arm). MSP и акселерометр теперь работают, пока есть 5 В, а не только в ON_DRONE.

Цена: ложная тревога, если пилот проверяет failsafe на столе или выключает пульт раньше, чем отключает аккумулятор; гасится кнопкой, тумблером BEEPER или arm. Пороги (0,4 g, 250 мс, 5 м/с, 30 с) не проверены на дроне. Подробности в [concept.md](concept.md#признаки-падения).

### D-34. Базовые настройки Bluetooth меняются из приложения

Привязанный телефон читает и меняет через характеристику «Настройки» сервиса Cricket: имя устройства, мощность каждого набора (Coded и 1M, −40…+8 дБм), интервалы каждого набора по режимам (ON_DRONE без armed, ESCALATE, ALARM, BEACON, STANDBY, LOW_BAT) и RSSI на 1 м в рекламе. Формат — список «ключ, длина, значение», чтобы позже добавить настройки наборов Apple и Google без смены версии. Настройки хранятся в разделе настроек и применяются сразу; команда DEFAULTS возвращает значения по умолчанию. Подробности в [protocol.md](protocol.md#настройки).

Ограничения: в ON_DRONE с armed и в SHIP радио выключено всегда (D-32, ELRS); в каждом режиме должен оставаться включённым хотя бы один набор, иначе маячок не найти и настройку не вернуть. Интервалы и мощность по умолчанию прежние, до замера тока.

### D-33. Сети Apple и Google опрашивает своё приложение, без своего сервера; делается после своего механизма поиска

Координаты из Find My и Find Hub показывает приложение Cricket на своей карте, под аккаунтами самого пользователя. Компьютер у пользователя не нужен, свой сервер и служебные аккаунты не используются. Подробности в [app.md](app.md#краудсорсинговые-сети).

- **Google Find Hub.** Приложение входит в Google-аккаунт пользователя (как GoogleFindMyTools), регистрирует в нём маячок, при привязке записывает ключ в маячок, затем само опрашивает отчёты и расшифровывает их. Приложение Find Hub не нужно: смотреть в своём приложении удобнее.
- **Apple Find My.** Приложение генерирует пары ключей при привязке, публичные записывает в маячок, приватные хранит в телефоне (нужна резервная копия, иначе со сменой телефона сеть Apple для маячка пропадёт). Вход в Apple ID пользователя (SRP, 2FA по SMS), запрос отчётов по хэшам ключей, расшифровка в телефоне. Образец протокола — FindMy.py (MIT).
- **Anisette** (заголовки, без которых Apple не отдаёт отчёты) на Android генерируется в телефоне библиотеками Apple из Apple Music для Android: скачиваются при первом запуске или берутся из APK установленной Apple Music (APK других приложений читаются через `PackageManager`, пакет объявляется в `<queries>`). Встраивать библиотеки в приложение нельзя: это распространение кода Apple. Работа библиотек в нашем процессе не проверена, нужен прототип. Запасные пути: публичные anisette-серверы SideStore (SideStore предупреждает о блокировках Apple ID на перегруженных серверах) или anisette-сервер дома у пользователя.
- **Ограничения Apple:** Apple ID должен хотя бы раз быть привязан к Apple-устройству (по документации FindMy.py), ключи входа (passkey) выключены. Это нарушает условия Apple, как и любой проект на основе OpenHaystack; обновление Apple может сломать вход. Блокировка затрагивает только аккаунт этого пользователя.
- **iOS:** генерировать anisette в iOS-приложении нельзя (чужой код не загрузить, приватный AuthKit App Store отклоняет; SideStore по этой причине ходит на удалённые серверы). Google на iOS работает так же, как на Android; для Apple нужен удалённый anisette — решается вместе с iOS-приложением.

Почему не сервер Cricket со служебным Apple ID: владелец не хочет держать сервер, а блокировка служебного аккаунта отключила бы сеть Apple у всех пользователей сразу.

Порядок: сначала свой механизм поиска (D-32), интеграции с сетями позже. Владелец проверит FindMy.py со своим Apple ID.

Уточняет: D-10 (вместо веб-интерфейса macless-haystack с сервером и Python-скрипта GoogleFindMyTools).

### D-32. Своя прошивка под MIT, без кода Everytag, на SDK v3.4.2; сначала свой механизм поиска

Прошивка пишется с нуля. Everytag остаётся справочником: форматы пакетов берутся из открытых описаний (OpenHaystack для Apple, спецификация Find Hub Network для Google), код не копируется.

Почему не Everytag:
- Лицензия GPLv3, а репозиторий под MIT: перенос кода сделал бы `firmware/` GPLv3.
- Архитектура не подходит: один `main.c` на ~1000 строк с последовательным циклом, в каждый момент одна реклама, Apple и Google чередуются по времени, адрес Apple задаётся сменой публичного адреса всего контроллера. Нужны четыре набора рекламы одновременно (у каждого свой identity-адрес, адрес Apple — из ключа), режимы, MSP по UART, LIS2DH12, PAM8904E.
- Ценные части маленькие: формат Apple — шаблон 31 байт и адрес из первых 6 байт ключа, ключи считаются заранее вне маячка.

Не рассматриваются: официальный Apple Find My (нужна программа MFi) и официальный Find Hub Network через Google Fast Pair (пример `locator_tag` в SDK). Несертифицированная модель Fast Pair проходит привязку к Find Hub только для Google-аккаунтов из белого списка Google, куда попадают через партнёрскую заявку; изделие для чужих телефонов требует сертификации в лаборатории, назначенной Google. Для проекта это недостижимо.

Порядок работ:
1. Свой механизм поиска на nRF54L15 DK: наборы Cricket Coded (Coded PHY S8, +8 dBm, подключаемый) и Cricket 1M, режимы, драйверы, команда «пищи».
2. Позже — наборы Apple и Google (D-33). Google: формат FHN с ключом, полученным приложением, сначала постоянный EID. Сменный EID по открытой спецификации FHN (AES и secp160r1, библиотека micro-ecc под BSD) — доработка на потом; ему нужны непрерывные часы, тогда режим SHIP — System ON с GRTC (~1,5 мкА) вместо System OFF.

Версия SDK: v2.8.0 выбиралась только из-за Everytag (D-18), эта причина отпала. **Прошивка ведётся на nRF Connect SDK v3.4.2** — последний выпуск на 2026-11-11, уже установлен, сборка примеров под `nrf54l15dk/nrf54l15/cpuapp` проверена 2026-11-09.

Уточняет: D-10 (кто формирует пакеты Apple и Google). Заменяет: D-18 в части версии SDK (v3.4.2 вместо v2.8.0).

## 2026-11-10

### D-31. Панель с фрезеровкой и mouse bites, не V-cut; панели разделяет завод. Завод для первого заказа не выбран

Проверка DRC с правилом 0,4 мм (2026-11-10) показала медь в 0,20–0,39 мм от края в 52 местах: заливка GND, переходные GND, SW1, D2, +3V3, BUZ_N, LED_A. V-cut этой плате не подходит. **Панель — фрезеровка контура с перемычками и отверстиями (mouse bites), перемычки не у SW1, D2 и торца с модулем; панели разделяет завод** — владелец не хочет резать текстолит сам. Чтобы в серии можно было V-cut, медь надо отодвинуть от края до 0,4 мм (ревизия B).

**Завод для первого заказа пока не выбран, варианты рассматриваются** ([manufacturing.md](manufacturing.md#варианты-заводов)). Что известно на 2026-11-10 (проверка с IP из Казахстана):
- **JLCPCB** — расчёт D-30, ~250–285 $ за 8 плат; сборка для Казахстана скрыта по IP, «Panel by JLCPCB» только с V-cut, модуль и излучатель — отдельно через Global Sourcing.
- **NextPCB** — расчёт в [cost.md](cost.md#тестовая-партия-расчёт-nextpcb-2026-11-10): 322,45 $ с акцией −200 $ (522,45 $ без неё), без доставки; закупает все 20 позиций сам, панель 44 × 74 мм с полями 5 мм, фрезеровка и разделение заводом указаны в примечаниях. Расчёт лежит в корзине на проверке у инженеров, не оплачен. В условиях (май 2026) Казахстан не запрещён.
- **PCBWay, PCBGoGo** — сайт для Казахстана закрыт; условия PCBWay называют Казахстан запрещённым направлением и запрещают переправку туда.
- **Seeed Fusion** — Казахстана нет в списке запрещённых стран; расчёт в [cost.md](cost.md#сколько-плат-собирать-минимум-и-оптимум-2026-11-10): 8 плат ~450 $ с модулем (модуль на ручной проверке), доставка бесплатная.
- Открываются и не запрещают Казахстан: WellPCB, Makerfabs, Smart Prototyping — не считались.

По количеству для нулевой ревизии рекомендация — 3–4 платы (там же); решение не принято.

Файлы: `make_fab.sh` дополнительно пишет `bom-mpn.csv` (номера производителя по номеру LCSC) и `cpl-kicad.csv`/`.zip` (повороты KiCad без поправок JLCPCB) для заводов кроме JLCPCB.

Уточняет: D-30 (панель JLCPCB с V-cut не подходит), D-21 (способ разделения панели).

### D-30. Расчёт JLCPCB; доставка в Китай через форвардера — **панель уточнена D-31, завод не выбран**

Выходные файлы загружены в калькулятор JLCPCB, получен живой расчёт ([cost.md](cost.md#тестовая-партия-расчёт-jlcpcb-2026-11-10)). Выяснилось:

- Сборку JLCPCB не отправляет в Казахстан и ряд соседних стран, а блок сборки прячет по IP посетителя ([manufacturing.md](manufacturing.md#ограничение-по-стране)). **Владелец решил отправлять заказ на склад форвардера в Гуандуне.** Доставка по Гуандуну 1–3 $. Адрес в репозитории не хранится.
- Панель 2 × 2 (D-21) с полями 5 мм — 44 × 74 мм, меньше минимума 70 × 70 мм для сборки. Для расчёта поля расширены до 18 мм: 70 × 100 мм, «Panel by JLCPCB», V-cut, реперные знаки от JLCPCB (V-cut этой плате не подходит, D-31). Цена плат та же, 24,80 $ за 5 панелей.
- Модуля на складе JLCPCB нет, предзаказ C44975104 стоит 20,62 $ — вдвое дороже, чем у дистрибьюторов через Global Sourcing (ISP2454-LX-JT у Mouser 9,82 $, -RS отрезком у DigiKey 11,36–13,49 $). При заказе на JLCPCB модуль и излучатель покупаются заранее через Global Sourcing и выбираются в BOM со своего склада. Лоток (-JT) или лента (-RS) — решить после ответа поддержки JLCPCB, ставят ли они модули из лотка.
- Только Standard PCBA; к нему добавляются оснастка 16,54 $ и рентген 13,20 $, которых не было в оценке. Тестовая партия 8 плат — ~250 $ с -JT, ~285 $ с -RS, до купонов и пошлины.
- `make_fab.sh` исправлен по предпросмотру JLCPCB: поправки поворота по номеру LCSC (U2, U3, Q1, U5), Comment в BOM только ASCII.

Уточняет: D-21 (размер и цена тестовой партии), D-29 (закупка модуля).

### D-29. Модуль Insight SiP ISP2454-LX (nRF54L15) вместо ANNA-B402

Владелец спросил про чип нового поколения. Перепроверка 2026-11-10 ([module-options.md](module-options.md#перепроверка-2026-11-10-маленькие-модули-на-nrf54l)): из маленьких модулей на nRF54L в наличии два — ISP2454-LX (8 × 8 × 1 мм, Mouser ~2 200 шт.) и KAGA FEI ES4L15BA1 (3,25 × 8,55 мм, мало наружных выводов, нужен дроссель и кварц). Ezurio BL54L15µ на складах нет. Владелец выбрал ISP2454-LX.

Почему:
- Ток: TX +8 dBm 9,1 мА против 15,5 мА, TX 0 dBm 3,7 против 6,0 мА, сон с ОЗУ 1,5 против 2,6 мкА. Маячок в режиме BEACON работает примерно в полтора раза дольше (энергобюджет в [concept.md](concept.md#энергобюджет-оценка-уточнить-замером)).
- Память: 1,5 МБ / 256 КБ против 512 / 128 КБ; у прошивки большой запас.
- Кварцы 32 МГц и 32,768 кГц, DC/DC и развязка внутри: минус Y1, C6–C9 (внешний кварц D-16 больше не нужен).
- Размер платы не меняется: плотная расстановка 16 × 29,4 мм против 16 × 29,2 у ANNA-B402 (`floorplan.py`, варианты `isp_*`); масса в пределах точности оценки.
- Дальность та же: +8 dBm, Coded −104 дБм, антенна 0,6 dBi.

Как устроено:
- Модуль в левом углу у торца, антенной половиной к торцу; в 1 мм от торцевой кромки и в 1,3 мм от боковой: datasheet требует 1 мм, ещё 0,3 мм — под три дорожки VDD, SWDIO, SWDCLK вдоль кромки. Полоса 14 × 5 мм у торца без меди на обоих слоях (datasheet, разд. 4.3).
- Между площадками модуля 0,25 мм: сигналы только с наружного ряда. Порты nRF54L15 ограничивают выбор: P2 без прерываний и пробуждения, АЦП и PWM на P1, SCL только на «тактовом» выводе. Сигналов для P0/P1 девять, наружных выводов P0/P1 восемь — UART_RX (P0.00) берётся с внутренней площадки через закрытое маской переходное под модулем, как SWD в D-28. Центральные GND 12–18 не подключены (производитель для неполного набора выводов рекомендует наружные). Карта выводов — в README платы.
- GRTC PWM (P0.03) для пищалки не годится, у него фиксированные 128 Гц: BUZ_DIN на P1.04 (PWM20).
- Выход TPS7A0233: 11,2 мкФ в модуле плюс C5 1 мкФ — в пределах 1–22 мкФ по datasheet LDO.
- Закупка как раньше: на складе JLCPCB 0, предзаказ C44975104, JLCPCB берёт через Global Sourcing у Mouser. Раз модуль всё равно идёт через Global Sourcing, излучатель CPT-1117-83 (D-27) остаётся.
- Прошивка: под nRF54L15. Everytag поддерживает nRF54L15; на SDK 3.4.2 его сборка под nRF54L проверена 2026-11-09 ([firmware/README.md](../firmware/README.md)), на v2.8.0 под `nrf54l15dk/nrf54l15/cpuapp` проверена 2026-11-10: приложение 201 КБ из 674 КБ слота, ОЗУ 54 КБ из 188 КБ. Отладочная плата — nRF54L15 DK вместо nRF52833 DK.

Заменяет: D-15 (модуль), D-16 (внешний кварц). Уточняет: D-24 и D-28 (вывод из-под модуля), D-28 (размер платы).

### D-28. Разводка: EN2 драйвера на VBAT, вывод из-под модуля, плата 17 × 32 мм

При разводке выяснилось, что D-24 ошибался. Из верхнего внутреннего ряда модуля (площадки 40–42) наружу на двух слоях проходит одна дорожка, а не три: широкий зазор в правом столбце один — между площадками 33 и 34. Над рядом зона антенны. Центральные GND 53–56 окружены площадками с зазорами 0,3 мм и дорожкой не подключаются вовсе. Поэтому:

- **EN2 PAM8904E постоянно на VBAT.** Режимы выбирает один EN1: 0 — 1x, 1 — 3x; режима 2x нет. Выключение по-прежнему DIN = 0. Вывод 40 (P0.15) модуля свободен. Ток входа EN2 при DIN = 0 по datasheet не больше 1 мкА, типично меньше; это входит в ток SHIP с запасом, проверяется замером.
- **SWDIO и SWDCLK** уходят на переходные под модулем справа сверху, вне зоны антенны, и дальше нижним слоем к J3. Переходные закрыты маской.
- **GND модуля:** 43–46 соединены дорожкой между собой и с GND 4; центральные 53–56 сходятся на переходное 0,5/0,3 мм в середине между ними (зазор до площадок ~0,14 мм, до отверстия ~0,24 мм). Полоска верхней земли слева от модуля сшита одним переходным между GND 7 и 8.
- **Центральная площадка PAM8904E** — переходное прямо в площадке на нижнюю землю, вывод 5 к ней дорожкой. Сверху заливка к площадке не подходит.

Правила под JLCPCB, 2 слоя (таблица возможностей, 2026-11-10): отверстие 0,3 мм с площадкой от 0,45 мм — без доплаты; зазор отверстие — медь 0,2 мм; дорожка и зазор от 0,1 мм. Классы цепей: сигналы 0,15 мм с зазором 0,13 мм, питание (GND, VBAT, +5V, VCHG, +3V3) 0,25 мм; +3V3 к VCC модуля местами 0,15 мм — ток там небольшой.

Размер. На 16 × 29,2 мм (D-27) автотрассировщик оставлял 13 неразведённых соединений, на 17 × 30,2 — 9. Расстановка переделана по выводам: кварц с C8/C9 под XL1/XL2, резисторы UART и делители VBAT/VIN под нижним рядом модуля, конденсаторы драйвера вокруг его выводов, светодиод рядом с ключом. Зона под модулем поднята на 1 мм. Итог — **17 × 32 мм** (вариант `w17d`), плата тяжелее примерно на 0,15 г. Аккумулятор, как и раньше, до 15 мм длиной.

Разводка — Freerouting 2.5 (нужна Java 25+; поставлена OpenJDK 27 из Homebrew, системная Java 21 не тронута). Нижняя заливка GND отдаётся ему как слой земли, и каждая площадка GND получает переходное. Что Freerouting не развёл, доводят скрипты по отчёту DRC (`maze.py`, `fanout.py`), затем ~130 переходных сшивают заливки. Проход — `hardware/cricket-tag/route.sh`; Freerouting недетерминирован, и последние 1–3 замечания в плате из репозитория доведены вручную теми же скриптами. Итог: DRC со всеми уровнями и сверкой со схемой — 0 нарушений, 0 неподключённых.

Уточняет: D-24, D-27 (размер).

### D-27. Излучатель снова CPT-1117-83-SMT-TR; плата 16 × 29,2 мм — **размер уточнён D-28**

Без разъёмов (D-26) площади хватает, и владелец разрешил менять пропорции платы, если это лучше для устройства. Повторная сверка datasheet показала, что разница между излучателями больше, чем считалось в D-25: у CPT-1117-83 83 дБ при 5 В размаха — минимум, а не типичное значение. По частотным кривым, приведённым к 5 В размаха, на 4 кГц CPT-1117-83 громче CPT-9019A примерно на 9 дБ, а если каждый гонять на своей лучшей частоте (CPT-9019A — узкий пик на ~6 кГц), примерно на 2–4 дБ. CPT-1117-83 громкий широкой полосой 3–8 кГц, поэтому разброс экземпляров ему не страшен. Масса та же, 0,2 г.

Цена: плата шире на 2 мм. По расстановке (вариант `w16b`) — 16 × 29,2 мм: излучатель с лепестками вдоль платы под модулем, питание и драйвер в колонке справа. Площадь +57 мм², около +0,06 г. Аккумулятор, как и в D-26, до 15 мм длиной.

Закупка: на складе LCSC 1 шт. (C22359733), JLCPCB берёт его через Global Sourcing (Arrow 2026-11-09: 1 383 шт., ~1,20 $). Модуль идёт тем же путём, поэтому срок заказа не растёт. Сбор ~20 $ за проверку к излучателям, по справке JLCPCB, не относится; станет ясно при заказе. Футпринт CPT-9019A остаётся в библиотеке как запасной.

Заменяет: D-25.

### D-26. Провода паяются к площадкам снизу вместо разъёмов JST SH; SWD — четыре площадки

Владелец разрешил отказаться от разъёмов ради размера. Провода полётника (5 В, GND, TX, RX) и аккумулятора паяются руками к площадкам 1,2 × 2,0 мм с шагом 2 мм на нижней стороне платы, сразу перед аккумулятором (J1, J2). SWD вместо Tag-Connect TC2030-NL — четыре круглые площадки 1,2 мм с шагом 2,54 мм снизу под аккумулятором (J3: VDD, SWDIO, SWCLK, GND). Прошивка — до пайки аккумулятора, подпружиненными контактами или временными проводами.

Причины. Разъёмы JST SH занимали 89 мм² сверху и ~6,6 мм длины: по расстановке плата 14 × 35,9 мм, без них 14 × 29,3 мм (`hardware/cricket-tag/floorplan`, вариант `w14s`). Нижняя сторона свободна, а площадки — только медь: завод их не собирает, полная заводская сборка (D-5) не нарушается. BOM короче на две позиции Extended (~3 $ на заказ и ~0,35 $ на плату), маячок легче ~на 0,15 г. TC2030-NL требовал пустого места сверху над отверстиями под штыри.

Минусы: замена аккумулятора и перекидка проводов под другой полётник требуют паяльника; провода у площадок закрепляются термоусадкой или каплей клея. Аккумулятор подходит любой с выводами и платой защиты, разъём на нём не нужен. Длина аккумулятора вместе с платой защиты — не больше 15 мм (401012 ~40 мА·ч, 401015 ~50 мА·ч): длиннее он заходит под площадки и модуль. Акселерометр остаётся (D-11): по длине он ничего не освобождает.

Ширина 18 мм (18 × 22,8 мм, излучатель рядом с модулем) рассмотрена и не выбрана: та же площадь и масса, металл излучателя в ~5 мм от антенны, аккумулятор не длиннее 12 мм, широкий конец платы хуже выносится за карбон (D-9).

Заменяет: D-6.

## 2026-11-09, третья сессия

### D-25. Излучатель Same Sky CPT-9019A-SMT-TR вместо CPT-1117-83 — **заменено D-27**

При рисовании футпринта выяснилось: у CPT-1117-83 с торцов выступают лепестки выводов по 2 мм. Вместе с ними излучатель 15 × 9 мм, рекомендованные площадки — 15,5 × 9 мм, а не 11 × 9. У запасного CPT-12123-81 площадки тоже выходят за корпус: посадочное место 15 × 12 мм, к тому же 0,5 г и 3 мм высоты. Рядом с углом модуля (7,2 × 10,5 мм) ни тот, ни другой на плату 13 мм шириной не встают.

CPT-9019A: корпус 9 × 9 × 1,9 мм, площадки 1,3 × 3,4 мм, посадочное место 10 × 9 мм, 0,2 г. Громкость 75 дБ тип. (72 мин.) на 10 см при 3 В размаха, около 79 дБ при 5 В — примерно на 4 дБ тише CPT-1117-83. Предел 25 В размаха, как у PAM8904E на полном аккумуляторе. Склад LCSC C20181991: 243 шт., 2,02 $ за штуку, 1,34 $ от 100 шт. на 2026-11-09 — Global Sourcing для излучателя больше не нужен, через него идёт только модуль.

Владелец выбрал CPT-9019A: меньше площадь важнее 4 дБ. Громкость проверяется замером на первых платах. Футпринты CPT-1117-83 и драйвер PAM8904E остаются в библиотеке. Размер платы определяется расстановкой компонентов: с CPT-9019A ожидается около 13 × 24 мм.

Заменяет: D-20.

### D-24. Сигналы только с наружного ряда площадок ANNA-B402; ~RESET на SWD не выводится — **уточнено D-28**

На двухслойной плате 0,6 мм внутренние ряды площадок модуля (шаг 0,65 мм, площадка 0,35 мм) без via не вывести. Между наружными площадками 0,3 мм, а дорожке 0,127 мм с двумя зазорами нужно 0,38 мм. Via внутри посадочного места не помещаются рядом с центральными площадками GND.

Поэтому все 13 сигналов взяты с наружного ряда и с верхнего ряда 40–42: SWD и P0.15 выходят вверх между площадками 33 и 34. Медленные сигналы (кнопка, светодиод, CHRG, прерывание акселерометра, АЦП) стоят на выводах «low-frequency only». UART, ШИМ пищалки, I2C и выбор режима PAM8904E — на обычных выводах. Карта выводов — в README платы.

~RESET (P0.18) на площадки TC2030 не выведен: он во внутреннем ряду. nRF52833 программируется и восстанавливается по SWD без вывода сброса (`nrfjprog --recover`). SWO (P1.00) занят под ШИМ пищалки.

### D-23. Делитель VIN_SENSE 1 МОм / 1,5 МОм вместо 2 × 1 МОм

Делитель 1:1 давал на GPIO 2,4–2,6 В при 5 В ±5 % от полётника. Порог высокого уровня nRF52833 — 0,7 · VDD = 2,31 В, запас всего 65 мВ. Этот же вывод будит модуль из SHIP (System OFF) по появлению 5 В, поэтому уровень должен читаться надёжно.

Новое отношение 0,6 даёт 2,85–3,15 В: запас над порогом больше 0,5 В, и напряжение не выше VDD + 0,3 В. Резистор 1,5 МОм — LCSC C22276, Extended. В Standard PCBA каждая позиция BOM стоит одинаково, это +1,53 $ на заказ. Подобрать отношение 0,55–0,63 только из уже взятых номиналов нельзя.

Заменяет: строку «VIN_SENSE 2 × 1 МОм» в таблице номиналов components.md.

### D-22. Футпринт ANNA-B402 вместе с антенной зоной; противовес строго по референсу

Футпринт `cricket:ANNA-B402_CornerAntenna` содержит:

- 56 площадок по рисунку 5 datasheet;
- противовес — медь вывода 1 под маской;
- зону запрета дорожек, переходных отверстий и заливки на обоих слоях по рисункам 33–34 руководства u-blox.

Символ и футпринт генерирует скрипт `hardware/cricket-tag/lib/gen_anna_b402.py`. Положение площадок сверено с чертежом datasheet и с референс-дизайном.

Рисунки u-blox теперь прочитаны точнее:

- 0,16 мм — отступ противовеса от корпуса модуля, а не от кромки платы. Полоска лежит на оси столбца выводов 1–9.
- Кромки платы на рисунке не образмерены. Торцевая кромка — в 4 мм от корпуса (рисунок 34), боковая — примерно в 0,7 мм (оценка по рисунку).
- Зона без земли одинакова на всех слоях. Числа 3,6 и 4 мм, записанные раньше для внутренних слоёв, — это ширина выреза под модулем и расстояние до кромки.

Модуль ставится так же, как у u-blox. Тогда противовес оказывается примерно в 0,86 мм от боковой кромки и в 0,5 мм от торцевой. Правила JLCPCB (0,2 мм при фрезеровке, 0,4 мм при V-cut) выполняются без отступлений от референса. Модуль с антенной занимает угол 7,2 × 10,5 мм.

Заменяет: запись «противовес в 0,2 мм от кромки вместо 0,16 мм» в components.md и manufacturing.md. Отдельным решением она не была.

## 2026-11-09, вторая сессия

Решения D-13…D-21 приняты после проверки наличия компонентов.

### D-21. Первый заказ — тестовая партия 8 плат — **уточнено D-30, D-31**

Панель 2 × 2 размером около 70 × 70 мм с технологическими полями, собираются 2 панели: 8 плат примерно за 230 $ (~29 $ за плату). Минимум сборки JLCPCB — 2 панели, для Standard PCBA панель не меньше 70 × 70 мм. Сбор 20 $ за проверку к модулю и излучателю не применяется (он для разъёмов, переключателей, предохранителей, аккумуляторов), на модуль возможна пошлина 3–30 %. Серийная панель 4 × 3 — после тестов. Расчёт в [cost.md](cost.md#тестовая-партия-расчёт-jlcpcb-2026-11-10). **Уточнено D-30 и D-31:** живые расчёты ~250–285 $ (JLCPCB) и 322 $ с акцией (NextPCB), панель с фрезеровкой, завод не выбран.

### D-20. Излучатель Same Sky CPT-1117-83-SMT-TR — **заменено D-25, возвращено D-27**

11 × 9 × 1,7 мм, 0,2 г, 83 дБ тип. на 10 см при 5 В размаха, предел 25 В, 4,1 кГц, −40…+85 °C. По datasheet громче, легче и ниже CPT-12123-81 (сравнение в [components.md](components.md#излучатели-сравнение-по-datasheet)).
Закупка: на LCSC нет, JLCPCB закупает через Global Sourcing. Наличие 2026-11-09: Arrow 1 383 шт. по 1,20 $ от 10 шт., Online Components и Master Electronics по 1 480 шт. от 500. JLCPCB берёт через Verical — площадку Arrow. Если при заказе позиция не найдётся, запасной вариант — CPT-12123-81 (LCSC C3812179), но это другое посадочное место.
Следствие: плату можно сузить с 13 до 11 мм, как у Flywoo. Решается при разводке, документы пока описывают 22 × 13 мм.
Заменяет: D-13.

### D-19. Радио со склада JLCPCB для тарифа Economic — **отклонено владельцем**

Предлагался Ebyte E73-2G4M08S1F (nRF54L15, 12 × 17,2 мм, склад JLCPCB): тариф Economic, примерно на 2 $ за плату дешевле и на ~2 недели быстрее. Владелец оставил ANNA-B402: масса и размер важнее цены (маячок с Ebyte тяжелее на ~0,9 г, плата ~33 × 13 мм вместо 22 × 13). Сравнение в [module-options.md](module-options.md).

### D-18. Прошивка ревизии A на nRF Connect SDK v2.8.0, ток заряда 45 мА — **SDK заменён на v3.4.2, D-32**

Everytag не собирается на SDK 3.x из-за изменений Bluetooth-API; на v2.8.0 он с MCUboot и OTA помещается в nRF52833 с запасом ~34 КБ. Ток заряда снижен с 100 до 45 мА (PROG 22 кОм): 100 мА больше 1C для аккумулятора 40–60 мА·ч.

### D-17. Ожидаемая дальность пересмотрена

На маленькой плате встроенная антенна ANNA-B4 излучает заметно хуже, чем на большой. По примерам u-blox: плата 46 × 8 мм даёт около 250 м на 1M у модуля с +4 dBm, плата 7,5 × 12 мм — около 100 м; с +8 dBm у ANNA-B402 примерно в 1,5 раза больше. Для платы 22 × 13 мм ориентир 150–250 м на 1M и 300–500 м на Coded PHY при прямой видимости. Прежняя оценка 500 м – 1 км относилась к большой плате и снимается.

### D-16. Внешний кварц 32,768 кГц — **не нужен после D-29**

Seiko Epson X1A0000610002, корпус 2012, LCSC C55208, конденсаторы нагрузки 2 × 18 пФ. u-blox указывает, что минимальный ток в режимах сна достигается только с внешним кварцем.

### D-15. Радиомодуль u-blox ANNA-B402-00B — **заменено D-29**

nRF52833, 6,5 × 6,5 × 1,2 мм, встроенная чип-антенна, +8 dBm, Coded −103 дБм. JLCPCB закупает его сам через Global Sourcing у Mouser (1 642 шт.) или Future (1 500 шт.). Отправка деталей на завод исключена владельцем.
Почему не другие:
- Ezurio BL54L15µ 453-00223: 0 штук у всех авторизованных дистрибьюторов.
- Raytac AN54LV-15: только маркетплейс и брокеры, потребовалась бы отправка на завод.
- Fanstel BM15C (nRF54L15): 10 × 15,8 мм, плата выросла бы до 13 × 30 мм.
- Голый nRF54L10 со склада JLCPCB: 4 слоя и настройка антенны, риск по дальности.

Цена решения: средний ток в режиме маяка выше, чем у nRF54L15. По расчёту в [concept.md](concept.md#энергобюджет-оценка-уточнить-замером) режим маяка на аккумуляторе 40–60 мА·ч держится 2–4 недели.
Заменяет: выбор модуля в D-3 и D-2 (nRF54L15). Подход «модуль, а не голый чип» сохраняется.

### D-14. LDO на 3,3 В (TPS7A0233) вместо 3,0 В

Номинальное напряжение ANNA-B402 по datasheet — 3,3 В (диапазон 1,7–3,6 В). Встроенный DC/DC модуля эффективнее при более высоком входном напряжении. 3,3 В совпадает с логикой UART полётника. Запас до максимума 3,6 В — 0,3 В.
Первоначальное обоснование опиралось на токи BL54L15µ; после перехода на ANNA-B402 (D-15) решение сохраняется по причинам выше.

### D-13. Бипер Same Sky (CUI) CPT-12123-81-SMT-TR, без Murata и без второго посадочного места — **заменено D-20**

12 × 12 × 3 мм, 81 дБ при 5 В размаха, предел 25 В, LCSC C3812179. Драйвер PAM8904E остаётся. Первая партия с одним излучателем, проверка в деле, замена во второй ревизии при необходимости. Кандидат на замену: CPT-1117-83-SMT-TR (11 × 9 × 1,7 мм, 83 дБ).
Причина: Murata снят с производства, владелец решил не сравнивать два варианта в первой партии.
Заменяет: D-7.

## 2026-11-09

### D-12. Кнопка и защита от ложной тревоги

Тревога при пропаже 5 В включается не всегда. Признаки падения сочетаются: статус armed с полётника по MSP, удар по акселерометру, нарастающая громкость как запасной вариант. Кнопка нужна в любом случае: выключение тревоги, привязка, режим хранения, тест, загрузчик.
Причина: у готовых маячков тревога срабатывает при каждой замене аккумулятора.

### D-11. Акселерометр LIS2DH12 на плате

Добавлен для распознавания удара при падении и движения. Корпус 2×2 мм, единицы мкА, ставится заводом.
Причина: отличает падение от замены аккумулятора, даже если UART к полётнику не подключён.

### D-10. Обе сети и своё приложение — **уточнено D-32, D-33**

Прошивка рекламирует пакеты Apple Find My и Google Find Hub (Everytag поддерживает обе) плюс свой протокол Cricket. Основной инструмент поиска: своё Android-приложение.
Причина: владелец на Android, но устройство должно быть универсальным. Краудсорсинговые сети помогают только там, где ходят люди, в поле и лесу это редкость.

### D-9. Размещение и форма платы — **размер уточнён D-28**

Плата вытянутая, около 22×13 мм (после разводки 17 × 32 мм, D-28), модуль с антенной на дальнем конце от разъёма. Конец с антенной должен выступать за карбон.
Причина: универсальный монтаж, в том числе под полётником, без потери дальности. Ширина 13 мм, а не 11 как у Flywoo, потому что излучатель был 12×12 мм. С CPT-1117-83 (D-20) ширину можно уменьшить до 11 мм при разводке.

### D-8. Целевые дроны

Pavo Pico II (80 мм) и крупнее. Тинивупы не целевые.

### D-7. Бипер: Murata PKLCS1212E40A1-R1 + драйвер PAM8904E, плюс запасное место — **заменено D-13**

Основной излучатель SMD-пьезо 12×12×3 мм, драйвер PAM8904E раскачивает его до 27 В размаха. Расчётно 90–95 дБ на 10 см. На плате второе, перекрывающееся посадочное место под излучатель другого типа. Первая партия заказывается в двух вариантах BOM.
Причина: громкость сопоставима с Flywoo Finder V1.0 при полной заводской сборке. Расчёт не проверен, выбор окончательно делается замером.
Заменяет: пьезодиск с мостом на транзисторах (не ставится заводом).

### D-6. Разъёмы вместо пайки проводов — **заменено D-26**

JST SH 1,0 мм: 2 контакта под аккумулятор, 4 контакта под полётник (5 В, GND, TX, RX).
Причина: завод не паяет провода и аккумуляторы. 4-й контакт TX даёт обратный канал в полётник (OSD, MSP).

### D-5. Полная заводская сборка на JLCPCB

Все компоненты на одной стороне, панелизация. Тип сборки уточнён при расчёте стоимости: Standard PCBA, см. [cost.md](cost.md). Радиомодуль закупается через JLCPCB Global Sourcing (модуль сменён на ANNA-B402 в D-15, отправка деталей на завод исключена).
Причина: владелец хочет заказывать готовые платы без ручной сборки.

### D-4. Двухслойная плата FR4 0,6 мм

Модуль со встроенной антенной не требует 4 слоёв.

### D-3. Модуль Ezurio BL54L15µ, а не голый чип — **модуль заменён в D-15**

nRF54L15 в модуле 6,3×7,9 мм со встроенной настроенной антенной.
Причина: голый nRF54L15 есть на LCSC, но требует 4-слойной платы и настройки антенны на анализаторе, занимает больше места, а ненастроенная антенна съедает дальность. Голый чип можно рассмотреть во второй ревизии ради цены.

### D-2. nRF54L15 вместо nRF52840 и ESP32 — **заменено D-15: nRF52833 в ANNA-B402 из-за наличия**

Вдвое меньше средний ток BLE-рекламы, чем у nRF52840, и на порядок меньше, чем у ESP32-C3. +8 dBm, Coded PHY.

### D-1. Не дорабатывать Epi_C3, проектировать с нуля

В Epi_C3 нет зарядки, защиты, бипера. Антенная цепь не задокументирована (TBD), ESP32 слишком прожорлив для маячка.
