yamaha252/Cricket/docs/protocol.md

# Протокол Cricket: реклама и GATT

Свой механизм поиска (D-32): что маячок рекламирует и какие команды принимает. Версия протокола 2 (в версии 1 не было возраста координат). Числа многобайтовые — little-endian. Реализация в [firmware/app](../firmware/app), сканер в приложении ([app.md](app.md)).

## Наборы рекламы

| Набор | PDU | PHY | Подключаемый | Мощность |
|---|---|---|---|---|
| Cricket Coded | extended | Coded S8 (первичный и вторичный канал) | да | +8 dBm |
| Cricket 1M | legacy | 1M | да, с ответом на сканирование (имя, по умолчанию `Cricket`) | +8 dBm |

Оба набора работают одновременно и несут одинаковые данные. Интервалы зависят от режима; ниже значения по умолчанию, приложение меняет их (см. «Настройки»):

| Режим | Coded | 1M |
|---|---|---|
| ON_DRONE, не armed | 1 с | 1 с |
| ON_DRONE, в полёте | выкл. | выкл. |
| ON_DRONE, armed без связи с пультом (failsafe, улёт) | 1 с | 1 с, данные каждые 2 с |
| ESCALATE, ALARM | 1 с | 2 с |
| BEACON | 2 с | 4 с |
| STANDBY | 5 с | 5 с |
| LOW_BAT | 10 с | 10 с |
| SHIP | выкл. | выкл. |

В полёте и в SHIP реклама выключена всегда, это не настраивается. При переходе в полёт маячок ещё и разрывает соединения с телефонами (D-37): иначе телефон, оставленный подключённым на столе, держал бы связь весь полёт; переподключиться он не сможет, пока реклама выключена. «В полёте» — armed по MSP, а без ответов MSP — вибрация моторов по акселерометру. Исключение — armed без связи с пультом (failsafe или флаг RXLOSS): приёмнику уже нечего ловить, и маячок рекламирует последние координаты, пока дрон летит (D-36).

Интервалы и мощность по умолчанию — предварительные, уточняются замером тока (см. [concept.md](concept.md#энергобюджет-оценка-уточнить-замером)).

## Данные рекламы

AD-структура Manufacturer Specific Data (тип `0xFF`), 26 байт вместе с длиной и типом; вместе с Flags — 29 байт из 31, влезает в legacy-рекламу.

| Смещение | Размер | Поле | Значение |
|---|---|---|---|
| 0 | 2 | Company ID | `0xFFFF` — значение SIG для тестов; свой ID не получен |
| 2 | 1 | Версия | `0x02` |
| 3 | 4 | ID маячка | CRC32 от FICR DEVICEID, постоянный |
| 7 | 1 | Режим | 0 ON_DRONE, 1 ESCALATE, 2 ALARM, 3 BEACON, 4 STANDBY, 5 LOW_BAT, 6 SHIP |
| 8 | 1 | Флаги | бит 0 — есть 5 В, 1 — идёт заряд, 2 — координаты действительны, 3 — пищит, 4 — был armed перед пропажей 5 В, 5 — был удар, 6 — открыто окно DFU, 7 — открыто окно привязки |
| 9 | 2 | Батарея | мВ, `uint16` |
| 11 | 1 | Мощность на 1 м | дБм, `int8`, калибровка RSSI на 1 м (по умолчанию −59, задаётся настройкой `0x04`) |
| 12 | 2 | Время в режиме | минуты с начала текущего режима, `uint16`, насыщается на 65535 |
| 14 | 4 | Широта | 1e-7 градуса, `int32` |
| 18 | 4 | Долгота | 1e-7 градуса, `int32` |
| 22 | 2 | Возраст координат | секунды с получения, `uint16`; `0xFFFF` — координат нет или они старше 18 ч |

Приложение отбирает рекламу по Company ID и версии, маячки различает по ID. Координаты — последние полученные от полётника по MSP; если их не было, флаг 2 снят, поля нулевые.

Данные обновляются при смене режима и раз в 10 с.

## GATT-сервис Cricket

Сервис `2083eb8d-7651-438b-b7fb-75aff5da9c00`.

| Характеристика | UUID | Свойства | Содержимое |
|---|---|---|---|
| Состояние | `2083eb8d-7651-438b-b7fb-75aff5da9c01` | read, notify | 22 байта рекламы после Company ID (со смещения 2) |
| Управление | `2083eb8d-7651-438b-b7fb-75aff5da9c02` | write; шифрованное соединение, кроме FIND в тревоге | команда: код и параметры |
| Настройки | `2083eb8d-7651-438b-b7fb-75aff5da9c03` | read, write; только шифрованное соединение | настройки, см. ниже |
| Владелец | `2083eb8d-7651-438b-b7fb-75aff5da9c04` | read; открыто в ESCALATE, ALARM, BEACON, иначе только шифрованное соединение | контакт владельца, UTF-8; пусто, если не задан или закрыт |

Команды:

| Код | Параметры | Действие |
|---|---|---|
| `0x01` FIND | `uint8` секунд (0 — стоп) | пищать и мигать заданное время, в любом режиме кроме SHIP |
| `0x02` SILENCE | — | выключить тревогу: из ESCALATE, ALARM, BEACON в STANDBY, а если 5 В есть — в ON_DRONE (маячок продолжает следить за следующим полётом) |
| `0x03` DFU | — | открыть окно обновления прошивки на 5 мин |
| `0x04` FORGET | — | забыть все привязанные телефоны, кроме этого |
| `0x05` DEFAULTS | — | вернуть настройки по умолчанию; привязки и контакт владельца не трогает |

Кроме сервиса Cricket есть стандартный сервис MCUmgr SMP (`8d53dc1d-1db7-4cd3-868b-8a527460aa84`) для обновления прошивки; он тоже требует шифрованного соединения, а его команды принимаются только в окне DFU (флаг 6), см. [firmware/README.md](../firmware/README.md#обновление-прошивки).

## Настройки

Характеристика «Настройки» — список записей `{ключ uint8, длина uint8, значение}`. Чтение возвращает все записи. Запись принимает одну или несколько записей в любом порядке; остальные настройки не меняются. Если хоть одна запись неверна, не применяется ничего.

| Ключ | Длина | Значение | Допустимо | По умолчанию |
|---|---|---|---|---|
| `0x01` | 1–20 | имя устройства, UTF-8 без нуля в конце: ответ на сканирование набора 1M и имя GAP | — | `Cricket` |
| `0x02` | 1 | мощность набора Coded, дБм, `int8` | −40…+8 | +8 |
| `0x03` | 1 | мощность набора 1M, дБм, `int8` | −40…+8 | +8 |
| `0x04` | 1 | RSSI на 1 м для рекламы, дБм, `int8` | ≤ 0 | −59 |
| `0x05` | 0–64 | контакт владельца для нашедшего (телефон, ник), UTF-8 без нуля; длина 0 — стереть | — | пусто |
| `0x06` | 1 | предполётный писк при появлении 5 В: 1 — да, 0 — нет | 0, 1 | 1 |
| `0x10` + режим | 4 | интервалы в режиме: `uint16` Coded, `uint16` 1M, мс; 0 — набор выключен | 0 или 100…10 240 | таблица в «Наборах рекламы» |

Режимы для ключей `0x10`…`0x15`: 0 ON_DRONE (не armed), 1 ESCALATE, 2 ALARM, 3 BEACON, 4 STANDBY, 5 LOW_BAT.

- В каждом режиме должен остаться включённым хотя бы один набор: иначе маячок нельзя было бы найти и подключиться к нему, чтобы вернуть настройку.
- Мощность: контроллер выбирает ближайшую поддерживаемую ступень, фактическая видна в логе; чтение возвращает заданное значение. После смены мощности стоит поменять и RSSI на 1 м: приложение пересчитывает по нему расстояние.
- Верхний предел 10,24 с — максимум для legacy-рекламы.
- Ошибки записи: `0x0D` — неверная длина записи, `0x06` — неизвестный ключ, `0xFF` — значение вне допустимого.
- Настройки применяются сразу (наборы перезапускаются, соединение не рвётся) и хранятся в разделе настроек: переживают сброс и обновление прошивки. Команда DEFAULTS возвращает значения по умолчанию.

### Контакт владельца

Нашедший дрон (с приложением Cricket или nRF Connect) подключается к маячку и читает характеристику «Владелец». Открыта она, только пока маячок потерян (ESCALATE, ALARM, BEACON): в остальное время контакт видит лишь привязанный телефон, чтобы маячок на дроне не раздавал номер всем вокруг. Что указать — решает владелец; это публичные данные, пока дрон потерян.

## Привязка и защита

- Реклама и характеристика состояния открыты всем: это то же, что маячок и так рассылает.
- Команды, настройки и обновление прошивки — только с привязанного телефона: характеристика управления проверяет шифрование соединения для каждой команды, SMP требует его всегда; зашифровать соединение может только телефон с ключами привязки.
- Исключение — FIND, пока маячок в ESCALATE, ALARM или BEACON: её примет любой телефон, чтобы упавший дрон мог искать и помощник. Без привязки пищать можно не дольше 60 с за команду; SILENCE, DFU и FORGET без привязки не принимаются (решение владельца 2026-11-11).
- Привязка — LE Secure Connections, без ввода кода (Just Works: у маячка нет экрана и клавиатуры). Новый телефон принимается только в **окне привязки** на 60 с, флаг 7 в рекламе. Окно открывает удержание кнопки 3 с (два коротких писка) или удержание при подаче питания для DFU; после успешной привязки окно закрывается, маячок пищит один раз.
- Вне окна запрос привязки отклоняется. Android сам предлагает привязку, когда запись в защищённую характеристику получает ошибку «недостаточное шифрование»: приложению достаточно записать команду, пока окно открыто.
- Хранится до 4 телефонов; пятый вытесняет самый старый. Ключи лежат в разделе настроек и переживают сброс и обновление прошивки; стирает их только полное стирание по SWD.
- Потерянный телефон: открыть окно кнопкой, привязать новый и отправить с него FORGET.
- Ограничения: в окне привязки нет защиты от подмены (MITM) — злоумышленник рядом в эти 60 с мог бы привязаться вместо владельца. В тревоге любой прохожий с приложением может заставить маячок пищать; выключить тревогу может только владелец.
