yamaha252/Cricket/docs/module-options.md

# Радио без Global Sourcing: варианты

Цель владельца: дешёвый тариф JLCPCB Economic без доплат и задержек. Для этого все детали, включая радио, должны быть на складе JLCPCB/LCSC. Модуль ANNA-B402 (текущий на 2026-11-09; с D-29 — ISP2454-LX, тоже через Global Sourcing) на складе отсутствует и идёт через Global Sourcing (решение D-15), что переводит заказ в Standard: постоянные расходы ~69 $ против ~34 $ и плюс 9–15 дней на закупку.

Проверено 2026-11-09 по каталогу JLCPCB и LCSC.

## Кандидаты со склада JLCPCB

| Вариант | Чип | Размер | Мощность | Coded 125 кбит/с | Склад JLCPCB | Цена | Прошивка |
|---|---|---|---|---|---|---|---|
| **Ebyte E73-2G4M08S1F** (C54337734) | nRF54L15, 1,5 МБ / 256 КБ | 12,0 × 17,2 мм, PCB-антенна | +8 dBm | ~−103 дБм (по чипу) | 123 | 5,69 $ | Everytag поддерживает nRF54L15, путь проверен |
| Голый **nRF54L10-QFAA-R7** (C44800139) | nRF54L10, 1 МБ / 192 КБ | QFN48 6 × 6 + обвязка и антенна | +8 dBm | −103 дБм | 247 | 3,83 $ | Everytag портирован на SDK 3.4.2 и собран (см. ниже) |
| RF-star RF-BM-BG22C3 (C5369196) | Silicon Labs EFR32BG22, 512 КБ / **32 КБ ОЗУ** | 8 × 8 × 1,82 мм | +6 dBm | −106,7 дБм | 128 | 4,21 $ | Zephyr поддерживает BG22 через блобы Silicon Labs; Everytag на BG22 не проверен, ОЗУ мало |
| RF-star RF-BM-2340C2 (C22358994) | TI CC2340R5, 512 КБ / 36 КБ | 8 × 8 мм | +8 dBm | −102 дБм | 128 | 4,11 $ | TI SimpleLink; Find My и Find Hub писать с нуля |
| Silicon Labs BGM220PC22 (C1512691) | EFR32BG22 | 12,9 × 15 мм | +8 dBm | −106 дБм | 81 | 6,28 $ | как BG22C3, крупнее |
| u-blox ANNA-B402 (текущий, D-15) | nRF52833 | 6,5 × 6,5 мм | +8 dBm | −103 дБм | **0**, только Global Sourcing | ~7 $ | проверен на SDK 2.8.0 |

Других модулей Nordic с наличием на складе JLCPCB нет: Raytac, Holyiot, Minew и мелкие Ebyte на nRF54 — 0–1 шт.

## Оценка вариантов

### Ebyte E73-2G4M08S1F — минимальный риск

- Всё со склада, тариф Economic, без Global Sourcing.
- Готовая настроенная антенна, тот же чип nRF54L15, на который изначально рассчитывали: ток в режиме маяка ниже, чем у nRF52833.
- Прошивка: Everytag официально поддерживает nRF54L15 (SDK 2.8.0), есть порт на 3.4.2.
- Минус: модуль 12 × 17,2 мм. Плата вырастет примерно до 13 × 33 мм, маячок потяжелеет примерно на 0,9 г (расчёт ниже). Антенна модуля — на его торце, этот торец должен быть на краю платы.
- Склад 123 шт. — хватает на прототипы и первую партию.

### Голый nRF54L10 — самый лёгкий и дешёвый, но с радиоразработкой

- **Прошивка — не проблема.** SDK 2.8.0 nRF54L10 не знает, а SDK 3.4.2 знает. Everytag переносится на 3.4.2 правкой трёх строк (`bt_hci_cmd_create` → `bt_hci_cmd_alloc`, `BT_LE_ADV_OPT_CONNECTABLE` → `BT_LE_ADV_OPT_CONN`, `&auth_uuid` → `&auth_uuid.uuid`). Сборка под `nrf54l15dk/nrf54l10/cpuapp` с MCUboot прошла: приложение 186 КБ из 444 КБ слота (42 %), MCUboot 40 КБ из 62 КБ, ОЗУ 56 КБ из 192 КБ. Запас втрое больше, чем на nRF52833.
- **Радиочасть — главный риск.** Нужны кварц 32 МГц, согласующая цепь, индуктивность DC/DC и антенна (чип-антенна или печатная). Nordic рекомендует 4 слоя. Без векторного анализатора согласование антенны не подстроить, ошибка легко съедает 3–6 дБ, то есть до половины дальности.
- **4 слоя дороже и толще**: у JLCPCB 0,6 мм доступно только для 2 слоёв, 4 слоя — от 0,8 мм.
- Склад 247 шт., у nRF54L05 (500 КБ) — 1 116 шт.
- Разумный путь: ревизия B, когда будет работающая плата-эталон для сравнения дальности.

### RF-star RF-BM-BG22C3 — маленький и дешёвый, но рискованный по прошивке

- 8 × 8 мм, лучшая чувствительность на Coded PHY (−106,7 дБм), очень экономичный чип.
- **32 КБ ОЗУ.** Everytag на nRF52833 занимал 52 КБ ОЗУ, на nRF54L10 — 56 КБ. Без обновления по воздуху и с урезанной конфигурацией может поместиться, но это не проверено.
- Другая экосистема: Zephyr с закрытыми блобами Silicon Labs; поддержка Coded PHY в контроллере Zephyr для BG22 не подтверждена.

### RF-star RF-BM-2340C2 — не рекомендуется

Прошивку для Find My и Find Hub пришлось бы писать с нуля на TI SimpleLink.

## Ограничения тарифа Economic

- Только детали со склада LCSC/JLCPCB, только одна сторона, только панели на перемычках (mouse bites), не V-cut.
- Количество: 2–50 шт. на заказ (из справки неясно, плат или панелей).
- Излучатель: CPT-12123-81 есть на складе (226 шт.), CPT-1117-83 — нет, поэтому в Economic только первый или KLJ-1230. Выбранный в D-20 CPT-1117-83 идёт через Global Sourcing, что совместимо только с Standard.

## Решение

**Владелец оставил ANNA-B402** (D-19 отклонено): масса и размер важнее цены и сроков. Рекомендация ниже сохранена для истории. 2026-11-10 ANNA-B402 заменён на ISP2454-LX (D-29), см. перепроверку ниже.

## Рекомендация (не принята)

Для ревизии A — **Ebyte E73-2G4M08S1F**: Economic без доплат, всё со склада, прошивка и антенна готовы, экономичный nRF54L15. Цена — плата длиннее и маячок тяжелее примерно на 0,9 г. Голый nRF54L10 — для ревизии B, когда будет эталон для сравнения дальности.

## ANNA-B402 и Ebyte E73-2G4M08S1F: цена, габариты, масса

Расчёт 2026-11-09, до расстановки и разводки: плата ANNA-B402 тогда оценивалась в 22 × 13 мм. После D-26…D-28 она 17 × 32 мм и ~0,65 г с излучателем CPT-1117-83; плата с Ebyte при том же излучателе выросла бы так же, поэтому разница в массе (~0,9 г, в основном сам модуль) остаётся. Габариты и массы в таблице ниже не пересчитаны. Платы — по калькулятору JLCPCB, сборка — по тарифам JLCPCB, компоненты — LCSC и Mouser. Масса Ebyte — по руководству производителя (0,8 г ± 0,1 г), масса ANNA-B402 в datasheet не указана, оценка ~0,1 г.

### Габариты и масса

| | ANNA-B402 (текущий) | Ebyte E73-2G4M08S1F |
|---|---|---|
| Модуль | 6,5 × 6,5 × 1,2 мм | 12,0 × 17,2 мм, PCB-антенна на торце |
| Масса модуля | ~0,1 г | 0,8 г |
| Кварц 32,768 кГц | внешний (C55208 + 2 конденсатора) | встроен в модуль |
| Плата | 22 × 13 мм | ~33 × 13 мм: модуль занимает почти всю ширину на 17 мм длины |
| Масса платы | ~0,3 г | ~0,45 г |
| Высота | ~7–8 мм, определяется излучателем и аккумулятором | та же |
| **Масса маячка с аккумулятором и кабелем** | **~2,8–3,2 г** (с CPT-12123-81; с CPT-1117-83 ~2,5–2,9 г) | **~3,7–4,1 г** |
| Для сравнения | Flywoo Finder V1.0 2,7 г, VIFLY Finder Mini 2,8 г | VIFLY Finder 2 4,9 г |

### Радио и питание

| | ANNA-B402 | Ebyte E73-2G4M08S1F |
|---|---|---|
| Чип | nRF52833 | nRF54L15 |
| Чувствительность 1M / Coded | −94 / −103 дБм | −96 / −104 дБм |
| Мощность | +8 dBm | +8 dBm |
| Сон | 0,6 мкА (System OFF) | ~1 мкА по Ebyte |
| Средний ток маяка | база расчёта | ниже: nRF54L тратит на рекламу заметно меньше, чем nRF52 |
| Прошивка | SDK 2.8.0, Everytag проверен | SDK 2.8.0 или 3.4.2, Everytag поддерживает nRF54L15 |

### Стоимость партии

| | ANNA-B402, Standard + Global Sourcing | Ebyte, Economic, всё со склада |
|---|---|---|
| Плат на панели | 12 | 10 |
| Постоянные расходы на заказ | ~69 $ | ~34 $ |
| Компоненты на плату, 10–99 шт. | 11,97 $ | 10,42 $ |
| Пайка на плату | ~0,45 $ (с ручной обработкой модуля) | ~0,23 $ |
| Партия ~20–24 шт. | 24 шт. — ~426 $, **~17,8 $/шт.** | 20 шт. — ~306 $, **~15,3 $/шт.** |
| Партия ~50–60 шт. | 60 шт. — ~887 $, **~14,8 $/шт.** | 50 шт. — ~637 $, **~12,7 $/шт.** |
| Партия 120 шт. | ~1 509 $, **~12,6 $/шт.** | ~1 305 $, **~10,9 $/шт.** |
| Срок | сборка от 4 дней + закупка модуля 9–15 дней | сборка 1–3 дня |

Цифры для ANNA-B402 посчитаны с прежним излучателем CPT-12123-81. С выбранным CPT-1117-83 (D-20): ~17,0 / ~14,0 / ~11,8 $ за плату.

Доставка заложена одинаково: 30–45 $ в зависимости от веса. Если в Economic ограничение 50 шт. считается по платам, партия 120 шт. пойдёт по Standard: ~11,2 $/шт.

### Итог

Ebyte дешевле примерно на 2 $ за плату (~15 %), быстрее на ~2 недели, экономичнее по батарее и чуть чувствительнее. ANNA-B402 легче примерно на 0,9 г и даёт плату 22 × 13 мм вместо ~33 × 13 мм. Выбор — между массой и размером (первый приоритет проекта) и ценой со сроками.

## Перепроверка 2026-11-10: маленькие модули на nRF54L

Владелец спросил, нельзя ли взять чип нового поколения. Искались модули на nRF54L размером примерно как ANNA-B402 и мельче, с наличием на складе JLCPCB или у дистрибьюторов, у которых JLCPCB закупает через Global Sourcing. Склад JLCPCB и Mouser — на 2026-11-10. Digi-Key проверить не удалось: сайт блокирует автоматический доступ.

| Модуль | Размер, мм | Антенна | Склад JLCPCB | Mouser | Цена Mouser | Что ещё нужно на плате |
|---|---|---|---|---|---|---|
| **Insight SiP ISP2454-LX** (nRF54L15) | 8,0 × 8,0 × 1,0, LGA-62, шаг 0,65 | чип-антенна внутри | 0, предзаказ C44975104 (оценка JLCPCB ~19,9 $) | -JT 838 шт., -RS 1 397 шт. | 4,59 € (-JT), 9,54 € (-RS) | ничего: оба кварца и DC/DC внутри |
| KAGA FEI ES4L15BA1 (nRF54L15 CSP) | 3,25 × 8,55 × 1,0, LGA-28, шаг 0,6 | печатная, на торце модуля (3,4 мм) | только «consign» | 199 шт. | 14,10 €, 11,63 € от 25 шт. | дроссель 4,7 мкГн 1608, кварц 32,768 кГц (или LFRC) |
| Ezurio BL54L15µ (453-00223 / -00224) | — | чип / вывод под антенну | — | 0, в заказе; -00224 ожидается 07/2027 | ~4,1 € | — |
| Raytac AN54LV-15 | 6,4 × 8,4 × 1,5 (по таблице Nordic) | чип-антенна | 0, предзаказ C53949891 (~11,5 $) | нет | — | не проверялось |
| Tangshan Hongjia HJ-N54L_SIP | 4,5 × 4,5 × 1,1 | не ясно | только «consign» | нет | — | — |
| Minew ME54BS62 | 6 × 9 × 1,8 | печатная | 0, предзаказ | нет | — | — |

Реально доступны сейчас два: **ISP2454-LX** и **ES4L15BA1**.

### ISP2454-LX — главный кандидат

- Наружный ряд даёт ровно 12 GPIO (P1.11, P2.02, P2.04, P2.05, P1.04, P1.05, P1.07, P0.03, P0.02 сверху; P1.02/NFC1, P1.03/NFC2, P2.01 сбоку) плюс VDD, SWDIO, SWDCLK и GND. У нас 12 сигналов, поэтому внутренние ряды не нужны, как и у ANNA-B402 (D-24). Зазор между наружными площадками тот же — 0,3 мм.
- Распределение по портам — см. «Расстановка и выводы» ниже: все 12 сигналов ложатся, но один (RX UART) берётся с внутренней площадки.
- Антенна: модуль в 1 мм от торцевой кромки; под антенной половиной модуля (4 мм) и до кромки — без меди на всех слоях. В углу платы боковая зона запрета 5 мм внутрь и 1 мм к боковой кромке. На плате 17 мм шириной это ~14 × 5 мм у торца, плюс сам модуль: всего ~106 мм² против ~88 мм² у ANNA-B402 с кварцем (угол 7,2 × 10,5 мм). Плата, вероятно, удлинится на 1–2 мм; точно покажет `floorplan.py`. Симуляция производителя сделана на «земле» 18 × 30 мм — почти наша плата.
- Питание: TX 0 dBm 3,7 мА против 6,0 мА у ANNA-B402, System ON с RAM и LFXO 1,5 мкА против 2,6 мкА. Мощность +8 dBm, Coded −104 дБм (по чипу), усиление антенны 0,6 dBi — дальность та же.
- Память 1,5 МБ / 256 КБ: запас под прошивку большой. Everytag поддерживает nRF54L15 на SDK 2.8.0.
- Масса в datasheet не указана.

### ES4L15BA1 — самый узкий, но сложнее

- Корпус 3,25 × 8,55 мм ставится на торец платы; зона без меди ~13,25 × ~3,9 мм у кромки, длина «земли» желательна от 30 мм.
- На наружных площадках ~8 GPIO, из них два — выводы кварца. Остальные GPIO — внутренние площадки, в том числе круглые в центре: нужны переходные в площадках, на двух слоях 0,6 мм это риск.
- Нужен внешний дроссель 4,7 мкГн рядом с модулем, кварц 32,768 кГц снаружи.
- Дороже (11–14 €), у JLCPCB только как «consign»; закупка через Global Sourcing не проверена.

### ISP2454-LX: расстановка и выводы (2026-11-10)

Футпринты `cricket:ISP2454-LX_CornerAntenna` и `cricket:ISP2454-LX_NarrowEnd` генерирует `hardware/cricket-tag/lib/gen_isp2454.py`: площадки — по библиотеке Eagle производителя, зона без меди и курятник до кромки — по datasheet, разд. 4.3. Между наружными площадками 0,25 мм (у ANNA-B402 0,3 мм): дорожку между ними не провести, сигналы — только с наружного ряда, как в D-24.

Расстановка (`floorplan.py`, DRC без перекрытий курятников; картинка `hardware/cricket-tag/floorplan/floorplan-isp2454.png`). Сравнение плотных вариантов без запаса под разводку:

| Вариант | Модуль | Размер | Площадь |
|---|---|---|---|
| `w16b` | ANNA-B402 | 16 × 29,2 мм | 467 мм² |
| `isp_a16` | ISP2454-LX в углу | 16 × 29,4 мм | 470 мм² |
| `isp_b` | ISP2454-LX, торец 10 мм | 17 × 30,1 мм, торец 10 × 5 | 477 мм² |
| `w17d` (разведена) | ANNA-B402 | 17 × 32 мм | 544 мм² |
| `isp_c` (разведена, D-29) | ISP2454-LX | 17 × 32 мм | 544 мм² |

- Плата **не меньше и не больше**: модуль с зоной антенны короче угла ANNA-B402 на 1,5 мм (9,25 против 10,75 мм) и без ряда кварца, но зона без меди у торца шире (14 × 5 мм против 7,6 мм) и вытесняет кнопку и акселерометр ниже. После разводки ожидается тот же размер, что сейчас, ~17 × 31–32 мм.
- Минус 5 деталей: Y1, C8, C9 (кварц) и C6, C7 (развязка модуля; внутри 11,2 мкФ). В BOM минус две уникальные позиции (кварц C55208, 18 пФ C1549). Проверить устойчивость TPS7A0233 с 11,2 мкФ на выходе плюс C5.
- Масса: модуль 8 × 8 × 1 мм тяжелее ANNA-B402 (6,5 × 6,5 × 1,2) примерно на 0,05 г по объёму, кварц с конденсаторами легче на ~0,01 г. В пределах точности оценки.
- Верхний ряд выводов модуля смотрит на ряд резисторов под ним (UART, делители) — как у ANNA-B402. VDD, SWDIO, SWDCLK — на стороне у боковой кромки, в полосе 1 мм.

Порты nRF54L15 (datasheet, Pin assignments, QFN48; Nordic DevZone «Essential pin planning guidelines»):

- P2: нет прерываний и пробуждения (нет GPIOTE и DETECT); UARTE00/20 — только выделенные выводы (TXD P2.02, RXD P2.00 — внутренняя площадка модуля).
- P0 и P1 будят из System OFF. UARTE20/21, TWIM20/21, PWM20–22 — на P1; UARTE30/TWIM30 — на P0. SCL I2C — только на «тактовом» выводе: на наружном ряду это P1.03, P1.04, P1.11. АЦП — P1.04 (AIN0), P1.05 (AIN1), P1.07 (AIN3), P1.11 (AIN4). P0.03 — выход GRTC PWM.
- На наружном ряду P0 — 2 вывода, P1 — 6, P2 — 4. Сигналов, которым нужен P0/P1 (прерывание, пробуждение, АЦП, I2C, UART, ШИМ), — 9: на один больше.

Карта выводов, принятая в D-29, — в [README платы](../hardware/cricket-tag/README.md#схема). От первоначального варианта она отличается: GRTC PWM на P0.03 даёт только 128 Гц, поэтому BUZ_DIN — на P1.04 (PWM20); на P0.03 — VIN_SENSE (цифровой вход с пробуждением), кнопка — на P1.05, VBAT_SENSE — на P1.07/AIN3. Так сигналы, которые идут к резисторам под модулем, стоят в верхнем ряду слева, а те, что идут вправо (к драйверу, акселерометру, кнопке, зарядке), — справа. В спецификации GPIO nRF54L15 утечка между NFC-выводами не указана; при I2C в покое оба вывода на высоком уровне.

### Вывод

Если переходить на nRF54L, то на ISP2454-LX: модуль есть в наличии, экономичнее ANNA-B402 (TX 0 dBm 3,7 против 6,0 мА, сон 1,5 против 2,6 мкА), памяти втрое больше, на плате на 5 деталей меньше, дальность та же. Плата того же размера и массы. Цена перехода — новая схема и разводка (футпринт уже есть), одно переходное под модулем, прошивка под nRF54L15 (Everytag его поддерживает), отладочная плата nRF54L15 DK вместо nRF52833 DK. **Владелец выбрал ISP2454-LX (D-29, 2026-11-10).**

Источники перепроверки: [JLCPCB nRF54L](https://jlcpcb.com/parts/componentSearch?searchTxt=nRF54L&isSearch=true), [JLCPCB ISP2454](https://jlcpcb.com/parts/componentSearch?searchTxt=ISP2454&isSearch=true), [JLCPCB AN54L](https://jlcpcb.com/parts/componentSearch?searchTxt=AN54L&isSearch=true), [Mouser ISP2454](https://eu.mouser.com/en/c/?q=ISP2454), [Mouser ES4L15BA1](https://eu.mouser.com/en/c/?q=ES4L15BA1), [Mouser BL54L15](https://eu.mouser.com/en/c/?q=BL54L15), [Insight SiP ISP2454](https://insightsip.com/bluetooth-modules/isp2454/), [datasheet ISP2454 R7](https://www.insightsip.com/fichiers_insightsip/pdf/ble/ISP2454/isp_ble_DS2454.pdf), [datasheet ES4L15BA1 V1.0](https://www.mouser.lt/pdfDocs/ES4L15BA1_DataSheet_V1_0_20260624E.pdf), [Acal BFi AN54LV](https://www.acalbfi.com/technologies/communications/wireless-connectivity/bluetooth-modules/an54lv-series-bluetooth-6-0-lga-module-nrf54l15-based/).

## Источники

- Каталог JLCPCB: [nRF54L](https://jlcpcb.com/parts/componentSearch?searchTxt=nRF54L&isSearch=true), [E73-2G4M](https://jlcpcb.com/parts/componentSearch?searchTxt=E73-2G4M&isSearch=true), [RF-BM](https://jlcpcb.com/parts/componentSearch?searchTxt=RF-BM&isSearch=true), [BGM220](https://jlcpcb.com/parts/componentSearch?searchTxt=BGM220&isSearch=true)
- [Калькулятор JLCPCB](https://cart.jlcpcb.com/quote): панель 78 × 83 мм, 2 × 5 плат, 0,6 мм, ENIG — 5 панелей 24,50 $
- [Ebyte E73-2G4M08S1F, обзор серии](https://ebyteiot.com/blogs/ebyte-iot-blog/analysis-of-the-e73-2g4m08s1f-series-high-efficiency-communication-iot-wireless-module), [руководство Ebyte](https://atta.szlcsc.com/upload/public/pdf/source/20260507/996BBAC66F31C57B7A15BAEEE2D73A21.pdf)
- [RF-BM-BG22C3 datasheet](https://www.rfstariot.com/uploadfile/downloads/RF-BM-BG22C3%20Hardware%20Datasheet%20V1.0_20230526.pdf), [LCSC RF-BM-BG22C3](https://www.lcsc.com/product-detail/C5369196.html), [LCSC RF-BM-2340C2](https://www.lcsc.com/product-detail/C22358994.html)
- [EFR32BG22 в Zephyr](https://docs.zephyrproject.org/latest/boards/silabs/explorer_kits/xg22/doc/bg22_ek4108a.html), [EFR32BG22C224F512](https://www.silabs.com/wireless/bluetooth/efr32bg22-series-2-socs/device.efr32bg22c224f512im40)
- [CC2340R5](https://www.ti.com/product/CC2340R5)
- [Nordic nRF54L15 reference layout](https://www.nordicsemi.com/Products/nRF54L15/Reference-layout?lang=en), [DevZone: рекомендация 4 слоёв](https://devzone.nordicsemi.com/f/nordic-q-a/127632/nrf54l15-reference-design-onboarding-questions/564310)
