yamaha252/Cricket/hardware/cricket-tag/floorplan/floorplan-isp2454.png

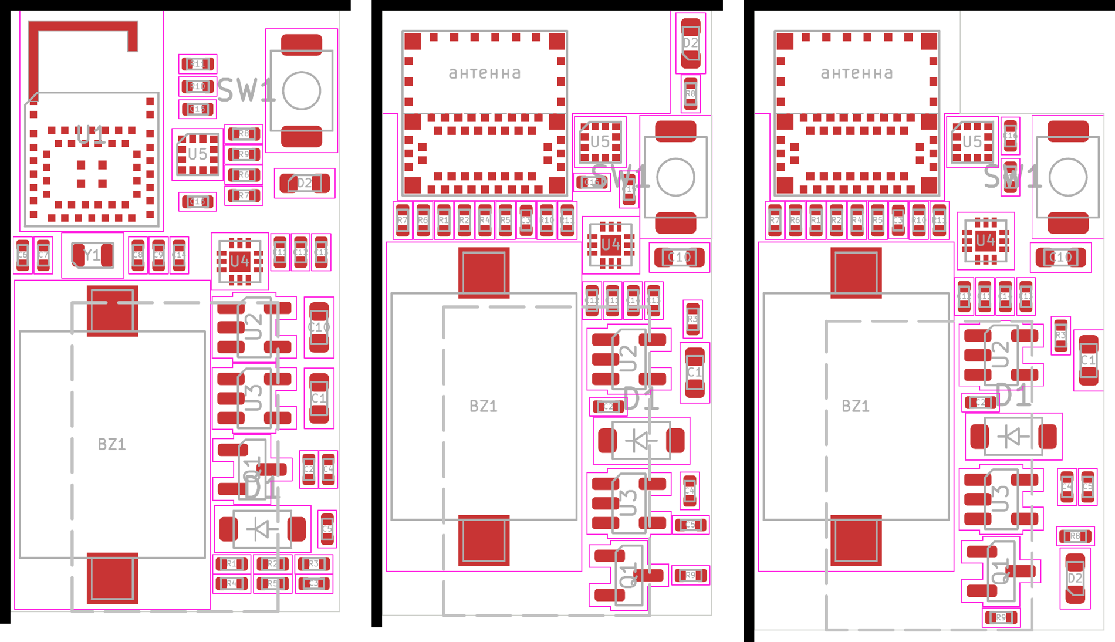
hardware/cricket-tag/floorplan/floorplan-isp2454.png
