yamaha252/Cricket/hardware/cricket-tag/floorplan/floorplan-w14.png

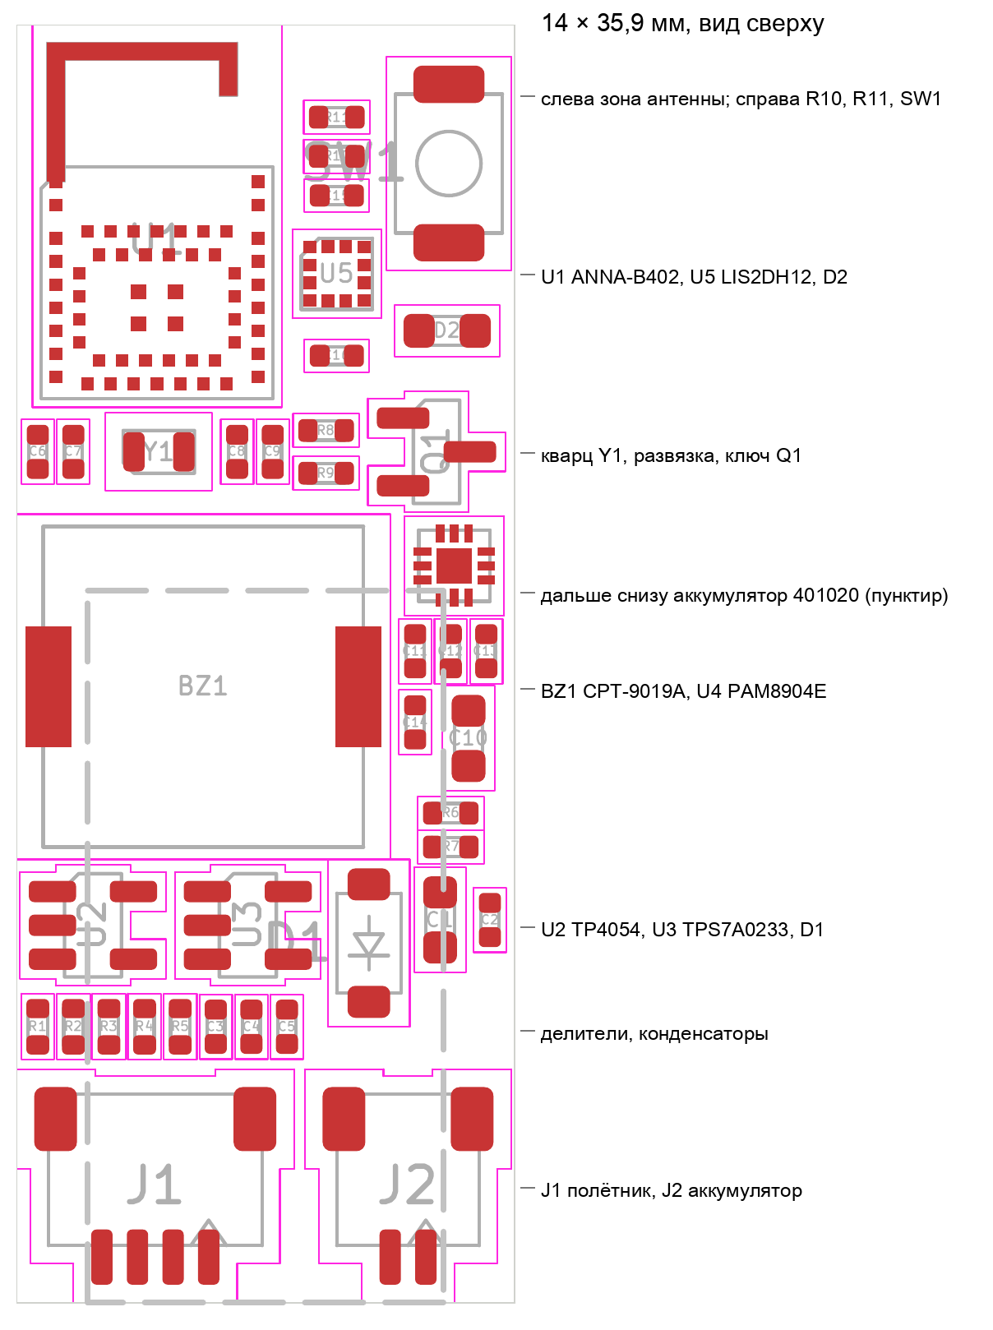
hardware/cricket-tag/floorplan/floorplan-w14.png
