yamaha252/Cricket/hardware/cricket-tag/floorplan/floorplan-w14s.png

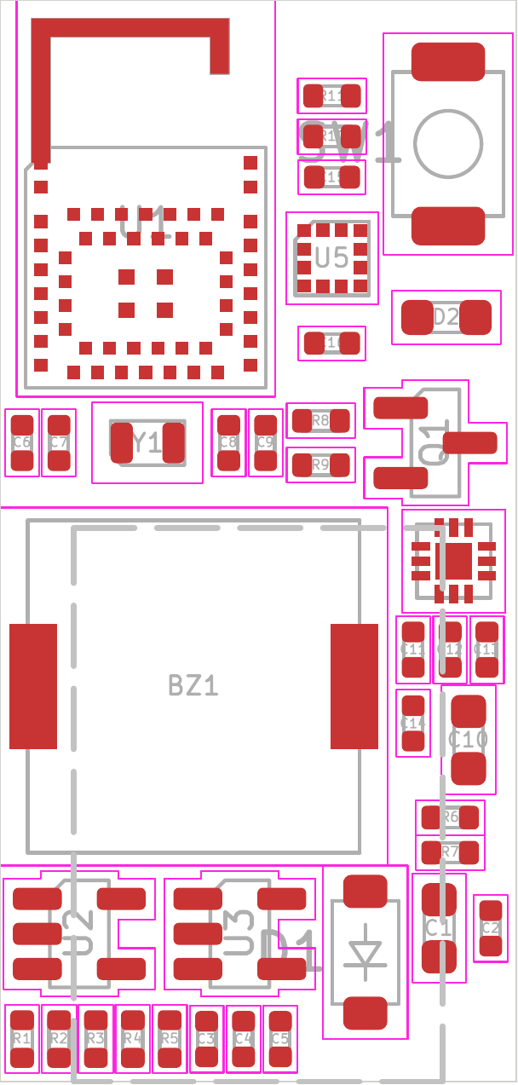
hardware/cricket-tag/floorplan/floorplan-w14s.png
