yamaha252/Cricket/hardware/cricket-tag/floorplan/floorplan-w16b-cpt1117.png

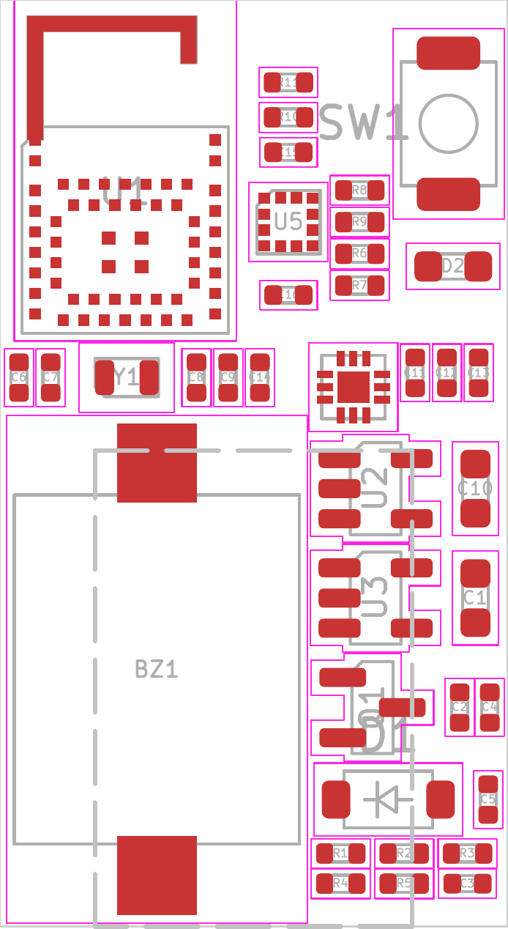
hardware/cricket-tag/floorplan/floorplan-w16b-cpt1117.png
