yamaha252/Cricket/hardware/cricket-tag/floorplan/floorplan-w18s.png

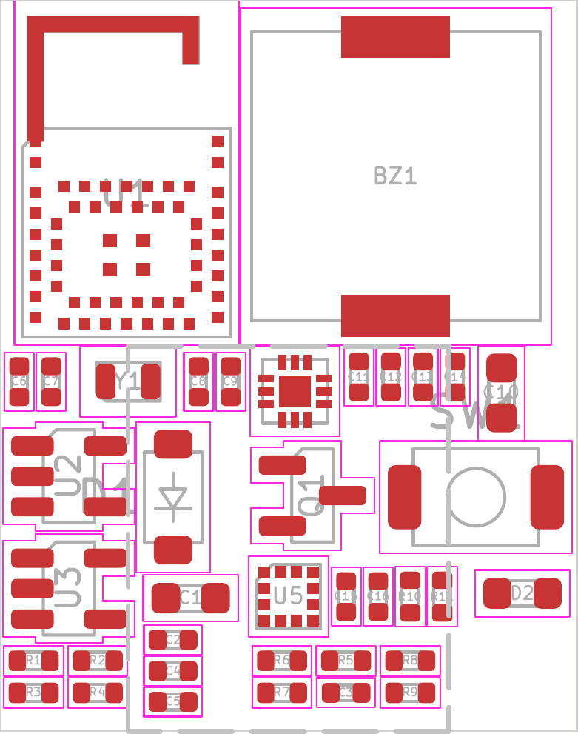
hardware/cricket-tag/floorplan/floorplan-w18s.png
