yamaha252/Cricket/hardware/cricket-tag/fab/bom-mpn.csv

Designator | Quantity | Manufacturer | Manufacturer Part Number | Description | Package | LCSC Part #
BZ1 | 1 | Same Sky | CPT-1117-83-SMT-TR | CPT-1117-83-SMT-TR | SameSky_CPT-1117-83-SMT | C22359733
C1 | 1 | Samsung Electro-Mechanics | CL10A106KP8NNNC | 10uF 10V | C_0603_1608Metric | C19702
C2,C4,C5,C11,C12,C13,C14,C16 | 8 | Samsung Electro-Mechanics | CL05A105KA5NQNC | 1uF 25V | C_0402_1005Metric | C52923
C3,C15 | 2 | Samsung Electro-Mechanics | CL05B104KO5NNNC | 100nF | C_0402_1005Metric | C1525
C10 | 1 | Samsung Electro-Mechanics | CL10A225KO8NNNC | 2,2uF 16V | C_0603_1608Metric | C23630
D1 | 1 | Changjiang Electronics Tech (CJ) | B5819W SL | B5819W | D_SOD-123 | C8598
D2 | 1 | Hubei KENTO Elec | KT-0603W | KT-0603W | LED_0603_1608Metric | C2290
Q1 | 1 | Changjiang Electronics Tech (CJ) | 2N7002 | 2N7002 | SOT-23 | C8545
R1,R4,R5 | 3 | UNI-ROYAL | 0402WGF1004TCE | 1MOhm | R_0402_1005Metric | C26083
R2 | 1 | UNI-ROYAL | 0402WGF1504TCE | 1,5MOhm | R_0402_1005Metric | C22276
R3 | 1 | UNI-ROYAL | 0402WGF2202TCE | 22kOhm | R_0402_1005Metric | C25768
R6,R7 | 2 | UNI-ROYAL | 0402WGF1001TCE | 1kOhm | R_0402_1005Metric | C11702
R8 | 1 | UNI-ROYAL | 0402WGF2200TCE | 220Ohm | R_0402_1005Metric | C25091
R9,R10,R11 | 3 | UNI-ROYAL | 0402WGF1002TCE | 10kOhm | R_0402_1005Metric | C25744
SW1 | 1 | XUNPU | TS-1088-AR02016 | TS-1088-AR02016 | SW_SPST_TS-1088-xR020 | C720477
U1 | 1 | Insight SiP | ISP2454-LX-RS | ISP2454-LX | ISP2454-LX_CornerAntenna | C44975104
U2 | 1 | TOPPOWER | TP4054-42-SOT25R | TP4054-42-SOT25R | SOT-23-5 | C32574
U3 | 1 | Texas Instruments | TPS7A0233PDBVR | TPS7A0233PDBVR | SOT-23-5 | C2887324
U4 | 1 | Diodes Incorporated | PAM8904EGPR | PAM8904EGPR | Diodes_W-QFN2020-12_2x2mm_P0.4mm_EP1.0x1.0mm | C510550
U5 | 1 | STMicroelectronics | LIS2DH12TR | LIS2DH12TR | LGA-12_2x2mm_P0.5mm | C110926
