yamaha252/Cricket/docs/cost.md

# Себестоимость производства cricket-tag

Расчёт от 2026-11-09, пересчитан 2026-11-10 по **живым расчётам JLCPCB и NextPCB** (2026-11-11 добавлены Seeed и SCSPCBA): gerber, BOM и CPL из `make_fab.sh` загружены в калькуляторы сборки. Завод для первого заказа не выбран (D-31), ниже все расчёты; сводка — в [manufacturing.md](manufacturing.md#варианты-заводов).

## Ответы заводов на расчёты 8 плат (2026-11-11)

Оба расчёта прошли проверку, ничего не оплачено.

**NextPCB** — все три позиции «Waiting for Payment», вопросов инженеров (EQ) нет; ответа на вопросы из примечаний (переходное в площадке U4, подтверждение расстановки) в карточке нет, параметры сборки в карточке не заполнены («компонентов 0», «рентген 0»). Страница оформления (открыта без оплаты):

| Статья | Сумма |
|---|---|
| Платы P-E114223ASA3, 5 панелей | 91,39 $ |
| Компоненты B-E114223AA3 (калькулятор давал 165,57 $), закупка 18 дней | 168,24 $ |
| Сборка T-E114223AA3 | 265,49 $ |
| Акция | −200,00 $ |
| Доставка SF Express до форвардера в Фошане, 3–10 дней, 0,04 кг | 3,30 $ |
| **Внутренний НДС Китая** (адрес доставки в Китае) | 42,69 $ |
| **Итого** | **371,11 $** (2472 юаня) |

Для адреса в Китае оплата только через Alipay в юанях. Есть поле для кода купона; купон SMT-Rev0 (−500 $) не применялся — неясно, не привяжется ли одноразовый купон к этому заказу. При переходе к оформлению сайт создал неоплаченный заказ.

**Seeed Fusion** — статус «Confirmed», все 20 позиций подтверждены:

| Статья | Оценка 2026-11-10 | Ответ 2026-11-11 |
|---|---|---|
| Платы, 10 шт., 0,6 мм, ENIG, 4/4 mil | 81,06 $ | 81,06 $ |
| Подготовка | 50,00 $ | 50,00 $ |
| Расходные материалы | 15,00 $ | 15,00 $ |
| Монтаж 8 плат | 108,02 $ | **203,83 $** |
| Проверка DFA | 0 $ (вместо 321 $) | 0 $ (вместо 333 $) |
| Функциональный тест 100 % | — | 0 $ (вместо 484,80 $), нужен план теста до сборки |
| Компоненты | 58,13 $ без 9 позиций | **170,81 $**: модуль U1 8 × 14,33 = 114,67 $, излучатель 27,65 $ (8 + 5 запас), LDO 8,35 $, драйвер 4,62 $, 2N7002 1,62 $, остальное < 1,5 $ |
| **Итого** | 312,21 $ | **520,70 $** (без акции 1338,50 $) |

Доставка бесплатная, срок 23 рабочих дня. С купоном −50 $ на сборку — ~470 $. Будет ли НДС при доставке в Китай, видно только при оформлении с адресом. Почему монтаж почти удвоился, не объяснено (видимо, пересчёт сложности LGA и QFN). Требования к панели и разделению Seeed не переданы.

**Сравнение за 8 плат:** NextPCB 371 $ с доставкой и НДС против ~470 $ у Seeed с купоном (без учёта возможного НДС). Модуль у обоих ~14,3 $; разница почти целиком в монтаже: 65 $ по акции у NextPCB против 204 $ у Seeed. Для 3–4 плат у NextPCB было бы примерно на 90–110 $ меньше — расчёт надо пересоздавать.

## Сколько плат собирать: минимум и оптимум (2026-11-10)

Живые расчёты NextPCB и Seeed Fusion при разном числе собранных плат: акции калькулятора учтены, отдельные купоны и доставка — нет.

| Собрано плат | NextPCB | Seeed, без позиций на проверке* | Seeed с модулем, оценка |
|---|---|---|---|
| 1 | 175,32 $ | 234,13 $ | ~251 $ |
| 2 | 193,65 $ | 239,57 $ | ~274 $ |
| 3 | 213,03 $ | — | — |
| 4 | 232,41 $ | — | — |
| 5 | 251,79 $ | 276,14 $ | ~361 $ |
| 8 | 322,45 $ | 312,21 $ (10 плат изготовлено) | ~450 $ |

\* У Seeed модуль U1 и ещё 8 мелких позиций (D1, D2, R2, R3, R6/R7, R8, R9–R11, SW1) уходят на ручную проверку и в цену не входят; модуль добавлен по оценке ~17 $ за штуку.

Из чего складывается:
- **Платы** изготавливаются минимум партией: NextPCB — 5 панелей (у панели 2 × 2 это 20 плат) за ~91 $, Seeed — 5 плат за 80,35 $ (10 плат — 81,06 $). Цену задают ENIG, класс 4/4 mil и 0,6 мм, а не размер панели: панель 1 × 2 у NextPCB — 90,05 $ против 91,39 $.
- **Постоянные расходы сборки** ~70 $ на заказ при любом количестве: NextPCB — подготовка 50 $ + материалы 20 $; Seeed — подготовка 50 $ + расходники 15 $.
- **Каждая следующая плата** у NextPCB добавляет ~19,4 $, из них модуль 14,30 $.

Минимум сборки: JLCPCB — 2 единицы (платы или панели), NextPCB — от 1 платы, Seeed — от 1 платы (проверено).

**Оптимум для нулевой ревизии — 3–4 платы.** Если ревизия не заработает, деньги за 1 и за 4 платы пропадут почти одинаково (разница ~40 $ между 2 и 4). Одна плата не позволяет отличить ошибку схемы от дефекта пайки (особенно LGA модуля); нужны замеры из [manufacturing.md](manufacturing.md#замеры-на-первых-платах), установка на дрон и запас на разрушающие испытания. Голых плат при этом придёт 20 (NextPCB) или 5–10 (Seeed).

### Купоны и акции для первого заказа

| Завод | Что есть | Условия |
|---|---|---|
| NextPCB | акция в калькуляторе | сборка от 50 $, скидка не больше 200 $; учтена в таблице выше |
| NextPCB | купон **SMT-Rev0 −500 $** | на сборку нулевой ревизии, одноразовый, от 1 $, без доставки, до 30.12.2026, лежит в аккаунте. Суммируется ли с акцией калькулятора или заменяет её — видно только при оформлении. Если обнулит сборку целиком: 1 плата ~125 $, 2 ~144 $, 4 ~182 $, 8 ~257 $ |
| NextPCB | купон −50 % на сборку | от 300 $, только для 100 шт. — не подходит |
| Seeed | −50 $ на сборку для новых клиентов или −40 $ на заказ от 300 $ | один купон на заказ, до 10.12.2026; плюс бесплатные проверка DFA (вместо 321 $), функциональный тест и экспресс-доставка при сборке |
| JLCPCB | −10, −15, −20 $ | в аккаунте |

## Тестовая партия: расчёт NextPCB 2026-11-10

Корзина NextPCB, позиции P-E114223ASA3 (плата), T-E114223AA3 (сборка), B-E114223AA3 (компоненты), статус «Under Review» — цену компонентов и детали сборки инженеры уточнят при проверке.

| Статья | Цена |
|---|---|
| Платы: 5 панелей 2 × 2 (20 плат), панель 44 × 74 мм с полями 5 мм, 2 слоя, 0,6 мм, ENIG, класс 4/4 mil, изготовление 6 дней | 91,39 $ |
| Компоненты «под ключ», все 20 позиций, с запасом на потери | 165,57 $ |
| Сборка 8 плат: подготовка 50,00 $, материалы 20,00 $, монтаж 134,82 $, операционный сбор 60,67 $ | 265,49 $ |
| **Итого без акции** | **522,45 $** |
| Акция для новых клиентов на сборку | −200,00 $ |
| **Итого с акцией** | **322,45 $** (~40 $ на плату) |

Доставка не входит: её покажет оформление после проверки; адрес — форвардер в Гуандуне (D-30). Срок 14–27 рабочих дней, включая закупку. В аккаунте ещё 2 купона («50% OFF», «$500 OFF» на баннерах), как они сочетаются с акцией — видно при оформлении. Разделение панелей заводом («Board Breakout: Yes») входит в сборку.

Цены деталей у NextPCB:

| Позиция | Цена за шт. | Срок закупки |
|---|---|---|
| U1 ISP2454-LX-RS | 14,30 $ | 7–18 рабочих дней |
| BZ1 CPT-1117-83-SMT-TR | 2,60 $ | 7–18 дней |
| U3 TPS7A0233 | 1,03 $ | 4–7 дней |
| U5 LIS2DH12 | 0,58 $ | на складе |
| U4 PAM8904E | 0,37 $ | на складе |
| U2 TP4054 | 0,14 $ | 4–7 дней |
| SW1, Q1, D1, D2, конденсаторы, резисторы | 0,001–0,05 $ | на складе; закупаются партиями 38–104 шт. |

Сравнение с JLCPCB (ниже): у JLCPCB 8 плат ~250–285 $, но сборка для Казахстана закрыта, панель только с V-cut, который этой плате не подходит ([manufacturing.md](manufacturing.md#панелизация)), а модуль надо отдельно покупать через Global Sourcing. NextPCB с акцией дороже на ~40–70 $, без неё — почти вдвое.

## Тестовая партия: расчёт JLCPCB 2026-11-10

Панель «Panel by JLCPCB» 2 × 2 с полями 18 мм (70 × 100 мм, D-30), 5 панелей = 20 плат, собираются 2 панели = 8 плат. Standard PCBA, верхняя сторона. Модуля и излучателя на складе JLCPCB нет, поэтому в этот расчёт они не вошли (их покупают отдельно, см. ниже).

| Статья | Цена |
|---|---|
| Платы: инженерный сбор 4,00 $, ENIG 17,40 $, плата 3,40 $; 2 слоя, 0,6 мм, изготовление 24 ч без доплаты | 24,80 $ |
| Подготовка производства (setup) | 25,75 $ |
| Трафарет | 8,27 $ |
| Компоненты со склада JLCPCB, 18 позиций с запасом на потери | 24,83 $ |
| Загрузка катушек, 18 позиций (≈1,55 $ за позицию) | 27,90 $ |
| Пайка | 1,81 $ |
| Проверка расстановки инженерами (Confirm Parts Placement) | 0,45 $ |
| Оснастка для сборки (PCB assembly fixture) | 16,54 $ |
| Рентген (корпуса LGA и QFN) | 13,20 $ |
| Упаковка | 0,50 $ |
| **Итого без модуля и излучателя** | **144,05 $** |
| Доставка SF Express по Гуандуну (до форвардера, D-30) | 2,07 $ |

Сборка 3–4 дня, за 2–3 дня — плюс 49,63 $. Вес посылки 0,35 кг. В корзине автоматически применился купон −10 $. Оснастку и рентген прежняя оценка не учитывала: это ~30 $ на заказ сверх тарифов.

### Модуль и излучатель

Покупаются заранее через Global Sourcing и выбираются в BOM из своего склада (как это работает — [manufacturing.md](manufacturing.md#global-sourcing)).

| Деталь | Источник | Цена | На 8 плат |
|---|---|---|---|
| ISP2454-LX-JT (лоток) | Mouser через Global Sourcing, MOQ 3, склад 761 | 9,82 $ | 78,57 $ (10 шт. — 98,22 $) |
| ISP2454-LX-JT | CoreStaff | 9,19 $ от 5 шт. | 73,50 $ |
| ISP2454-LX-RS (отрезок ленты) | DigiKey, склад 1 188 | 13,49 $, от 10 шт. 11,36 $ | 10 шт. — 113,64 $ |
| ISP2454-LX-RS | Mouser | 20,40 $ | — |
| ISP2454-LX-RS, C44975104 | предзаказ JLCPCB, склад 0 | 20,62 $, от 200 шт. 8,23 $ | 164,96 $ |
| CPT-1117-83-SMT-TR (отрезок ленты) | DigiKey, склад 18 319 | 2,51 $, от 10 шт. 1,90 $ + сбор 10 % | 10 шт. — 20,91 $ |
| CPT-1117-83-SMT-TR | склад JLCPCB, 1 шт. | 2,87 $ | — |

Цены -JT и -ST в каталоге JLCPCB (0,04 $) — заглушка, склада нет. Ставит ли JLCPCB модули из лотка, перед покупкой уточнить у поддержки; для -JT в BOM поменять номер модуля.

### Итого за 8 собранных плат

| Модуль | Всего | На плату |
|---|---|---|
| -JT у Mouser, 8 шт. | **~250 $** | ~31 $ |
| -RS у DigiKey, 10 шт. | ~285 $ | ~36 $ |
| Предзаказ JLCPCB (и излучатель со склада JLCPCB) | ~340 $ | ~42 $ |

В итог входят 144,05 $ расчёта, модуль, излучатель (20,91 $), загрузка ещё двух катушек и ручная обработка деталей Global Sourcing (~5 $), доставка 2,07 $. Не входят: купоны (в аккаунте −10, −15 и −20 $), пошлина на модуль 3–30 % (до ~24 $ для -JT), услуги форвардера. Сроки: Global Sourcing 8–20 рабочих дней до склада JLCPCB, потом изготовление и сборка ~4–5 дней.

## Тестовая партия: расчёт SCSPCBA 2026-11-11

SCSPCBA (Шэньчжэнь) — единственный из заводов в обзорах 2026 года, кроме уже посчитанных, с онлайн-расчётом сборки и автоподбором деталей по BOM. Загружены `cricket-tag-gerbers.zip` и `bom-mpn.csv`, позже в корзине — `cpl-kicad.csv`. Gerber сайт не разобрал («File parsing failed»), параметры платы введены вручную. Нужен аккаунт: без входа цены деталей и сборки скрыты.

Параметры: «Panel by SCSPCBA» 2 × 2, поля 5 мм со всех сторон, зазор 2 мм, панель 76 × 46 мм; 1 панель = 4 платы (голых запасных нет); 0,6 мм, ENIG 1 µ", 4/4 mil, отверстие 0,3 мм, X-out не принимается; сборка одной стороны, «Depanel the boards to delivery: YES», фото первой платы. В примечаниях к плате и к сборке (англ.): фрезеровка с mouse bites вместо V-cut и разделение заводом, перемычки подальше от SW1, D2 и антенны; закупка 7 неподобранных позиций строго по MPN (U1 -RS или -JT), замены допустимы только у пассивов; рентген U1, U4, U5; переходные в площадке U4 закрыты маской — спросить, нужна ли заливка.

| Статья | Цена |
|---|---|
| Платы, 1 панель (4 шт.) | 48,96 $ |
| Компоненты, подобраны 13 из 20 позиций | 24,14 $ |
| Сборка: 4 × 1,40 $, трафарет 18,46 $, инженерный сбор ~127 $ | 150,98 $ |
| Скидка: инженерный сбор отменяется при закупке деталей заводом (126,92 $), скидка за объём (18,16 $) | −145,08 $ |
| **Итого без 7 позиций и доставки** | **79,00 $** |

Автоподбор не нашёл (цена 0, «оценят после отправки заказа или через поддержку»): U1 ISP2454-LX-RS, U3 TPS7A0233, U4 PAM8904E, C10, D1, D2, Q1. Если модуль будет ~14,3 $, как у NextPCB и Seeed, плюс ~1,5 $ остальных позиций на плату, 4 платы выйдут **~140–145 $** без доставки и НДС — дешевле NextPCB (232 $ за 4 платы по калькулятору). Это оценка, цену даст инженер.

При 4 панелях (16 плат, все собраны) было 121,98 $ без тех же позиций; строки BOM считаются на все платы заказа, отдельно задать число собираемых плат нельзя.

Расчёт SCS261112-1000-A отправлен на проверку 2026-11-11 (статус «Pending Review», срок по сайту 12 дней, менеджер назначен). При отправке нужны адрес доставки и платёжный адрес (указан форвардер в Гуандуне, платёжный — тот же, его можно поменять до оплаты) и код подтверждения почты; доставка только UPS, DHL или FedEx, выбран UPS, стоимость «Labor Required Pricing» — после проверки. Открыт ли завод для Казахстана и будет ли НДС при доставке в Китай — не проверено.

### После проверки инженером (2026-11-12)

Статус «To Be Paid», срок 14 дней. Все 20 позиций BOM подобраны («Effective», закупает SCSPCBA). Детали те же, что в BOM, по MPN, без замен: U1 ISP2454-LX-RS (Insight SiP), U3 TPS7A0233PDBVR (TI), U4 PAM8904EGPR (Diodes), C10 CL10A225KO8NNNC, D2 KT-0603W. Цены 7 позиций, которые не нашёл автоподбор, инженер поставил сам по курсу 6,5 юаня за доллар. Все три файла (BOM, gerber, CPL) приняты.

| Статья | Цена |
|---|---|
| Платы, 1 панель: 4 × 3,94 $, подготовка 28,56 $, тест 4,64 $ | 48,96 $ |
| Сборка: 4 × 1,62 $, трафарет 18,46 $, инженерный сбор 126,92 $ | 151,88 $ |
| Компоненты на 4 платы: детали 80,77 $ + сбор за закупку 21,81 $ (27 %) | 102,58 $ |
| Скидка | −146,67 $ |
| Доставка UPS до форвардера | 3,08 $ |
| **Итого к оплате** | **159,83 $** (~40 $ за плату) |

Самые дорогие детали на 4 платы: модуль 53,40 $ (13,35 $ за штуку), излучатель 12,11 $, U3 4,28 $, U5 3,82 $, U4 1,83 $; остальные 15 строк — 5,33 $. НДС не начислен. Это дешевле NextPCB за 4 платы (232,41 $) и Seeed за 1–2 (~250–275 $).

В расчёте инженер зачеркнул «Bare Board Testing: Flying Probe Fully Test» (выделено красным, теперь «-»), а строка «Test Cost 4,64 $» осталась. В карточке заказа не видно ни способа разделения панели (mouse bites, не V-cut), ни рентгена LGA и QFN: оба требования были только в примечаниях. Примечаний в карточке заказа тоже нет, поэтому неясно, видел ли их инженер. Перед оплатой спросить у менеджера: будет ли электротест голых плат, режут ли панель фрезой с mouse bites, делают ли рентген U1, U4, U5. Попросить чертёж панели на согласование: где перемычки (не у SW1, D2 и антенного конца U1, ведь медь в 0,2–0,4 мм от края) и есть ли реперы на полях (на самих платах реперов нет). Повороты в `cpl-kicad.csv` — как в KiCad, без поправок JLCPCB, проверить по фото первой платы («First Piece Confirmed: Take a picture»). Ничего не оплачено.

## Серия: оценка по тарифам и ценам 2026-11-10

Панель 4 × 3 = 12 плат. Платы — по калькулятору JLCPCB для старой панели 98 × 49 мм (с платой 17 × 32 мм панель около 78 × 106 мм, цена почти та же). Постоянные статьи — из расчёта тестовой партии; оснастка и рентген могут зависеть от тиража, уточнить расчётом.

### Компоненты на одну плату

| Позиция | 10–99 шт | от 100 шт |
|---|---|---|
| Модуль ISP2454-LX: -JT у Mouser / -RS отрезком у DigiKey | 9,82 / 11,36 $ | 9,82 / 11,36 $ |
| Излучатель CPT-1117-83 (DigiKey от 10 / RS от 100, +10 %) | 2,09 $ | 1,83 $ |
| LDO, акселерометр, драйвер, TP4054 | 2,22 $ | 1,79 $ |
| Basic: светодиод, ключ, кнопка, диод, ~23 пассива | 0,16 $ | 0,13 $ |
| **Итого, -JT / -RS** | **14,29 / 15,83 $** | **13,57 / 15,11 $** |

Модуль — две трети стоимости компонентов. Ступени цены у модуля начинаются с 200 шт. (предзаказ JLCPCB 8,23 $) и 500 шт. (катушка -RS у DigiKey 8,76 $).

### Итог по тиражам

| Статья | 24 шт (2 панели) | 60 шт (5 панелей) | 120 шт (10 панелей) |
|---|---|---|---|
| Платы | 23,50 $ | 23,50 $ | 26,40 $ |
| Подготовка и трафарет | 34,02 $ | 34,02 $ | 34,02 $ |
| Оснастка и рентген | 29,74 $ | 29,74 $ | 29,74 $ |
| Загрузка катушек, 20 позиций | 31,00 $ | 31,00 $ | 31,00 $ |
| Пайка | 6,22 $ | 15,55 $ | 31,10 $ |
| Ручная обработка Global Sourcing | 4,80 $ | 12,00 $ | 24,00 $ |
| Компоненты (+2 % на запас), -JT / -RS | 350 / 388 $ | 875 / 969 $ | 1 661 / 1 850 $ |
| Доставка до форвардера | ~3 $ | ~3 $ | ~5 $ |
| **Всего, -JT / -RS** | **~482 / ~520 $** | **~1 023 / ~1 118 $** | **~1 842 / ~2 031 $** |
| **На одну собранную плату, -JT / -RS** | **~20,1 / ~21,7 $** | **~17,1 / ~18,6 $** | **~15,3 / ~16,9 $** |

Минимум для сборки на JLCPCB — 2 единицы (платы или панели), поэтому самая маленькая серийная партия — 2 панели по 12 штук. При 5 заказанных панелях 3 остаются несобранными.

До расчёта JLCPCB (2026-11-09) оценка была ~15,2 / ~20,9 $ за плату при 24 шт. и ~10,6 / ~16,5 $ при 120 шт.: в ней не было оснастки и рентгена, а лоток считался по 5,9 $ (цена магазина Insight SiP, через Global Sourcing её нет).

### Сбор 20 $ за проверку и пошлина

- **Сбор 20 $** по справке JLCPCB берётся за детали из Global Sourcing, которым нужна проверка и сертификация 3C: переключатели, предохранители, газовые разрядники, **разъёмы**, аккумуляторы. Модуль и излучатель в этот список не входят, разъёмов на плате нет (D-26). Если JLCPCB его всё же выставит, это +20 $ на заказ.
- **Пошлина 3–30 %** по той же справке может взиматься за модули, реле, фильтры и кабели из Global Sourcing. ISP2454-LX — модуль. Точная сумма видна при оформлении.

## Помимо платы, на один маячок

| Что | Цена |
|---|---|
| Li-Po 1S 40–50 мА·ч с защитой, с выводами | ~2–4 $ |
| 4 провода ~30 AWG по 10 см | ~0,1–0,3 $ |
| Термоусадка | ~0,05 $ |
| **Готовый маячок, партия 60 шт** | **~20–23 $** |

## Разово на инструменты

| Что | Цена |
|---|---|
| Подпружиненные контакты или зажим 4 × 2,54 мм под площадки SWD | ~2–5 $ |
| Программатор: J-Link EDU Mini или CMSIS-DAP / probe-rs | ~10–60 $ |

## Что не учтено и может изменить цену

- **Форвардер.** Доставка JLCPCB до склада в Гуандуне ~2 $; пересылка дальше и таможня — по тарифам форвардера.
- **Пошлина на модуль** 3–30 %.
- **Economic недоступен.** В калькуляторе для нашей платы выбирается только Standard, поэтому постоянные расходы ~94 $ на заказ (подготовка, трафарет, оснастка, рентген, катушки).
- **JLCONE.** В настольном приложении JLCPCB платы дешевле на 1–20 $ за заказ (в калькуляторе показана «Desktop Price»: 2,10 $ против 4,10 $ у веба для голой платы).
- **Купоны JLCPCB** −10…−20 $.

## Вариант с модулем Ebyte (отклонён, D-19)

С модулем Ebyte E73-2G4M08S1F со склада JLCPCB заказ идёт по тарифу Economic: ~15,3 $/шт. при 20 шт., ~12,7 $ при 50, ~10,9 $ при 120, сборка без ожидания закупки. Плата длиннее, маячок тяжелее ~на 0,9 г. Сравнение в [module-options.md](module-options.md).

## Как снизить цену

1. Модуль. -JT у Mouser (9,82 $) дешевле -RS отрезком (11,36–13,49 $); от 200 шт. — предзаказ JLCPCB по 8,23 $, от 500 — катушка -RS у DigiKey по 8,76 $. Магазин Insight SiP продаёт по 5,09–5,40 $, но через Global Sourcing его нет, а свои детали владелец не присылает. Голый nRF54L10 со склада JLCPCB стоит около 3,8 $ и уберёт Global Sourcing, но требует 4 слоёв и настройки антенны (ревизия B).
2. Излучатель CPT-1117-83 через Global Sourcing ~1,8–2,1 $; запасной CPT-9019A со склада LCSC — 1,34 $ от 100 шт.
3. Тираж: при переходе от 24 к 120 штукам цена падает с ~20 $ до ~15 $ за плату (-JT).
4. Оснастка 16,54 $ — возможно, из-за толщины 0,6 мм; стоит сравнить расчёт с 0,8 мм, если масса позволит.

## Источники

- Расчёт в калькуляторе [JLCPCB](https://cart.jlcpcb.com/quote) и поиск Global Sourcing в личном кабинете, 2026-11-10
- [Тарифы сборки JLCPCB](https://jlcpcb.com/solutions/pcb-prototype-assembly), [FAQ по сборке](https://jlcpcb.com/help/article/pcb-assembly-faqs)
- [Условия Global Sourcing](https://jlcpcb.com/help/article/global-sourcing-parts-order-terms-conditions)
- Цены компонентов — в [components.md](components.md)
