yamaha252/Cricket/docs/components.md

# Компоненты cricket-tag, ревизия A

Наличие и цены проверены 2026-11-09 (радиомодуль — 2026-11-10) в каталогах LCSC, JLCPCB и Octopart. Перед заказом проверить снова. Все позиции должны ставиться заводом JLCPCB, см. [manufacturing.md](manufacturing.md).

Схема готова, и заводской BOM собирается из полей `LCSC Part` её символов. Эта таблица объясняет выбор и расчёт номиналов; при замене компонента обновить схему (`gen_schematic.py`), эту таблицу и [decisions.md](decisions.md).

## Радиомодуль: Insight SiP ISP2454-LX

Решение D-29 в [decisions.md](decisions.md). Данные по datasheet isp_ble_DS2454 R7 и datasheet nRF54L15; сравнение с другими модулями — [module-options.md](module-options.md).

| Параметр | Значение |
|---|---|
| Чип | Nordic nRF54L15 (Cortex-M33 128 МГц, 1,5 МБ RRAM, 256 КБ ОЗУ) |
| Размер | 8 × 8 × 1 мм, LGA-62 (48 площадок 0,4 мм с шагом 0,65 мм, 4 угловые GND 0,8 мм, 14 механических) |
| Антенна | встроенная чип-антенна, усиление 0,6 dBi, EIRP до 8,6 dBm; вывод OUT_MOD позволяет внешнюю антенну |
| Мощность | +8 dBm |
| Чувствительность | 1M −96 дБм, Coded 125 кбит/с −104 дБм (по чипу) |
| Питание | 1,7–3,6 В, номинал 3,3 В; DC/DC и развязка (11,2 мкФ) внутри |
| Ток | System OFF 0,6 мкА, System ON с 64 КБ ОЗУ и LFXO 1,5 мкА, TX 0 dBm 3,7 мА, RX 3,3 мА |
| Кварцы | 32 МГц и 32,768 кГц внутри (вариант LX); для 32,768 кГц производитель рекомендует внутреннюю нагрузочную ёмкость 19 пФ (разд. 2.5), но SDK допускает не больше 18 пФ — в прошивке 18 пФ, см. [firmware/README.md](../firmware/README.md) |
| Дальность по datasheet | 60 м в открытом поле на 1M при высоте 1 м (разд. 2.6). Это ниже ориентира D-17 (150–250 м на 1M), который взят из примеров u-blox; D-17 не пересмотрен, проверяется замером на первых платах |
| Влагочувствительность | MSL 2 в таблице предельных значений, MSL-3 в разд. 7.2 — считать MSL 3 |
| Сертификация | CE, FCC, IC, TELEC у модуля |
| Наличие 2026-11-10 | Mouser: ISP2454-LX-RS 1 397 шт. (лента), ISP2454-LX-JT 761–838 шт. (лоток); DigiKey: -RS 1 188 шт. отрезками, 1 258 катушками. На складе JLCPCB 0, предзаказ C44975104 |
| Цена | Через JLCPCB Global Sourcing 2026-11-10: -JT у Mouser 9,82 $, -RS отрезком у DigiKey 13,49 $ (от 10 шт. 11,36 $), -RS у Mouser 20,40 $; предзаказ JLCPCB C44975104 20,62 $ (от 200 шт. 8,23 $). Магазин Insight SiP 5,09–5,40 $ (через Global Sourcing недоступен). См. [cost.md](cost.md#модуль-и-излучатель) |
| Закупка | Зависит от завода (не выбран, D-31): NextPCB закупает сам, -RS по 14,30 $, срок 7–18 рабочих дней; для JLCPCB — заранее через Global Sourcing (D-30): -JT у Mouser или -RS у DigiKey |

### Требования к встроенной антенне

По datasheet, раздел 4.3: модуль в углу платы антенной половиной к торцу.

| Элемент | Значение |
|---|---|
| Положение модуля | в 1 мм от торцевой кромки; от боковой — 1,3 мм (datasheet: 1 мм; ещё 0,3 мм под дорожки VDD, SWDIO, SWDCLK вдоль кромки) |
| Без меди, дорожек и via, все слои | от границы антенной половины модуля (4 мм от торца корпуса) до торцевой кромки; вбок — 5 мм от корпуса внутрь платы и до боковой кромки. На плате 17 мм это полоса 14 × 5 мм у торца. Механические площадки 49–62 под антенной половиной — паяются, без цепей |
| Земля | у производителя симуляция на «земле» 18 × 30 мм — почти наша плата |

Зона запрета и курятник до кромки заложены в футпринт `cricket:ISP2454-LX_CornerAntenna` (`hardware/cricket-tag/lib/gen_isp2454.py`). Вариант для торца 10 мм — `ISP2454-LX_NarrowEnd`.

Выводы. Между наружными площадками 0,25 мм: дорожка между ними не проходит, сигналы берутся с наружного ряда (12 GPIO, VDD, SWDIO, SWDCLK, угловые GND). Исключения: UART_RX с внутренней площадки 29 через закрытое маской переходное под модулем; внутренние GND 8 и 21, 23, 24 соединены дорожками с угловыми 7 и 25; центральные GND 12–18 не подключены — производитель для неполного набора выводов рекомендует только наружные площадки (разд. 4.2). Карта выводов — в README платы.

Отличия от производителя: стек 0,6 мм и 2 слоя; настройка антенны проверяется замером дальности на первых платах.

### Рассмотренные и отклонённые модули

| Модуль | Размер | Почему нет |
|---|---|---|
| u-blox ANNA-B402-00B (nRF52833) | 6,5 × 6,5 мм + противовес | стоял до D-29: тот же размер платы, но ток выше (TX 0 dBm 6,0 мА, сон 2,6 мкА) и памяти втрое меньше; нужен внешний кварц |
| KAGA FEI ES4L15BA1 (nRF54L15) | 3,25 × 8,55 мм | мало наружных GPIO, нужен внешний дроссель и кварц, у JLCPCB только как деталь заказчика |
| Ezurio BL54L15µ 453-00223 (nRF54L15) | 6,3 × 7,9 мм | 0 у авторизованных дистрибьюторов (Mouser 2026-11-10: в заказе) |
| Raytac AN54LV-15 (nRF54L15) | 8,4 × 6,4 мм | только маркетплейс и брокеры, нужна отправка на завод |
| Fanstel BM15C (nRF54L15) | 10 × 15,8 мм | крупный, плата 13 × 30 мм |
| HJSIP HJ-N54L-SIP (nRF54L15) | 4,5 × 4,5 мм | только DigiKey Marketplace |
| Minew ME54BS01/ME54BS12 | 12 × 15,8 мм и больше | крупные, на JLCPCB 0 |
| Голый nRF54L10-QFAA (склад JLCPCB 247) | QFN48 6 × 6 | 4 слоя, настройка антенны. Кандидат для ревизии B |

## Перечень

| Узел | Компонент | Корпус | LCSC | Тип JLCPCB | Наличие LCSC | Цена 1 шт | Примечание |
|---|---|---|---|---|---|---|---|
| Радио | Insight SiP ISP2454-LX-RS | LGA-62 8 × 8 мм | C44975104 (предзаказ) | NextPCB «под ключ» или Global Sourcing для JLCPCB (D-30, D-31) | 0, Mouser 1 397 (-RS) + 761 (-JT), DigiKey 1 188 (-RS) | 9,82 $ (-JT, Mouser) … 13,49 $ (-RS, DigiKey) | Решение D-29. Кварцы и развязка внутри |
| Зарядка | TOPPOWER TP4054-42-SOT25R | SOT-23-5 | C32574 | Extended | 74 025 | 0,13 $ | Оригинальный производитель TP4054. Запас: JSMSEMI TP4054 C5381776, 332 597 шт. |
| LDO 3,3 В | TI TPS7A0233PDBVR | SOT-23-5 | C2887324 | Extended | 2 354 | 1,15 $ | Iq 25 нА. Решение D-14 |
| Драйвер бипера | Diodes PAM8904EGPR | W-QFN2020-12 | C510550 | Extended | 8 794 | 0,49 $ | До 27 В размаха |
| Бипер | Same Sky CPT-1117-83-SMT-TR | SMD 11 × 9 × 1,7 мм, с лепестками 15 × 9, площадки 15,5 × 9 мм | C22359733 (на складе 1 шт.) | NextPCB «под ключ», 2,60 $, или Global Sourcing для JLCPCB (D-30, D-31) | 1, DigiKey 18 319, Arrow 1 383 | 2,51 $ у DigiKey, от 10 шт. 1,90 $ + 10 %; 2,87 $ на складе JLCPCB | 83 дБ мин. при 5 В размаха, по графику 85–92 дБ в полосе 3–8 кГц, предел 25 В, 4,1 кГц, 0,2 г. Решение D-27. Запасной — CPT-9019A (C20181991, склад LCSC) |
| Акселерометр | ST LIS2DH12TR | LGA-12 2 × 2 мм | C110926 | Extended | 35 746 | 0,93 $ | Ожидание 0,5 мкА |
| Светодиод | Hubei KENTO KT-0603W, белый | 0603 | C2290 | **Basic** | 2 041 446 | 0,01 $ | 2,6–3,1 В, 360 мкд при 5 мА. Питание от VBAT через ключ |
| Ключ светодиода | CJ 2N7002 | SOT-23 | C8545 | **Basic** | 5 917 486 | 0,02 $ | |
| Кнопка | XUNPU TS-1088-AR02016 | SMD 4 × 3 × 2 мм | C720477 | **Basic** | 730 325 | 0,05 $ | Нажатие сверху |
| Пассивы и диод | резисторы, конденсаторы, Шоттки | 0402/0603/SOD-123 | см. таблицу номиналов ниже | **Basic** | | | |
| Провода полётника и аккумулятора | площадки J1 (4 шт.) и J2 (2 шт.) 1,2 × 2,0 мм, шаг 2 мм, снизу | только медь | — | — | | | Пайка руками, D-26. Разъёмы JST SH убраны |
| SWD | площадки J3: 4 круглые 1,2 мм, шаг 2,54 мм, снизу | только медь | — | — | | | VDD, SWDIO, SWCLK, GND. D-26 |

В тарифе Economic позиции Extended добавляют разовую плату за загрузку катушки, Basic — нет. В Standard PCBA, который нужен нам из-за Global Sourcing, плата 1,53 $ берётся за каждую позицию, включая Basic; так и посчитано в [cost.md](cost.md).

### Номиналы и пассивы (все Basic, проверено 2026-11-09)

| Где | Номинал | Корпус | LCSC | Расчёт |
|---|---|---|---|---|
| TP4054 PROG | 22 кОм | 0402 | C25768 | ток заряда 1000 В / 22 кОм ≈ 45 мА: не больше 1C для 40–60 мА·ч. Прежние 100 мА слишком много |
| Вход 5 В | Шоттки B5819W SL | SOD-123 | C8598 | 1 А, 40 В |
| Вход 5 В, TP4054 VCC | 10 мкФ 10 В | 0603 | C19702 | |
| TP4054 BAT, LDO вход и выход | 1 мкФ 25 В | 0402 | C52923 | |
| VIN_SENSE | 1 МОм (верх) + 1,5 МОм (низ) | 0402 | C26083, C22276 (Extended) | 5 В ±5 % → 2,85–3,15 В на GPIO: выше порога 0,7 · VDD = 2,31 В и не выше VDD + 0,3 В. Ток ~2 мкА только при наличии 5 В. Решение D-23 |
| Делитель VBAT | 2 × 1 МОм + 100 нФ | 0402 | C26083, C1525 | VBAT/2 ≤ 2,1 В на АЦП, постоянный ток ~2 мкА |
| UART | 2 × 1 кОм | 0402 | C11702 | защита выводов |
| Светодиод | 220 Ом | 0402 | C25091 | (4,2 − 2,9) В / 220 Ом ≈ 6 мА |
| Затвор 2N7002 | 10 кОм на землю | 0402 | C25744 | светодиод выключен при сбросе |
| PAM8904E CIN | 2,2 мкФ 16 В | 0603 | C23630 | по схеме включения Diodes |
| PAM8904E C1, C2 | 1 мкФ 25 В | 0402 | C52923 | |
| PAM8904E COUT | 2 × 1 мкФ 25 В | 0402 | C52923 | на выходе до 12,6 В; 25 В вместо 16 В из-за потери ёмкости под напряжением. В типовой схеме Diodes COUT 2,2 мкФ; у 0402 под 12 В остаётся меньше половины номинала. Нагрузка — 13 нФ, пульсации малы; если на первых платах VOUT просядет, заменить на 2,2 мкФ 25 В 0603 |
| LIS2DH12 развязка | 100 нФ + 1 мкФ | 0402 | C1525, C52923 | по datasheet. У ISP2454-LX своя развязка внутри (11,2 мкФ); вместе с C5 1 мкФ на выходе TPS7A0233 — 12,2 мкФ, в пределах 1–22 мкФ по datasheet LDO |
| I2C LIS2DH12 | 2 × 10 кОм | 0402 | C25744 | |

Режимы PAM8904E: 3x от аккумулятора даёт на выходе около 9,5 В при 3,7 В и до 12,6 В при 4,2 В; в дифференциальном включении размах на излучателе около 19–25 В, что укладывается в предел CPT-1117-83 (25 В). Ток в этом режиме около 14 мА, в выключенном состоянии 0,008 мкА. Питать PAM8904E выше 4,5 В в режиме 3x нельзя: при 4,2 В на полностью заряженном аккумуляторе запас есть.

TP4054 (datasheet TOPPOWER): утечка из аккумулятора при отсутствии 5 В — 1 мкА типично, 2 мкА максимум. В режиме ожидания после окончания заряда вывод CHRG тянется вниз слабым током ~20 мкА.

## Излучатели: сравнение по datasheet

Все кандидаты — пассивные пьезоизлучатели в SMD-корпусе, раскачиваются драйвером PAM8904E. Данные из datasheet производителей, наличие и цены LCSC на 2026-11-09.

### Паспортные данные

| Излучатель | LCSC | Размер, мм | Масса | Громкость на 10 см по datasheet | Предел | Ёмкость | Частота | Температура | Наличие | Цена |
|---|---|---|---|---|---|---|---|---|---|---|
| Same Sky CPT-12123-81 (запасной) | C3812179 | 12 × 12 × 3,0 | 0,5 г | 81 дБ тип. при 5 В разм. | 25 В разм. | 16 нФ | 4,0 кГц | −40…+120 °C | 226 + Mouser 1 483 | 2,49 $ |
| **Same Sky CPT-1117-83** (выбран, D-27) | C22359733 | 11 × 9 × 1,7; с лепестками 15 × 9, площадки 15,5 × 9 | 0,2 г | 83 дБ **мин.** при 5 В разм.; по графику ~87–90 дБ на 3,4–4,6 кГц | 25 В разм. | 13 нФ | 4,1 кГц | −40…+85 °C | 1 + Arrow 1 383 | 1,51 $ |
| KELIKING KLJ-1230 | C201042 | 12 × 12 × 3,0 | 0,35 г | 80 дБ мин. при 3 В разм. | **20 В разм.** | 16 нФ | 4,0–4,1 кГц | **−20…+70 °C** | 6 781 | 0,66 $ |
| INGHAi GSC1230YB-3V4000 | C255333 | 12 × 12 × 3,0, звук сбоку | — | 75 дБ мин. при 3 В разм. | 25 В разм. | 16 нФ | 4,0 кГц | **−20…+60 °C** | 319 | 1,14 $ |
| Murata PKLCS1212E40A1 (снят) | C441747 | 12 × 12 × 3,0 | 0,36 г | 75 дБ мин. при 3 В разм., на плате 10 × 10 см | 25 В разм. | — | 4,0 кГц | −40…+85 °C | 71, EOL | 1,54 $ |
| Same Sky CPT-9019A (запасной, D-25 → D-27) | C20181991 | 9 × 9 × 1,9; площадки 10 × 9 | 0,2 г | 75 дБ тип. (72 мин.) при 3 В разм.; по графику ~75 дБ на 4 кГц, узкий пик ~84 дБ на ~6 кГц | 25 В разм. | 12 нФ | 4,0 кГц | −40…+85 °C | 230 | 2,04 $ |
| FUET-1325 | C391038 | 13 × 13 × 2,5 | 0,5 г | 75 дБ мин. при 5 В разм. | 25 В разм. | 16 нФ | 4,0 кГц | **−20…+70 °C** | 1 244 | 0,53 $ |
| FUET-1109 | C391036 | 11 × 9 × 1,7 | 0,3 г | 70 дБ мин. при 5 В разм. | 25 В разм. | 12 нФ | 4,1 кГц | **−20…+70 °C** | 1 698 | 0,51 $ |

### Приведение к одним условиям

Производители меряют при разном напряжении: одни при 3 В размаха, другие при 5 В. Same Sky указывает типичное значение, китайские производители и Murata — минимум, то есть реальный экземпляр обычно громче. Для пьезоизлучателя громкость растёт примерно на 20 · lg(U₂/U₁) дБ с напряжением, пока он не начинает насыщаться.

| Излучатель | При 5 В размаха | При ~19 В от PAM8904E (теория) | Тип значения |
|---|---|---|---|
| KLJ-1230 | ~84 дБ | ~96 дБ, но предел 20 В | минимум |
| **CPT-1117-83** (выбран, D-27) | **≥83 дБ (по графику ~88 дБ)** | **~95–100 дБ** | **минимум** |
| CPT-9019A (запасной) | ~79 дБ на 4 кГц, ~88 дБ на 6 кГц | ~91–100 дБ | типичное |
| CPT-12123-81 | 81 дБ | ~93 дБ | типичное |
| GSC1230YB, Murata, CPT-9019A | ~79 дБ | ~91 дБ | минимум / типичное |
| FUET-1325 | 75 дБ | ~87 дБ | минимум |
| FUET-1109 | 70 дБ | ~82 дБ | минимум |

Проверено по datasheet 2026-11-10: у CPT-1117-83 83 дБ стоят в колонке «min», а не «typ», как было записано раньше. Частотные кривые обоих datasheet (условия на графиках не указаны, вероятно номинальное напряжение и 10 см): CPT-9019A на 4,0 кГц даёт ~75 дБ, а на ~6 кГц — узкий пик ~84 дБ; CPT-1117-83 держит 85–92 дБ широкой полосой от 3 до 8 кГц. Частоту задаёт прошивка через DIN (PAM8904E принимает 20 Гц…300 кГц), поэтому сравнивать нужно на лучшей частоте каждого. Приведено к 5 В размаха: на 4 кГц CPT-1117-83 громче на ~9 дБ; каждый на своей лучшей частоте — на ~2–4 дБ (CPT-9019A ~88 дБ на 6 кГц против ~90 дБ у CPT-1117-83 на 3,4–4,6 кГц). Ухо на 6 кГц чуть менее чувствительно, чем на 3–4 кГц, а трава и воздух сильнее гасят высокие частоты.

Значения при 19 В — теоретический потолок. На практике излучатель насыщается и даёт меньше, это проверяется замером. Для сравнения с готовыми пищалками: на 20 см громкость на ~6 дБ ниже, чем на 10 см.

### Выводы

- **CPT-9019A — был выбран в D-25, заменён D-27, запасной**: самое маленькое посадочное место (10 × 9 мм), 0,2 г, есть на складе LCSC (243 шт. на 2026-11-10). На 4 кГц тише CPT-1117-83 примерно на 9 дБ, на своей лучшей частоте (~6 кГц, узкий пик) — на 2–4 дБ.
- **CPT-12123-81** — был запасным для CPT-1117-83: типичные 81 дБ при 5 В, предел 25 В полностью покрывает размах PAM8904E, самый широкий диапазон температур (до −40 °C, важно зимой), понятный datasheet. Минус — самый тяжёлый (0,5 г) и самый дорогой.
- **CPT-1117-83 — выбран (D-20, затем D-27)**. По паспорту лучший по сумме параметров: громче всех кандидатов Same Sky широкой полосой 3–8 кГц, 0,2 г, 1,7 мм высоты. С лепестками излучатель 15 мм длиной: встаёт под модулем на плате 17 мм шириной (D-27, D-28). Минус — на LCSC почти нет, только через Global Sourcing у Arrow. Сборка у нас и так Standard с Global Sourcing, поэтому это вторая позиция из Global Sourcing, а не смена тарифа.
- **KLJ-1230** — на бумаге самый громкий и дешёвый, много на складе. Но предел 20 В размаха меньше, чем даёт PAM8904E на полном аккумуляторе (до 25 В), и рабочая температура только от −20 °C. Подходит при ограничении режима драйвера до 2x или после проверки на морозе.
- **GSC1230YB** — интересен боковым выходом звука (удобно под термоусадкой), но тише и работает только до −20 °C.
- FUET-1325 и FUET-1109 заметно тише, Murata снят с производства, CPT-9019A тише CPT-1117-83 (см. выше), зато занимает на плате 10 × 9 мм вместо 15,5 × 9.

## Не на плате

| Что | Выбор | Примечание |
|---|---|---|
| Аккумулятор | Li-Po 1S со встроенной защитой (PCM), длина вместе с платой защиты до 15 мм: 401012 ~40 мА·ч ~1,0 г или 401015 ~50 мА·ч ~1,25 г | С выводами под пайку, разъём не нужен (D-26). Длиннее 15 мм аккумулятор заходит под площадки и модуль |
| Провода к полётнику | 4 провода ~30 AWG, около 10 см | Паяются к J1; к полётнику пайкой или JST SH под его порт |
| Термоусадка | прозрачная | |

## Масса (оценка)

| Элемент | Масса |
|---|---|
| Плата 17 × 32 × 0,6 мм | ~0,65 г |
| Модуль ISP2454-LX | ~0,15 г (в datasheet нет, оценка по объёму) |
| Излучатель CPT-1117-83 | 0,2 г |
| Остальные компоненты | ~0,15 г |
| Аккумулятор 40–50 мА·ч | 1,0–1,25 г |
| Провода 10 см и термоусадка | ~0,4 г |
| **Итого** | **~2,55–2,8 г** |

Ориентир: Flywoo Finder V1.0 весит 2,7 г.

## Отвергнутые варианты

| Вариант | Почему нет |
|---|---|
| Murata PKLCS1212E40A1-R1 | снят с производства, мало на складе |
| Две версии BOM с разными излучателями | владелец решил поставить один излучатель и проверить в деле |
| Insight SiP ISP1807-LR (nRF52840) | прошлое поколение, около 16 $ |
| Голый пьезодиск с мостом на транзисторах | завод не ставит диск на проводах |
| Излучатель напрямую от GPIO без драйвера | около 80 дБ на 10 см, тихо |
| Выводной FPV-буззер 12 × 9,5 мм | 1,5 г и 9,5 мм высоты при 89 дБ на 20 см |
| LDO 3,0 В TPS7A0230 (C3747031) | заменён на 3,3 В, решение D-14 |

## cricket-seeker

| Функция | Компонент |
|---|---|
| Радио, базовый | Ebyte E73-2G4M08S1CX (nRF52840, IPEX), LCSC C2764963 |
| Радио, усиленный | Fanstel BT840X (nRF52840 + SKY66112, +20 dBm, LNA) |
| Радио, тот же модуль | ISP2454-LX с внешней антенной через вывод OUT_MOD и U.FL |
| Антенна | патч 2,4 ГГц 25 × 25 мм 5–6 dBi или PCB-Yagi |

## Закрытые вопросы

1. **Зона антенны** — по datasheet ISP2454 разд. 4.3, см. раздел о требованиях к антенне.
2. **Утечка TP4054** — 1–2 мкА, учтена в энергобюджете.
3. **Пассивы** — подобраны из Basic, см. таблицу номиналов.
4. **Объём флеш-памяти** — Everytag с MCUboot и OTA на nRF54L15 (SDK v2.8.0) занимает 201 КБ из 674 КБ слота, ОЗУ 54 КБ из 188 КБ. Подробности в [firmware/README.md](../firmware/README.md#объём-флеш-памяти).

## Источники

- [Datasheet TP4054 (TOPPOWER)](https://datasheet.lcsc.com/datasheet/pdf/0b076ddf91114449998aff7a9f06b7d9.pdf?productCode=C32574), [datasheet PAM8904E](https://diodes.com/datasheet/download/PAM8904E.pdf)
- [Datasheet ISP2454 R7](https://www.insightsip.com/fichiers_insightsip/pdf/ble/ISP2454/isp_ble_DS2454.pdf), [Insight SiP ISP2454](https://insightsip.com/bluetooth-modules/isp2454/), [Mouser ISP2454](https://eu.mouser.com/en/c/?q=ISP2454), [JLCPCB ISP2454](https://jlcpcb.com/parts/componentSearch?searchTxt=ISP2454&isSearch=true), [nRF54L15: назначение выводов](https://docs.nordicsemi.com/bundle/ps_nrf54L15/page/chapters/pin.html), [TPS7A02 datasheet](https://www.ti.com/lit/gpn/tps7a02)
- [Datasheet BL54L15µ v0.6](https://docs.rs-online.com/5913/A700000013862904.pdf), [страница 453-00223C с наличием](https://www.ezurio.com/part/453-00223c), [Ezurio BL54L15µ](https://ezurio.com/wireless-modules/bluetooth-modules/bl54-series/bl54l15-micro-series-bluetooth-le-802-15-4-nfc), [Octopart 453-00223](https://octopart.com/search?q=453-00223)
- [Raytac AN54LV-15](https://www.raytac.com/product/ins.php?index_id=169), [Octopart AN54LV-15](https://octopart.com/search?q=AN54LV-15), [DigiKey AN54LV-15](https://www.digikey.com/en/products/detail/raytac/AN54LV-15/27793700)
- [HJ-N54L-SIP](https://www.digikey.com/en/products/detail/hjsip/HJ-N54L-SIP/28732673), [Fanstel BM15](https://fanstel.squarespace.com/bm15-nrf54l15-modules), [Ebyte E73-2G4M54LP](https://www.es-ebyte.com/products/E73-2G4M54LP(15)/7)
- LCSC: [TP4054 C32574](https://www.lcsc.com/product-detail/C32574.html), [TPS7A0233PDBVR C2887324](https://www.lcsc.com/product-detail/C2887324.html), [PAM8904EGPR C510550](https://www.lcsc.com/product-detail/C510550.html), [CPT-12123-81-SMT-TR C3812179](https://www.lcsc.com/product-detail/C3812179.html), [LIS2DH12TR C110926](https://www.lcsc.com/product-detail/C110926.html), [KT-0603W C2290](https://www.lcsc.com/product-detail/C2290.html), [2N7002 C8545](https://www.lcsc.com/product-detail/C8545.html), [TS-1088-AR02016 C720477](https://www.lcsc.com/product-detail/C720477.html)
- Бипер: [Octopart CPT-12123-81-SMT-TR](https://octopart.com/search?q=CPT-12123-81-SMT-TR), [Octopart CPT-1117-83-SMT-TR](https://octopart.com/search?q=CPT-1117-83-SMT-TR), [datasheet CPT-9019A-SMT-TR](https://www.sameskydevices.com/product/resource/cpt-9019a-smt-tr.pdf), [LCSC KLJ-1230](https://www.lcsc.com/product-detail/C201042.html), [LCSC FUET-1325](https://www.lcsc.com/product-detail/C391038.html), [LCSC CPT-9019A](https://www.lcsc.com/product-detail/C20181991.html), [Murata EOL](https://octopart.com/part/murata/PKLCS1212E40A1-R1)
- [Oscar Liang, сравнение буззеров](https://oscarliang.com/drone-buzzers-with-battery), [Flywoo Finder V1.0](https://www.getfpv.com/drone-brands/flywoo/flywoo-finder-v1-0-w-led-buzzer.html)
