yamaha252/Cricket/docs/manufacturing.md

# Заводская сборка

Цель: получать с JLCPCB полностью собранные платы. Требование и причины: [requirements.md](requirements.md), решение D-5 в [decisions.md](decisions.md).

## Правила для разработки платы

- Все компоненты на **верхней стороне**: двусторонняя сборка дороже.
- Тип сборки — **Standard PCBA**: модуль из Global Sourcing и панель с V-cut в Economic не принимаются. Расчёт стоимости — в [cost.md](cost.md).
- Каждый компонент должен быть на складе LCSC или доступен через JLCPCB Global Sourcing. Деталь, которую завод не ставит, в BOM не включается.
- Провода аккумулятора и полётника паяются руками к площадкам на нижней стороне (D-26). Это только медь без пасты, в BOM и CPL их нет, нижняя сторона заводом не собирается.
- Аккумулятор на плату не паяется. Завод его не ставит, а перевозка собранных плат с Li-Po ограничена.
- Площадки SWD — четыре круглые площадки 1,2 мм с шагом 2,54 мм снизу под аккумулятором (D-26). Только медь, в BOM их нет.

## Источники компонентов

| Источник | Что | Особенности |
|---|---|---|
| Склад LCSC, basic | резисторы, конденсаторы, диоды, светодиод KT-0603W, 2N7002, кнопка TS-1088 | без доплаты за установку катушки |
| Склад LCSC, extended | TP4054, TPS7A0233, PAM8904E, акселерометр, резистор 1,5 МОм (D-23) | доплата за загрузку катушки на каждую позицию |
| Global Sourcing | радиомодуль Insight SiP ISP2454-LX (D-29; на складе JLCPCB его нет, предзаказ C44975104 по 20,62 $ вдвое дороже) и излучатель CPT-1117-83-SMT-TR (на складе JLCPCB 1 шт., D-27); цены и поставщики — в [cost.md](cost.md#модуль-и-излучатель) | JLCPCB закупает у дистрибьютора по вашему заказу, см. [Global Sourcing](#global-sourcing). Срок 8–20 рабочих дней, ручной сбор около 0,017 $ за вывод, не более 0,17 $ за деталь |
| Consignment | детали, купленные и отправленные самостоятельно | **не используется**: владелец исключил этот путь как накладный |

Перед заказом проверить: на один и тот же парт-номер нельзя смешивать склад JLCPCB и присланные детали. Правила смешивания Global Sourcing и pre-order в разных статьях справки JLCPCB расходятся.

## Панелизация

Плата 17 × 32 мм (D-28) меньше минимума для автомата. Для Standard PCBA плата или панель должна быть не меньше 70 × 70 мм, меньшую JLCPCB дополняет технологическими полями 5 мм. Нужны реперные знаки (fiducials) на полях. Минимальный заказ сборки — 2 панели.

- Вариант NextPCB (D-31): «Panel by NextPCB» 2 × 2 с полями 5 мм по четырём сторонам, панель 44 × 74 мм — минимума 70 × 70 мм у NextPCB нет; 5 панелей изготовить, 8 плат собрать, фрезеровка с mouse bites, разделяет завод.
- Вариант JLCPCB (D-30): «Panel by JLCPCB» 2 × 2, технологические поля 18 мм по четырём сторонам, панель 70 × 100 мм; 5 панелей изготовить, 2 собрать = 8 плат. Калькулятор предлагает только V-cut. С полями 5 мм панель 2 × 2 выходит 44 × 74 мм, меньше минимума; ширина полей задаётся в окне панели. Реперные знаки на полях JLCPCB ставит сам («Edge Rails/Fiducials: Added by JLCPCB»). Расчёт в [cost.md](cost.md#тестовая-партия-расчёт-jlcpcb-2026-11-10).
- Серия: панель 4 × 3 (12 плат) или крупнее.

Медь до кромки по правилам JLCPCB: не меньше 0,2 мм при фрезеровке и mouse bites, не меньше 0,4 мм при V-cut. **Эта плата под V-cut не годится** (проверено 2026-11-10 прогоном DRC с правилом 0,4 мм): 52 места ближе 0,4 мм к краю — заливка GND 0,20 мм, 15 переходных GND и площадка SW1 0,25 мм, площадка D2 и дорожка +3V3 0,275 мм, дорожки BUZ_N, LED_A и GND 0,31–0,39 мм. Канавка и разлом рядом с медью могут оголить или надорвать дорожки, а SW1 и D2 у самого края. Плата проходит DRC только с правилом 0,2 мм — это предел для фрезеровки. Только торец с антенной ISP2454-LX (D-29) без меди: ближайшие механические площадки модуля в 1,1 мм от торцевой кромки и в 1,4 мм от боковой ([components.md](components.md#требования-к-встроенной-антенне)).

Поэтому панель — **фрезеровка контура с перемычками и отверстиями (mouse bites)**, перемычки подальше от SW1, D2 и торца с модулем; разделяет завод (D-31). «Panel by JLCPCB» в калькуляторе предлагает только V-cut — для JLCPCB панель пришлось бы делать самим в KiCad или договариваться с поддержкой. Чтобы V-cut стал возможен, медь надо отодвинуть от края до 0,4 мм (ревизия B).

## Первая партия

Доставка на склад форвардера в Гуандуне (D-30). Один вариант BOM с излучателем CPT-1117-83-SMT-TR (решение D-27) через Global Sourcing. После сборки: замер шумомером на 20 см на нескольких частотах 3–8 кГц и тест слышимости в траве. Если громкости мало или излучателя не окажется, запасной — CPT-9019A со склада LCSC (футпринт в библиотеке, плата другая).

## Что делается руками после получения плат

1. Прошивка через площадки SWD J3 (VDD, SWDIO, SWCLK, GND) снизу, пока аккумулятор не припаян: подпружиненные контакты с шагом 2,54 мм или временные провода к J-Link или любому CMSIS-DAP. Далее обновления по BLE.
2. Пайка проводов аккумулятора к J2 (1 — плюс, 2 — минус), аккумулятор ложится снизу за площадками.
3. Пайка четырёх проводов полётника к J1 (5 В, GND, TX, RX), закрепление проводов термоусадкой или клеем.
4. Термоусадка на весь маячок.

## Замеры на первых платах

Расчёты ревью 2026-11-10 показали, что менять плату не нужно; замеры их подтверждают. Любое отклонение лечится прошивкой или заменой номинала на том же посадочном месте.

| Что | Как | Ожидание | Если хуже |
|---|---|---|---|
| VOUT PAM8904E в режиме 3x | осциллограф на C13, аккумулятор 4,2 В, писк 4 кГц; затем то же при заряде от 5 В | 10–12,6 В, пульсации до ~0,85 В; не выше 13,5 В (предел драйвера). Размах на излучателе до 25 В — его предел | пульсации больше — C13, C14 на 2,2 мкФ 25 В; размах выше 25 В — в прошивке 1x при заряде и VBAT выше ~4,15 В |
| Ток сна | микроамперметр в разрыв аккумулятора, 5 В нет, режимы STANDBY и SHIP | SHIP ~4–5 мкА, STANDBY ~20–26 мкА ([concept.md](concept.md#энергобюджет-оценка-уточнить-замером)) | сотни мкА — не выключен UART или NFC-выводы не переведены в GPIO; лишние ~2 мкА — делитель VBAT |
| Кварц 32,768 кГц (внутри модуля, D-29) | запуск LFXO и уход часов за 10 мин; в devicetree внутренняя нагрузочная ёмкость 19 пФ по datasheet ISP2454 | запуск меньше 1 с, уход в пределах ±20 ppm кварца | подобрать ёмкость; в крайнем случае источник LFCLK — внутренний RC |
| Громкость | шумомер на 10 и 20 см, частоты 3–8 кГц, режимы 1x и 3x | ≥83 дБ на 10 см уже при 5 В размаха, в 3x заметно громче | подобрать частоту или качание; запасной излучатель CPT-9019A — другая плата |
| Дальность | приложение, прямая видимость, 1M и Coded PHY | 150–250 м и 300–500 м (D-17) | проверить положение антенны относительно карбона и аккумулятора |
| Заряд | ток в аккумулятор при 5 В, напряжение окончания | ~45 мА, 4,2 В ±1 % | R3 (PROG) |

## Выходные файлы

Генерирует `hardware/cricket-tag/make_fab.sh` в `hardware/cricket-tag/fab/`, руками не правятся:

- `cricket-tag-gerbers.zip` — gerber 9 слоёв и сверловка (Excellon, PTH и NPTH отдельно); его и загружают в калькулятор;
- `bom.csv` — BOM в формате JLCPCB: Comment, Designator, Footprint, LCSC Part #;
- `cpl.csv` — Designator, Mid X, Mid Y, Layer, Rotation, с поправками поворота JLCPCB;
- `bom-mpn.csv` — BOM для других заводов (NextPCB): Designator, Quantity, Manufacturer, Manufacturer Part Number, Description, Package, LCSC Part #. Номера производителя берутся из таблицы `MPN` в скрипте по номеру LCSC (номера пассивов — из подбора JLCPCB); в схеме поля MPN заполнены не у всех символов;
- `cpl-kicad.csv` и `cpl-kicad.zip` — расстановка с поворотами KiCad без поправок, для других заводов; NextPCB принимает её только в zip, rar, xls или xlsx.

Поле `LCSC Part` заполняется в свойствах символов в схеме, чтобы BOM собирался автоматически.

Что выяснилось на первой загрузке (2026-11-10):

- **Кодировка.** JLCPCB читает CSV не как UTF-8: «µ» превращается в «碌», «Ω» — в «惟». Подбор от этого не ломается (он идёт по номеру LCSC), но `make_fab.sh` пишет Comment только в ASCII (`10uF`, `1kOhm`).
- **Повороты.** Поправка зависит от модели детали в библиотеке JLCPCB, а не от корпуса: U2 TP4054 и U3 TPS7A0233 оба в SOT-23-5 с поворотом 0, а развёрнуты в предпросмотре по-разному. Поэтому таблица поправок в `make_fab.sh` ключуется номером LCSC: TP4054 C32574 +270°, TPS7A0233 C2887324 +180°, 2N7002 C8545 +180°, LIS2DH12 C110926 +270°. Проверено в предпросмотре: метка первого вывода модели (розовая точка) совпадает с треугольником на шелкографии у U2–U5 и Q1, полярность D1 и D2 верная. **U1 и BZ1 не проверены** — в расчёте их не ставили; смотреть в предпросмотре, когда они будут выбраны со своего склада. При новой детали в BOM — проверить её в предпросмотре и при необходимости дописать поправку.
- В заказе включать «Confirm Parts Placement» (0,45 $): инженеры JLCPCB присылают расстановку на подтверждение, без ответа за 72 часа запускают сами.

## Варианты заводов

Завод для первого заказа не выбран (D-31). Посчитаны четыре; ответы заводов — в [cost.md](cost.md#ответы-заводов-на-расчёты-8-плат-2026-11-11), цены по числу плат и купоны — [там же](cost.md#сколько-плат-собирать-минимум-и-оптимум-2026-11-10):

| | JLCPCB (D-30) | NextPCB | Seeed Fusion | SCSPCBA |
|---|---|---|---|---|
| 8 плат | ~250–285 $ + доставка до форвардера ~2 $ | **371,11 $ к оплате**: 325,12 $ с акцией −200 $ + доставка SF 3,30 $ + НДС Китая 42,69 $ | **520,70 $** после проверки, с купоном −50 $ ~470 $; доставка бесплатная, НДС не проверен | не считалось |
| 2 / 4 платы | минимум 2 панели | 193,65 / 232,41 $ | ~274 $ / — (оценка с модулем) | — / **159,83 $ к оплате** после проверки, все 20 позиций, доставка UPS 3,08 $ |
| Сборка для Казахстана | скрыта по IP посетителя; Казахстан в чёрном списке стран доставки | доступна, Казахстан в условиях не запрещён | доступна, Казахстана нет в списке запрещённых; Китай и Казахстан есть в доставке | не проверено; доставка только UPS, DHL, FedEx, стоимость — после проверки |
| Модуль и излучатель | покупать заранее через Global Sourcing | завод закупает сам, модуль 14,30 $ | завод закупает сам, модуль 14,33 $ | завод закупает сам, модуль 13,35 $; все позиции по MPN из BOM, без замен |
| Панель | «Panel by JLCPCB» только V-cut — плате не подходит | фрезеровка и разделение заводом — в примечаниях к расчёту | в калькуляторе только отдельные платы; поля для примечаний нет — требования передавать письмом на fusion@seeed.io | «Panel by SCSPCBA» 2 × 2, поля 5 мм, разделение заводом («Depanel: YES»), фрезеровка с mouse bites — в примечаниях |
| Статус (2026-11-11) | расчёт в корзине JLCPCB | проверен, «Waiting for Payment»; оплата Alipay в юанях | проверен, «Confirmed» | SCS261112-1000-A проверен 2026-11-12, «To Be Paid»; доставка UPS до форвардера; электротест зачёркнут, фрезеровка и рентген не подтверждены — спросить до оплаты |
| Срок | ~4–5 дней + 8–20 рабочих дней Global Sourcing | 14–27 рабочих дней | 23 рабочих дня | 14 дней |

Ничего не оплачено. Рекомендация по количеству для нулевой ревизии — 3–4 платы ([cost.md](cost.md#сколько-плат-собирать-минимум-и-оптимум-2026-11-10)). Автоматический расчёт сборки с ценами деталей, кроме этих четырёх и PCBWay, не найден (проверено 2026-11-11): ALLPCB и Elecrow сразу считают только монтаж, PCBasic, PCBCool, VictoryPCB, OurPCB, LZJPCB, EFPCB считают вручную за 4 часа – 2 дня, Makerfabs — по почте, WellPCB и Smart Prototyping, судя по сайтам, тоже вручную. PCBWay и PCBGoGo закрыты.

## Заказ на NextPCB

Вариант (D-31). NextPCB с IP из Казахстана открывается полностью, Казахстан в условиях не запрещён (запрещены санкционные страны и переэкспорт туда), закупает детали сам у DigiKey, Mouser, Element14, монтирует LGA и QFN с рентгеном, минимального количества нет. Расчёт — в [cost.md](cost.md#тестовая-партия-расчёт-nextpcb-2026-11-10).

1. `nextpcb.com/pcb-assembly-quote`, шаг 1 «PCB»: загрузить `cricket-tag-gerbers.zip`. Board Type — Panel by NextPCB, Panel Type 2 × 2, Break-away Rail — All 4 sides, 5 мм (панель 44 × 74 мм). Panel Qty — не меньше 5. Толщина 0,6 мм, ENIG. Класс 4/4 mil NextPCB выставляет сам по gerber (минимум у нас 4,4/5,2 mil). If Data Conflicts — Ask for Confirmation. В Special Requests платы — про фрезеровку с mouse bites вместо V-cut (см. «Панелизация»).
2. Шаг 2 «Assembly»: Centroid File — `cpl-kicad.zip`, PCBA Qty — число плат (8), BOM File — `bom-mpn.csv`. Все 20 позиций сопоставляются автоматически. В Special Requests сборки: сколько плат и панелей, разделить на заводе и прислать отдельные платы, проверить ориентацию первого вывода (повороты KiCad) и прислать расстановку на подтверждение, просушить модуль (MSL 3) и сделать рентген U1, U4, U5, спросить про переходное в площадке U4.
3. Add to Cart требует аккаунт. В корзине три связанные позиции — плата (P-…), сборка (T-…), компоненты (B-…) — со статусом «Under Review»: инженеры проверяют файлы, цену компонентов выставляют после проверки. Удаление одной позиции удаляет всю группу. Оформить и увидеть доставку можно после проверки (статус «Awaiting Payment»).
4. Адрес доставки — форвардер в Гуандуне (D-30), для Китая адрес пишется по-китайски; хранится в аккаунте NextPCB, в репозитории нет.

Важно при вводе: выбранные на шаге 1 поля и параметры панели могут не сохраниться при переходе между шагами — перед Add to Cart проверять карточку позиции в корзине («Break-away Rail», размер панели), а после — Special Requests в карточке заказа.

Замечания NextPCB по файлам: переходное в площадке (центральная площадка PAM8904E, D-28) — предлагают заливку с закрытием (VII), мы оставили закрытые маской переходные и спросили инженеров.

## Заказ на JLCPCB

Вариант (D-30). Ограничения: сборка для Казахстана скрыта по IP, «Panel by JLCPCB» только с V-cut, который этой плате не подходит (D-31).

Порядок, проверенный расчётом 2026-11-10:

1. Калькулятор `cart.jlcpcb.com/quote`: загрузить `cricket-tag-gerbers.zip`; Delivery Format — Panel by JLCPCB (см. «Панелизация»); толщина 0,6 мм, ENIG.
2. Включить PCB Assembly: Standard (Economic недоступен), Top Side, PCBA Qty — Custom, число панелей для сборки; Confirm Parts Placement — Yes. Сборка добавляет оснастку (16,54 $) и рентген (13,20 $).
3. NEXT → Bill of Materials: загрузить `bom.csv` и `cpl.csv`, режим «Single Piece» (JLCPCB сам размножит данные на панель), Process BOM & CPL.
4. Для U1 и BZ1 — выбрать детали со своего склада (вкладка My Inventory в поиске детали), когда они туда придут через Global Sourcing. Без этого JLCPCB предлагает «Do not place».
5. Component Placements: проверить повороты (см. «Выходные файлы»).
6. Quote & Order → Save to cart. Для корзины нужно описание товара для таможни; для прототипа подходит «Research\Education\DIY\Entertainment → Development Board» (HS 847330). Доставка выбирается в корзине.

### Ограничение по стране

Блок PCB Assembly в калькуляторе показывается или прячется по ответу `GET /api/overseas-pcb-order/v1/newOrder/getSwitchSmtByIp` — он зависит от IP посетителя, а не от выбранной страны доставки. Отдельно `getBlacklistedCountries` возвращает страны, куда сборку не отправляют: IR, KP, RU, SS, SD, SO, CF, CD, IQ, LB, LY, ML, YE, SY, BY, ZW, VE, AF, MM, GW, CU, ER, UA, KZ, TJ, KG, TM, UZ (2026-11-10). Из Казахстана сборка недоступна ни при какой стране доставки; расчёт 2026-11-10 сделан, когда сайт определял регион как Финляндию. Отправка в Китай для сборки разрешена. Голые платы без сборки доступны и для Казахстана.

### Доставка

В Китай (D-30), посылка 0,35 кг: SF Express по Гуандуну 2,07 $ (1–2 рабочих дня), в другие провинции 2,87 $, JYM Express по Гуандуну 1,12 $, самовывоз с завода 10,08 $. Для сравнения: голые платы в Казахстан — DHL 41,92 $, UPS 38,40 $, Special Air Line 5,74 $ (13–24 дня).

### Global Sourcing

Детали, которых нет на складе JLCPCB, покупаются заранее:

1. Личный кабинет → Parts → Order Parts → Global Sourcing Parts, поиск по номеру производителя. Видны предложения DigiKey, Mouser, Arrow, Verical, RS, TME, CoreStaff и др.: склад, минимальная партия, упаковка, срок, цена со ступенями. К части позиций добавлен сбор ~10 % (в строке «Ext. Price: X + Y»).
2. Детали оплачиваются отдельной корзиной. JLCPCB заказывает их, принимает на склад и кладёт в My Inventory — личный склад. Срок 8–20 рабочих дней.
3. В заказе сборки на шаге BOM деталь выбирается из My Inventory.

Ограничения (примечание на странице Order Parts): детали со склада только для сборки у JLCPCB, забрать их нельзя; детали со склада JLCPCB и Global Sourcing после оплаты не отменяются, предзаказ — после того как JLCPCB выставил цену. Остатки хранятся для следующих заказов; условия хранения не проверены.

### JLCONE

Настольное приложение JLCPCB (Windows, macOS, мобильные). Тот же аккаунт и те же услуги, платы в нём дешевле на 1–20 $ за заказ. Действует ли там ограничение сборки по стране и все ли опции сайта доступны — не проверено.

## Источники

- [JLCPCB Global Sourcing](https://jlcpcb.com/help/article/how-to-use-jlcpcb-global-sourcing-parts-service), [условия Global Sourcing](https://jlcpcb.com/help/article/global-sourcing-parts-order-terms-conditions)
- [Условия consignment](https://jlcpcb.com/help/article/consignment-part-terms-conditions)
- [FAQ по сборке JLCPCB](https://jlcpcb.com/help/article/pcb-assembly-faqs), [сборка прототипов](https://jlcpcb.com/solutions/pcb-prototype-assembly)
