yamaha252/Cricket/hardware/cricket-tag/cricket-tag.kicad_pcb

## KiCad design hardware/cricket-tag/cricket-tag.kicad_pcb (2026-11-12)

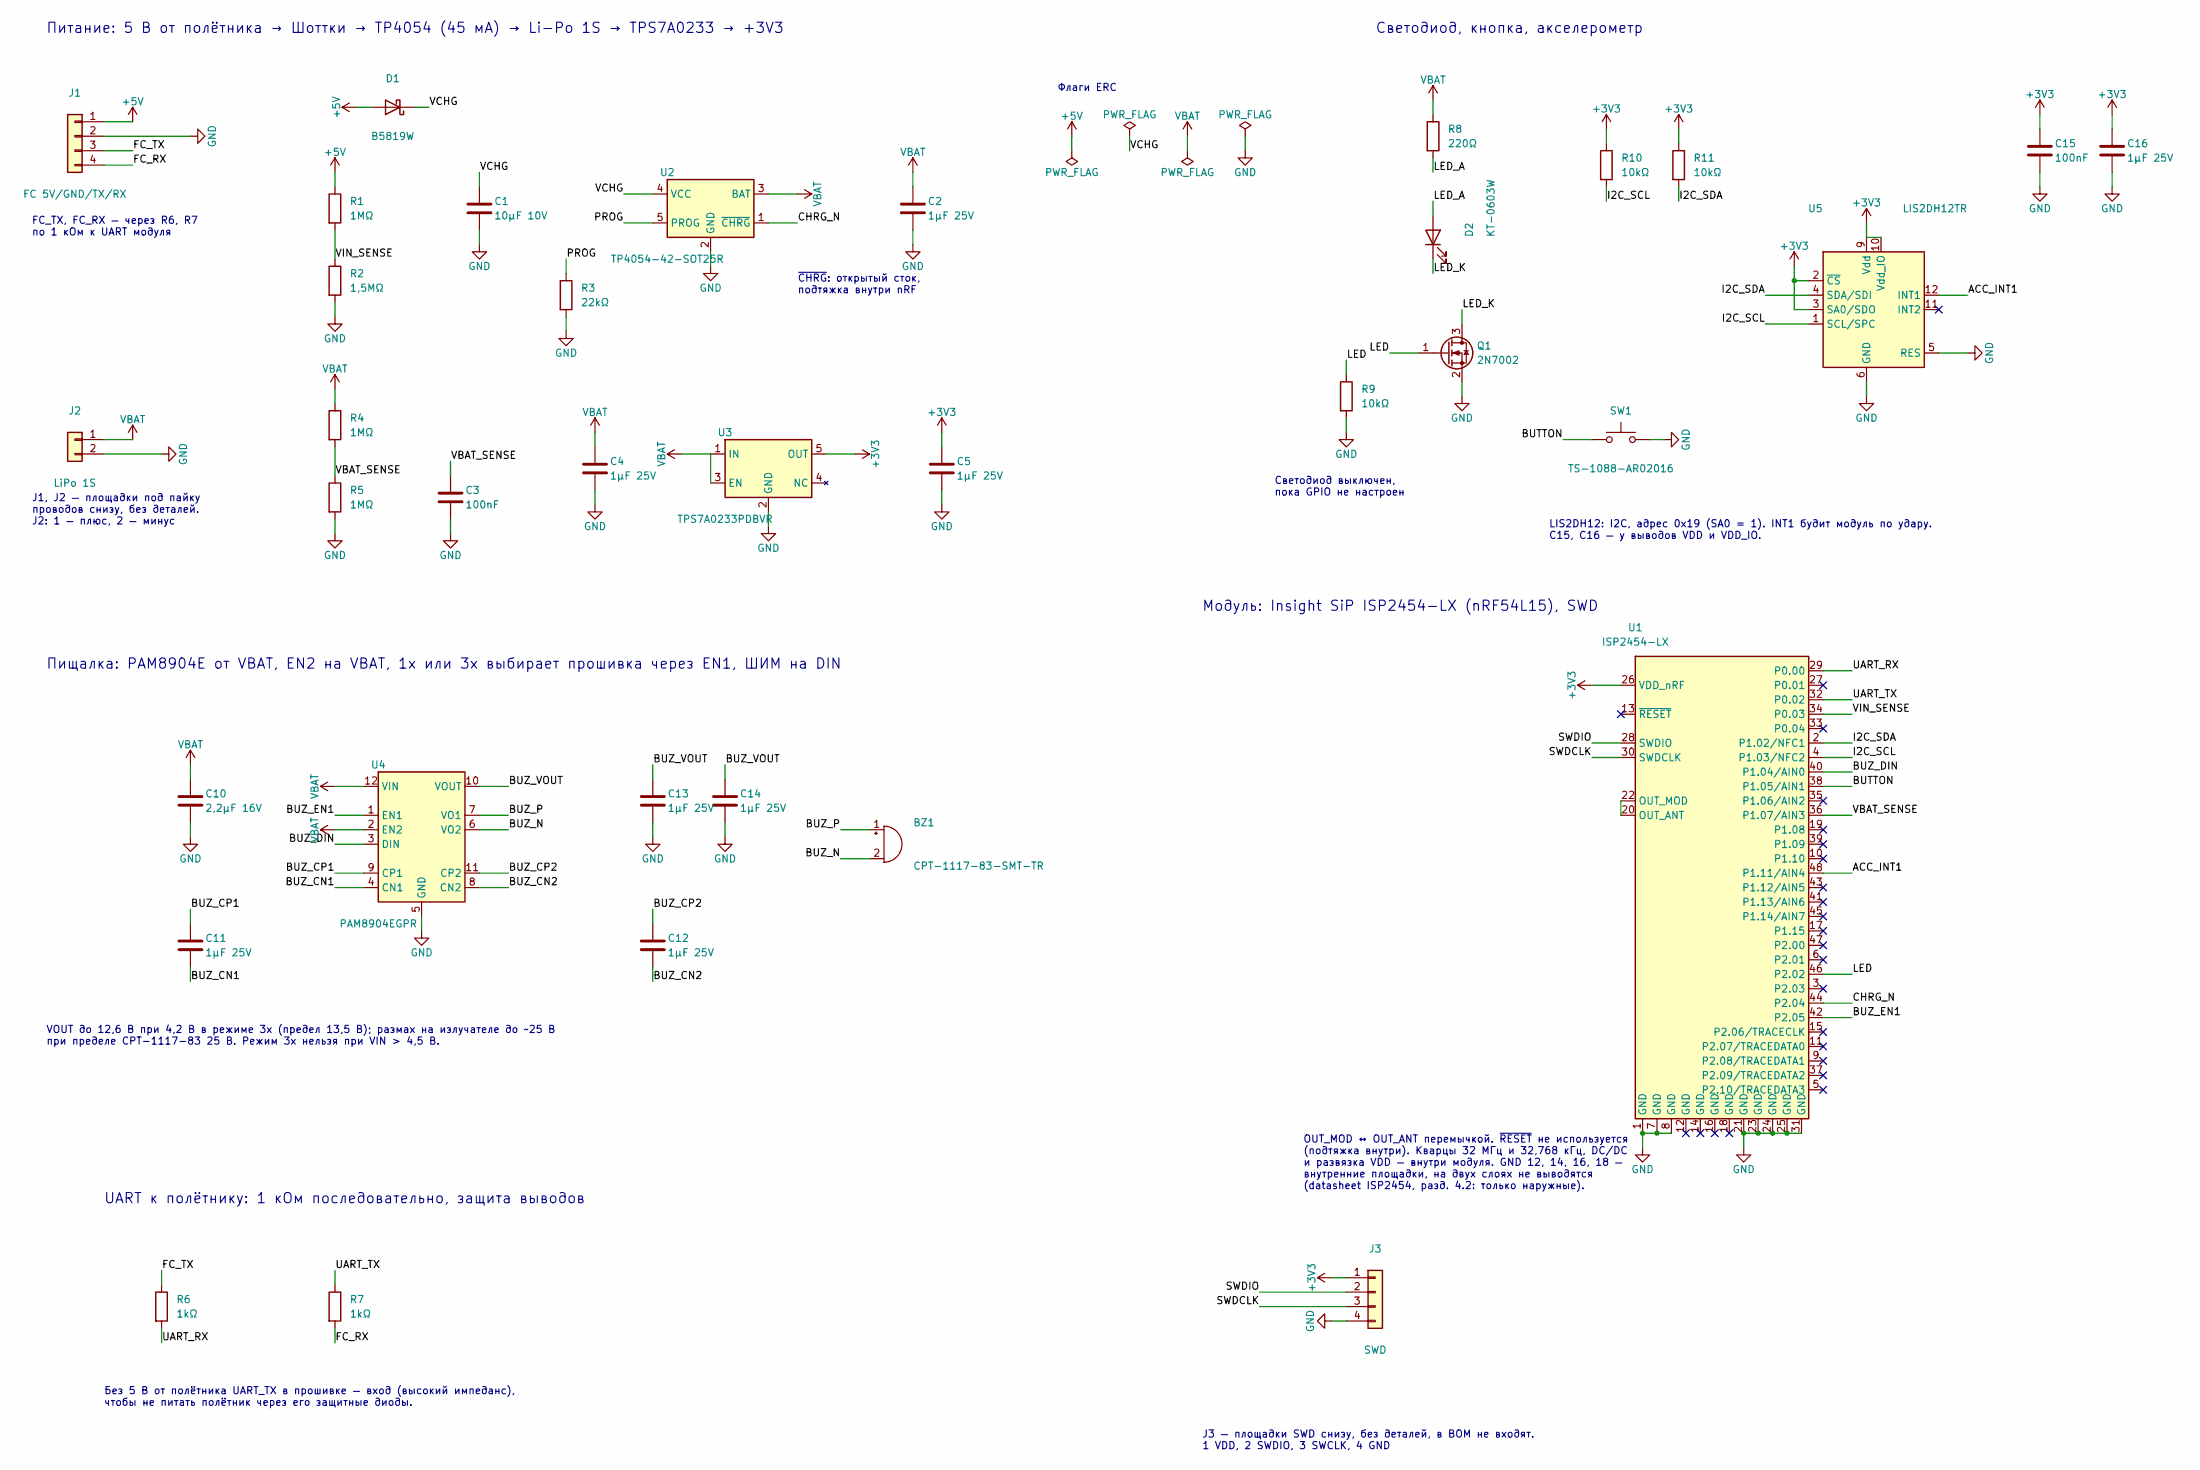
[picture p10: schematic cricket-tag.kicad_sch, Cricket Tag]

Parts:
BZ1: CPT-1117-83-SMT-TR; SameSky_CPT-1117-83-SMT; MPN CPT-1117-83-SMT-TR; LCSC Part C22359733
C1: 10µF 10V; C_0603_1608Metric; LCSC Part C19702
C2, C4, C5, C11, C12, C13, C14, C16: 1µF 25V; C_0402_1005Metric; LCSC Part C52923
C3, C15: 100nF; C_0402_1005Metric; LCSC Part C1525
C10: 2,2µF 16V; C_0603_1608Metric; LCSC Part C23630
D1: B5819W; D_SOD-123; LCSC Part C8598
D2: KT-0603W; LED_0603_1608Metric; MPN KT-0603W; LCSC Part C2290
J1: FC 5V/GND/TX/RX; WirePads_1x04_P2.0mm
J2: LiPo 1S; WirePads_1x02_P2.0mm
J3: SWD; SWD_Pads_1x04_P2.54mm
Q1: 2N7002; SOT-23; MPN 2N7002; LCSC Part C8545
R1, R4, R5: 1MΩ; R_0402_1005Metric; LCSC Part C26083
R2: 1,5MΩ; R_0402_1005Metric; LCSC Part C22276
R3: 22kΩ; R_0402_1005Metric; LCSC Part C25768
R6, R7: 1kΩ; R_0402_1005Metric; LCSC Part C11702
R8: 220Ω; R_0402_1005Metric; LCSC Part C25091
R9, R10, R11: 10kΩ; R_0402_1005Metric; LCSC Part C25744
SW1: TS-1088-AR02016; SW_SPST_TS-1088-xR020; MPN TS-1088-AR02016; LCSC Part C720477
U1: ISP2454-LX; ISP2454-LX_CornerAntenna; MPN ISP2454-LX-RS; LCSC Part C44975104
U2: TP4054-42-SOT25R; SOT-23-5; MPN TP4054-42-SOT25R; LCSC Part C32574
U3: TPS7A0233PDBVR; SOT-23-5; MPN TPS7A0233PDBVR; LCSC Part C2887324
U4: PAM8904EGPR; Diodes_W-QFN2020-12_2x2mm_P0.4mm_EP1.0x1.0mm; MPN PAM8904EGPR; LCSC Part C510550
U5: LIS2DH12TR; LGA-12_2x2mm_P0.5mm; MPN LIS2DH12TR; LCSC Part C110926

Connections:
+3V3: C5.1, C15.1, C16.1, J3.1, R10.1, R11.1, U1.26 (VDD_nRF), U3.5 (OUT), U5.2 (~CS), U5.3 (SA0/SDO), U5.9 (Vdd), U5.10 (Vdd_IO)
+5V: D1.2 (A), J1.1, R1.1
/ACC_INT1: U1.48 (P1.11/AIN4), U5.12 (INT1)
/BUTTON: SW1.1, U1.38 (P1.05/AIN1)
/BUZ_CN1: C11.2, U4.4 (CN1)
/BUZ_CN2: C12.2, U4.8 (CN2)
/BUZ_CP1: C11.1, U4.9 (CP1)
/BUZ_CP2: C12.1, U4.11 (CP2)
/BUZ_DIN: U1.40 (P1.04/AIN0), U4.3 (DIN)
/BUZ_EN1: U1.42 (P2.05), U4.1 (EN1)
/BUZ_N: BZ1.2 (-), U4.6 (VO2)
/BUZ_P: BZ1.1 (+), U4.7 (VO1)
/BUZ_VOUT: C13.1, C14.1, U4.10 (VOUT)
/CHRG_N: U1.44 (P2.04), U2.1 (~CHRG)
/FC_RX: J1.4, R7.2
/FC_TX: J1.3, R6.1
/I2C_SCL: R10.2, U1.4 (P1.03/NFC2), U5.1 (SCL/SPC)
/I2C_SDA: R11.2, U1.2 (P1.02/NFC1), U5.4 (SDA/SDI)
/LED: Q1.1 (G), R9.1, U1.46 (P2.02)
/LED_A: D2.2 (A), R8.2
/LED_K: D2.1 (K), Q1.3 (D)
/PROG: R3.1, U2.5 (PROG)
/SWDCLK: J3.3, U1.30 (SWDCLK)
/SWDIO: J3.2, U1.28 (SWDIO)
/UART_RX: R6.2, U1.29 (P0.00)
/UART_TX: R7.1, U1.32 (P0.02)
/VBAT_SENSE: C3.1, R4.2, R5.1, U1.36 (P1.07/AIN3)
/VCHG: C1.1, D1.1 (K), U2.4 (VCC)
/VIN_SENSE: R1.2, R2.1, U1.34 (P0.03)
GND: C1.2, C2.2, C3.2, C4.2, C5.2, C10.2, C13.2, C14.2, C15.2, C16.2, J1.2, J2.2, J3.4, Q1.2 (S), R2.2, R3.2, R5.2, R9.2, SW1.2, U1.1 (GND), U1.7 (GND), U1.8 (GND), U1.21 (GND), U1.23 (GND), U1.24 (GND), U1.25 (GND), U1.31 (GND), U2.2 (GND), U3.2 (GND), U4.5 (GND), U4.13 (GND), U5.5 (RES), U5.6 (GND), U5.7 (GND), U5.8 (GND)
unnamed: U1.20 (OUT_ANT), U1.22 (OUT_MOD)
VBAT: C2.1, C4.1, C10.1, J2.1, R4.1, R8.1, U2.3 (BAT), U3.1 (IN), U3.3 (EN), U4.2 (EN2), U4.12 (VIN)

Notes on the sheet:
Питание: 5 В от полётника → Шоттки → TP4054 (45 мА) → Li-Po 1S → TPS7A0233 → +3V3
FC_TX, FC_RX — через R6, R7 по 1 кОм к UART модуля
~{CHRG}: открытый сток, подтяжка внутри nRF
J1, J2 — площадки под пайку проводов снизу, без деталей. J2: 1 — плюс, 2 — минус
Флаги ERC
Модуль: Insight SiP ISP2454-LX (nRF54L15), SWD
OUT_MOD ↔ OUT_ANT перемычкой. ~{RESET} не используется (подтяжка внутри). Кварцы 32 МГц и 32,768 кГц, DC/DC и развязка VDD — внутри модуля. GND 12, 14, 16, 18 — внутренние площадки, на двух слоях не выводятся (datasheet ISP2454, разд. 4.2: только наружные).
J3 — площадки SWD снизу, без деталей, в BOM не входят. 1 VDD, 2 SWDIO, 3 SWCLK, 4 GND
Пищалка: PAM8904E от VBAT, EN2 на VBAT, 1x или 3x выбирает прошивка через EN1, ШИМ на DIN
VOUT до 12,6 В при 4,2 В в режиме 3x (предел 13,5 В); размах на излучателе до ~25 В при пределе CPT-1117-83 25 В. Режим 3x нельзя при VIN > 4,5 В.
Светодиод, кнопка, акселерометр
Светодиод выключен, пока GPIO не настроен
LIS2DH12: I2C, адрес 0x19 (SA0 = 1). INT1 будит модуль по удару. C15, C16 — у выводов VDD и VDD_IO.
UART к полётнику: 1 кОм последовательно, защита выводов
Без 5 В от полётника UART_TX в прошивке — вход (высокий импеданс), чтобы не питать полётник через его защитные диоды.

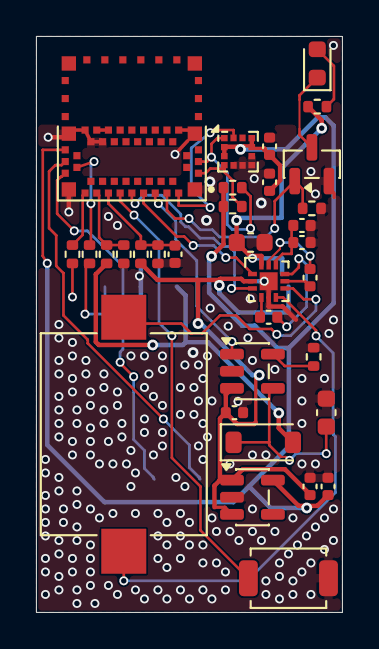
[picture p11: board cricket-tag.kicad_pcb from above]

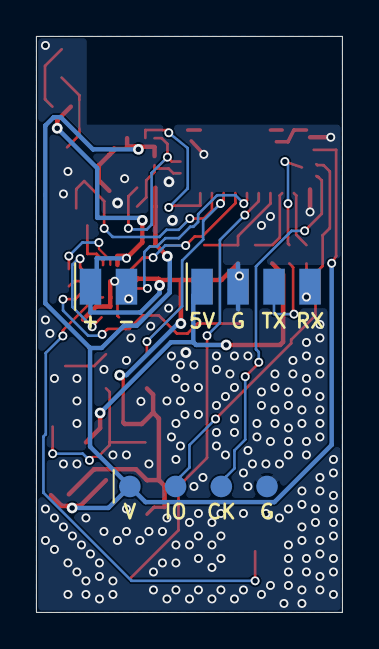
[picture p12: board cricket-tag.kicad_pcb from below]

Board: 2 copper layers, 17.0 x 32.0 mm, 36 parts (3 on the bottom side), 32 nets.
