yamaha252/Cricket/firmware/app/src/adv.h

/* SPDX-License-Identifier: MIT */
/* Cricket advertising sets: Coded S8 (extended) and 1M (legacy), both connectable. */
#pragma once

#include <stdbool.h>
#include "status.h"

int adv_init(void);
/*
 * Set intervals for the mode; quiet on the drone (flying) silences the radio
 * (ELRS coexistence): advertising stops and connected phones are dropped.
 */
void adv_apply(enum cricket_mode mode, bool quiet);
/* Push current status into both sets' advertising data. */
void adv_refresh(void);
/* Re-read config.c settings (TX power, name, intervals) and restart the sets. */
void adv_reload(void);
void adv_stop_all(void);
