yamaha252/Cricket/firmware/app/src/buzzer.h

/* SPDX-License-Identifier: MIT */
/* Buzzer (PAM8904E driven by PWM) and flash LED, played as patterns. */
#pragma once

#include <stdbool.h>
#include <stdint.h>

enum buzz_pattern {
	BUZZ_OFF,
	BUZZ_TEST,   /* one short beep and flash: button press, self-test */
	BUZZ_ACK,    /* two short beeps: command accepted */
	BUZZ_CHIRP,  /* quiet short chirp: ESCALATE warning */
	BUZZ_ALARM,  /* loud burst: ALARM */
	BUZZ_BEACON, /* single loud beep: BEACON */
	BUZZ_FIND,   /* repeat beeps for the given time: app command */
	BUZZ_BYE,    /* falling double beep before SHIP */
	BUZZ_LOW_BATT, /* three long beeps: tag battery low at preflight */
	BUZZ_NO_MSP, /* two long beeps: flight controller does not answer MSP */
};

int buzzer_init(void);
/* duration_s is used by BUZZ_FIND only. A new pattern replaces the one playing. */
void buzzer_play(enum buzz_pattern pattern, uint8_t duration_s);
bool buzzer_active(void);
/* While charging VBAT reaches 4.24 V and 3x would exceed 25 Vpp on CPT-1117-83: force 1x. */
void buzzer_set_charging(bool charging);
