yamaha252/Cricket/firmware/app/src/inputs.h

/* SPDX-License-Identifier: MIT */
/* Button and flight-controller inputs, delivered as mode events. */
#pragma once

#include <stdbool.h>

int inputs_init(void);
bool inputs_vin_present(void);
/* TP4054 is charging the battery (CHRG_N low); false when the board has no such input. */
bool inputs_charging(void);
/* Configure the user button to wake the chip from System OFF. */
void inputs_prepare_wakeup(void);
