yamaha252/Cricket/(commit log)

2026-11-09 Initial Cricket project: requirements, decisions, component choice
    Drone crash beacon (cricket-tag) on u-blox ANNA-B402 (nRF52833),
    fully assembled at JLCPCB. Includes requirements, decision log
    D-1..D-18, architecture and energy budget, BOM with verified LCSC
    codes, antenna keep-out from the u-blox reference design,
    manufacturing rules, app concept, dev environment setup and an
    empty KiCad skeleton.
    [cricket-tag.kicad_pcb, cricket-tag.kicad_sch]
2026-11-09 Rev A sourcing, cost and test batch decisions
    - Radio stays u-blox ANNA-B402; Ebyte E73 from JLCPCB stock compared
    and rejected (D-19), options documented in docs/module-options.md
    - Buzzer switched to Same Sky CPT-1117-83 via Global Sourcing (D-20),
    datasheet comparison of 8 emitters, mass now ~2.5-2.9 g
    - Production cost per batch size in docs/cost.md; Standard PCBA
    required because of Global Sourcing parts
    - First order: test batch of 8 boards on a 2x2 panel, ~230 $ (D-21);
    inspection fee does not apply, module duty 3-30 % possible
    - Everytag ported to NCS 3.4.2 (three lines) and built for nRF54L10
    - Review fixes: crystal load caps 18 pF, charge current 45 mA,
    energy budget, sta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
2026-11-09 Review fixes: KiCad DRC rules, antenna edge clearance, doc consistency
    - Schematic title block: ANNA-B402 (nRF52833) instead of stale BL54L15.
    - KiCad rules: default via 0.6/0.3 mm (annular 0.15 >= 0.13 rule), drop
    0.6/0.2 preset, copper-to-edge 0.2 mm per JLCPCB routed edge minimum.
    - Document counterpoise offset 0.2 mm vs 0.16 mm u-blox and mouse-bites
    requirement on the antenna side (JLCPCB: 0.2 mm routed, 0.4 mm V-cut).
    - Fix Everytag URL, Ebyte mass/size figures, Economic fixed cost,
    Standard PCBA feeder fee note, JLCPCB BOM/CPL export commands,
    TC2030-NL pin count, test batch wording, VBAT divider SHIP note.
    [cricket-tag.kicad_sch]
2026-11-09 ANNA-B402 symbol and footprint with antenna counterpoise and keepout
    - Project library `cricket` (sym-lib-table, fp-lib-table via ${KIPRJMOD}).
    - Symbol ANNA-B402: pins named by nRF52833 port, LCSC Part C6124130.
    - Footprint ANNA-B402_CornerAntenna: 56 pads per datasheet fig. 5,
    counterpoise on pad 1 (copper under mask) and track/via/pour keepout
    on F.Cu and B.Cu per integration manual fig. 33-34; u-blox board
    edges marked on Cmts.User.
    - Both generated by lib/gen_anna_b402.py; pad positions checked against
    the datasheet drawing and the reference design, keepout verified by DRC
    on a test board.
    - D-22: the 0.16 mm counterpoise offset is from the module body, not the
    board edge. C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
2026-11-09 Rev A schematic, floorplan and board decisions D-22…D-27
    Schematic (generated by gen_schematic.py) is complete for rev A: power
    input, TP4054 charger, TPS7A0233 LDO, ANNA-B402 with 32.768 kHz crystal,
    PAM8904E buzzer driver, white LED with 2N7002, button, LIS2DH12 on I2C
    and 1 kOhm UART resistors. Every BOM symbol carries its LCSC part
    (22 unique lines). ERC: 0 errors, 0 warnings; the one intentional
    exclusion (LIS2DH12 SA0 tied to +3V3) is written into the project file
    by the generator.
    Library: generators for simple symbols and footprints (PAM8904E QFN,
    CPT-1117-83, CPT-9019A, bottom wire and SWD pads).
    Floorplan script checks placement by courtyard DRC; the chosen layout
    w16b gives 16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
    [cricket-tag.kicad_sch]
2026-11-10 Rev A PCB layout 17 × 32 mm, routing scripts, D-28
    - Board generated from the schematic and floorplan variant w17d (17 × 32 mm),
    routed with Freerouting 2.5 and finished with project tools (maze router,
    fanout, connect/repair, GND stitching); DRC 0 incl. schematic parity, ERC 0.
    - route.sh runs the whole pipeline; Freerouting is not deterministic, so the
    committed board was finished by hand with the same tools.
    - D-28: PAM8904E EN2 tied to VBAT (pad 40 free), SWD escape via vias under
    the module, D-24 escape count corrected, board size 17 × 32.
    - Project DRC rules and net classes for JLCPCB 2-layer (0.5/0.3 vias).
    - Docs, pin map, floorplan variants and renders updated.
    Co-Author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
    [cricket-tag.kicad_pcb, cricket-tag.kicad_sch]
2026-11-10 Review fixes: SWD pad labels, stale docs, bring-up measurement checklist
    - Board: silkscreen labels V, IO, CK, G at the SWD pads J3 (gen_pcb.py --swd-labels), bottom render updated
    - Docs: status, DRC minimums, board and panel sizes, extended parts list, removed JST links
    - manufacturing.md: measurements to take on the first boards
    - firmware/README.md: disable UART without 5 V, 1x buzzer mode while charging
    - .gitignore: __pycache__
    [cricket-tag.kicad_pcb]
2026-11-10 README: schematic and board images
2026-11-10 Switch module to ISP2454-LX (nRF54L15), D-29
    Replace u-blox ANNA-B402 with Insight SiP ISP2454-LX: new symbol and
    footprints (lib/gen_isp2454.py), new pin map, schematic without the
    external 32.768 kHz crystal and module decoupling, board 17 × 32 mm
    re-routed (floorplan isp_c, finish_driver.py for the PAM8904E wiring).
    ERC 0, DRC with schematic parity 0, 0 unconnected.
    Review against datasheet isp_ble_DS2454 R7: pinout and pad positions
    match; docs cleaned of stale ANNA-B402 guidance, BOM count 22 -> 20,
    LFXO 19 pF load capacitance, manufacturer range figure and MSL noted.
    [cricket-tag.kicad_pcb, cricket-tag.kicad_sch]
2026-11-10 Recalculate cost for ISP2454-LX, refresh schematic image, drop stale ANNA-B402 mentions
    cost.md: two columns by module price (tray ~5.9 $ / reel ~11.5 $),
    BOM 22 -> 20 positions, fixed costs ~64 $. schematic.png regenerated
    (LED on pad 46). ANNA-B402 references removed from README and docs
    where they no longer apply; decision log and module comparison kept.
2026-11-10 Add JLCPCB fab outputs and live quote, D-30
    make_fab.sh builds the gerber zip, BOM and CPL for JLCPCB. Rotation
    corrections are keyed by LCSC part, checked against the JLCPCB placement
    preview (U2, U3, Q1, U5); the BOM Comment is ASCII because JLCPCB misreads
    UTF-8.
    cost.md now uses the live JLCPCB quote: 144 $ for 8 boards without module
    and buzzer, ~250-285 $ with them via Global Sourcing. manufacturing.md
    records the ordering steps, the IP-based assembly restriction, delivery to
    China and how Global Sourcing works. D-30: delivery to a forwarder in
    Guangdong, 2x2 panel with 18 mm rails, module and buzzer via Global
    Sourcing.
    [bom.csv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]
2026-11-10 Quote NextPCB as an option, routed panel instead of V-cut, D-31
    The vendor for the first order is not chosen yet. PCBWay blocks
    Kazakhstan and JLCPCB hides assembly for it; NextPCB quotes 8 turnkey
    boards at 322 $ with the new-customer promo (522 $ without), shipping to
    the forwarder in Guangdong not yet quoted. Both quotes and the other
    vendors that are open for Kazakhstan are recorded as options.
    A DRC pass with a 0.4 mm edge rule finds copper 0.20-0.39 mm from the
    board edge in 52 places, so V-cut is unsafe: panels are routed with mouse
    bites and depaneled at the factory (owner's call). manufacturing.md
    wrongly said V-cut was fine; fixed.
    make_fab.sh also writes bom-mpn.csv (manufacture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
    [bom-mpn.csv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]
2026-11-10 Record quotes by batch size, Seeed Fusion and first-order coupons
    NextPCB: 1 board 175 $, 2 194 $, 4 232 $, 8 322 $ with the calculator
    promo; each extra board adds ~19 $, the module is 14.30 $. Seeed Fusion:
    1-2 boards ~250-275 $ including an estimate for the module, which is
    still under manual review there; shipping is free. Fixed costs (~90 $ of
    boards, ~70 $ setup) dominate, so 3-4 boards is the recommended rev-0
    batch. Coupons: NextPCB one-time -500 $ Rev0 SMT (stacking unknown),
    Seeed -50 $ new customer. The vendor is still not chosen.
2026-11-10 Firmware skeleton: own search mechanism on nRF54L15 DK (D-32 step 1)
    Cricket Coded S8 and Cricket 1M connectable advertising sets at +8 dBm with
    the payload from docs/protocol.md, GATT status/control (FIND, SILENCE),
    buzzer and flash patterns, button with short/3 s/8 s actions, and the mode
    state machine from concept.md. DK buttons simulate 5 V, armed and impact.
    Builds on SDK v3.4.2 via firmware/build.sh; not run on hardware yet.
    [adv.c, adv.h, battery.c, battery.h, buzzer.c, buzzer.h, gatt.c, gatt.h]
2026-11-11 Board definition for cricket-tag (ISP2454-LX), board inputs in the app
    firmware/boards/cricket/cricket_tag describes the rev A pin map: MSP on
    UARTE30, LIS2DH12 on TWIM21 over the former NFC pads (board.c clears
    NFCT.PADCONFIG, which Zephyr does only on nRF54H), buzzer on PWM20 with EN1,
    flash LED, button, VIN_SENSE, CHRG_N and the VBAT divider on AIN3. LFXO is
    set to 18 pF: the datasheet asks for 19 pF but the nRF54L SoC code caps it
    at 18. Logs go over RTT since the only UART is the MSP link.
    The app now takes 5 V from VIN_SENSE (also a System OFF wake source),
    polls CHRG_N, keeps the PAM8904E in 1x while charging and refuses SHIP
    with 5 V present. Both cricket_tag and the DK build via fi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
    [buzzer.c, buzzer.h, inputs.c]
2026-11-11 Record NextPCB and Seeed responses to the 8-board quotes
    NextPCB approved the quote: 371 $ to pay, including SF shipping to the
    Guangdong forwarder (3.30 $) and 42.69 $ Chinese VAT that applies to a
    China address; payment is Alipay in CNY only. No engineering questions,
    no answer to the notes yet.
    Seeed confirmed all 20 parts at 520.70 $ (module 14.33 $, assembly rose
    from 108 to 204 $), free shipping, ~470 $ with the new-customer coupon.
    Nothing paid; the vendor is still not chosen.
2026-11-11 MSP client and LIS2DH12 impact detection
    msp.c polls the flight controller over MSP v1 while 5 V is present:
    MSP_BOXIDS finds the ARM bit, MSP_STATUS every 250 ms gives armed (repeated
    once a second as a heartbeat), MSP_RAW_GPS every second gives the last fix.
    Without 5 V the UART is suspended so TX cannot feed an unpowered FC.
    impact.c uses the Zephyr LIS2DH12 driver: any-motion on INT1 with the
    high-pass filter, 16 g, 400 Hz, 8 g threshold (CONFIG_CRICKET_IMPACT_MG),
    active only on the drone. Both are enabled by devicetree aliases, so the DK
    build is unchanged; msp-dk.overlay puts MSP on the DK's UART30 for testing
    with a real FC. On 5 V return the last armed state and impact are forgotte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
    [impact.c, impact.h, modes.c, msp.c, msp.h]
2026-11-11 MCUboot and firmware updates over BLE behind a DFU window
    Sysbuild adds MCUboot (two slots, swap; partitions from devicetree, 62 KB
    loader, 712 KB slots). MCUmgr SMP over Bluetooth with the image and OS
    groups and a 498-byte MTU. An SMP command hook refuses every command unless
    the DFU window is open: hold the button 3 s from power-up, the window lasts
    5 min and each accepted command extends it by a minute; advertising flag 6
    shows it. The app confirms a new image once Bluetooth and the modes are up,
    so MCUboot reverts an image that dies earlier.
    Images are signed with the SDK's default MCUboot key for now; the README
    says how to switch to a private key before boards leave the owner.
    Co-Au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
    [dfu.c, dfu.h, inputs.c, main.c, modes.c, modes.h, status.h]
2026-11-11 Bonding with the owner's phone; commands and SMP need an encrypted link
    pair.c accepts new pairing (LE Secure Connections, Just Works) only inside a
    60-s pairing window opened by holding the button 3 s or by the DFU hold at
    power-up; bonds (up to 4, oldest overwritten) live in ZMS on the storage
    partition. The control characteristic and the MCUmgr SMP transport now
    require encryption, so only a bonded phone can send FIND, SILENCE, the new
    DFU (open the update window) and FORGET (drop all other bonds) commands or
    upload firmware. Advertising and the status characteristic stay open.
    Flag 7 in the payload shows the pairing window.
2026-11-11 Accept FIND from unbonded phones while the beacon is alarming
    The control characteristic now checks encryption per command: FIND (capped
    at 60 s) is accepted from any phone in ESCALATE, ALARM or BEACON so a helper
    can make a crashed drone beep; every other command, and FIND outside an
    alarm, still answers "insufficient encryption", which makes Android offer
    pairing (accepted only in the pairing window). Owner's decision.
    [gatt.c]
2026-11-11 Watchdog and low-power release build
    wdog.c arms WDT31 for 30 s, fed by the mode tick (at most 10 s apart), kept
    running in sleep and paused only under a halted debugger; it is stopped
    before System OFF so it cannot wake the beacon out of SHIP, and a watchdog
    reset is logged at the next start. The DK overlay enables wdt31.
    Low power: edge interrupts for the button, VIN_SENSE and accelerometer INT1
    use the GPIO SENSE mechanism (sense-edge-mask) instead of GPIOTE event
    channels, on the board and on the DK. app/release.conf drops the log,
    console, RTT and boot banner for current measurements; RTT is now the
    default log backend of the cricket-tag board through app/Kconfig instead of
    the board f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
    [main.c, modes.c, wdog.c, wdog.h]
2026-11-11 Do not name the DK current-measurement connector without checking it
2026-11-11 Bluetooth settings from the app: name, TX power, intervals per mode
    A bonded phone reads and writes a TLV list on the new settings
    characteristic: device name, TX power of the Coded and 1M sets, their
    intervals in each mode and the calibrated RSSI at 1 m. Settings are
    validated as a whole (every mode keeps at least one set on), applied at
    once and kept in the settings partition; command DEFAULTS resets them.
    D-34, docs/protocol.md «Настройки».
    [adv.c, adv.h, config.c, config.h, gatt.c, gatt.h, status.c]
2026-11-11 Alarm on an abnormal flight end with 5 V present; BEEPER switch
    After a failsafe, a disarm in the air or a crash that keeps the battery
    attached, the drone lies powered and disarmed: the tag stayed quiet and
    later took the drained battery for a normal unplug. Now, with 5 V still
    present, it raises ESCALATE when MSP showed failsafe in the flight or at
    the disarm, when a free fall, impact or GPS speed comes with the disarm,
    or when the RC link stays lost for 30 s after a flight. The Betaflight
    BEEPER switch makes the tag beep while disarmed; switching it off
    silences the alarm. MSP_STATUS parsing follows Betaflight 4.5 sources:
    BEEPER/FAILSAFE mode bits and the arming disable flags. MSP and th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
    [impact.c, impact.h, inputs.c, modes.c, modes.h, msp.c, msp.h]
2026-11-11 FC reboot, flyaway, preflight beep, flight without MSP, owner contact
    - MSP silent over 2 s while armed and then disarmed: the FC restarted
    in flight, raise the alarm. 5 V back within 10 s after a loss in
    flight keeps the alarm and the flight; armed again ends it.
    - Armed without RC link (failsafe, RXLOSS): radio on, the GPS fix is
    advertised every 2 s.
    - Preflight beep 5 s after 5 V comes: ok, tag battery below 3.7 V, or
    no MSP answer; can be turned off from the app.
    - Without MSP, motor vibration from the accelerometer stands for armed.
    - Position age in the payload (protocol v2, 24 bytes).
    - Owner contact (settings key 0x05) on a new characteristic, open to
    anyone while the beac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
    [adv.c, adv.h, buzzer.c, buzzer.h, config.c, config.h, gatt.c, impact.c]
2026-11-11 Plan the BLE to MSP gateway for Betaflight Configurator
    Document what Configurator expects (Nordic UART Service, but it writes
    to ...0003 and listens on ...0002, the reverse of Nordic's NUS), what the
    SDK sample and library give and why they are not used as is, the design
    and the order: DK check of MSP first, then the stock sample against
    Configurator, then our own gateway.
2026-11-11 Fix firmware review findings: 10 s advertising, silence on 5 V, false alarms
    - adv: clamp the interval window to 10.24 s, the host refused the 10 s
    LOW_BAT interval and the set kept the previous mode's rate
    - adv: set TX power after the advertising parameters; restart a set as
    soon as a phone connects through it, on the system work queue
    - modes: silencing an alarm with 5 V present returns to ON_DRONE instead
    of STANDBY, so the next flight is watched
    - modes: "never happened" timestamps no longer count as an impact, fall
    or failsafe around a disarm early after boot
    - modes: arming stops the buzzer (BEEPER switch, preflight beep)
    - modes: no battery reading while the buzzer plays; no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
    [adv.c, modes.c, msp.c]
2026-11-11 Record the SCSPCBA quote for 4 assembled boards
    SCSPCBA is the only other Chinese vendor found with automatic turnkey
    quoting: one 2x2 panel, depanelled by the factory, 79 $ before the seven
    lines its BOM matcher did not find (module included). The quote sits in
    the cart, not submitted yet.
2026-11-12 Record the SCSPCBA review of quote SCS261112-1000-A
    All 20 BOM lines sourced by exact MPN, 159.83 $ to pay for 4 boards
    incl. UPS to the forwarder. Open points before payment: routing with
    mouse bites, panel drawing, X-ray, struck-out bare board test.
2026-11-12 Ignore IDE files, keep Xcode's rewrite of the iOS project
    .gitignore: .idea/, *.iml, .vscode/ and .claude/settings.local.json.
    The iOS project files were rewritten by the tools, not by hand:
    project.pbxproj and Runner.xcscheme went back to objectVersion 54 and
    LastUpgradeCheck 1510, Main.storyboard was resaved by Xcode in its
    current format.
2026-11-12 Tidy the tag layout and review schematic and routing (D-40, D-41)
    D-40: a specialist flagged messy copper and odd bottom pads.
    - Wire pads J1/J2 (hand-soldered): foreign copper kept 0.3 mm away by
    no-pour areas and the DRC rule wire_pad_clearance; the GND sliver and
    via between the battery pads are gone, driver pre-routes redrawn.
    - tidy.py: drops GND tracks lying inside the pour (119 of 126), track
    dust inside pads and grid staircases, widens thin tracks where there
    is room. Track segments 657 -> 329.
    D-41: schematic checked against the PAM8904E, ISP2454-LX and nRF54L15
    datasheets, no changes. Layout: second GND via inside battery-minus pad
    J2.2 (it used to reach ground through a s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
    [cricket-tag-B_Cu.gbl, cricket-tag-B_Mask.gbs, cricket-tag-B_Paste.gbp, cricket-tag-B_Silkscreen.gbo, cricket-tag-Edge_Cuts.gm1, cricket-tag-F_Cu.gtl, cricket-tag-F_Mask.gts, cricket-tag-F_Paste.gtp]
